wspoolcover/toldos/cortijo/muebles_disponibles.png

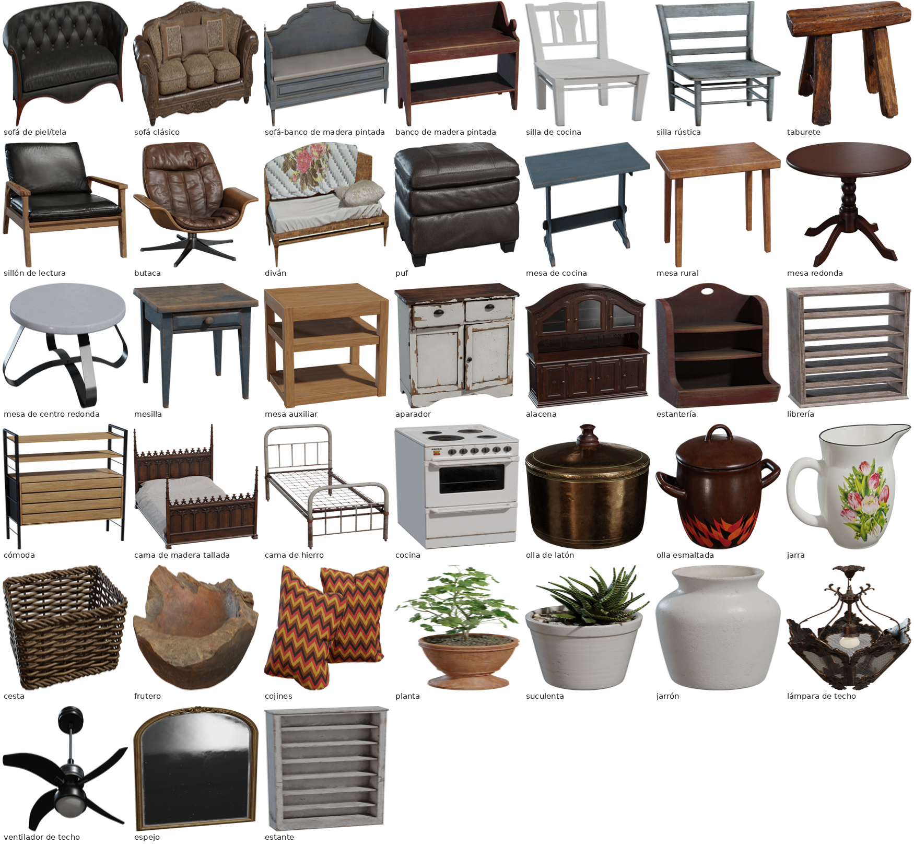
cortijo/muebles_disponibles.png
