wspoolcover/toldos/cortijo/render_entrada_escalera.png

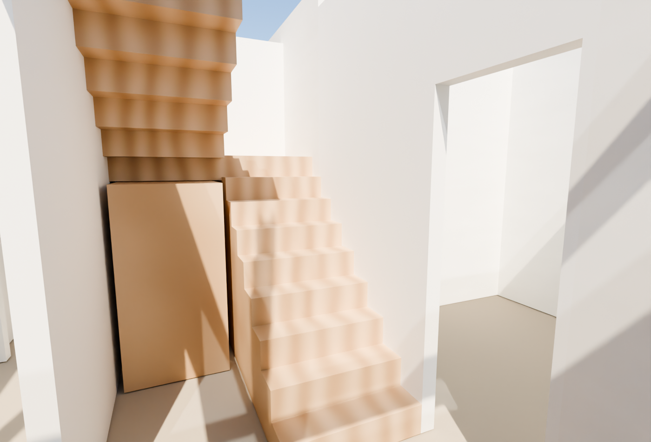
cortijo/render_entrada_escalera.png
