wspoolcover/toldos/cortijo/docs/08_presupuesto_y_ahorro.md

# Presupuesto orientativo y plan de ahorro (v7; la v8 mueve la escalera y la cocina pero no cambia las partidas, 13-10-2026)

Rangos de referencia en España 2026 para unos 172 m² construidos (109 m² útiles abajo + 63 arriba + terraza de 43 m²). **No es un presupuesto de contratista**: sirve para ordenar decisiones y pedir ofertas comparables. IVA no incluido (en rehabilitación de vivienda puede aplicarse el 10 %: consúltalo).

## 1. Partidas con la opción elegida (lo más barato que no baja la calidad)

| Partida | Opción elegida | Rango (€) | Alternativa cara descartada |
|---|---|---|---|
| Demolición cubierta, forjado y escalera (PL-05) | Elemento a elemento con apeos; acopio de vigas de madera para reutilizar | 6.000–10.000 | — |
| Cimentación: 6 zapatas 1,5 m, riostras, zuncho inferior, drenaje + geotextil | HA-25, B500S | 7.000–11.000 | — |
| Estructura metálica (3,7 t HEB/IPE + placas y anclajes) | Perfiles de serie, uniones atornilladas en obra | 11.000–20.000 | Primer diseño: 6,7 t |
| Forjados vigueta + bovedilla EPS (≈ 190 m²) y zunchos | (17+5) casa y cubierta, (25+5) salón | 11.000–17.000 | Chapa colaborante |
| Muros nuevos del salón (ladrillo 25 cm) + pilares de atado | Lo haces tú | 3.000–5.000 (material) | — |
| Cubierta plana: impermeabilización + XPS 10 cm + grava/sedum | Invertida, sedum solo en zonas libres | 9.000–14.000 | Césped natural (+5.000) |
| SATE transpirable 8 cm (lana mineral o corcho sobre mortero de cal), fachadas libres (≈ 220 m²) | Tapial: no usar EPS pegado | 11.000–17.000 | SATE en medianeras (+4.000) |
| Ventanas y cristalera (**PVC** con lámina de madera, bajo emisivo, control solar en sur, contraventanas) | **A precio de coste por WS Ventanas** | 6.000–10.000 | PVP: 12.000–18.000 |
| Tabiquería (ladrillo hueco doble o placa de yeso) | Placa de yeso con lana: más rápida y lleva las instalaciones | 5.000–8.000 | — |
| Solera + suelo radiante PB (109 m²) + mortero | Tubo PE-X paso 15 cm, 3 cm aislante | 6.000–9.000 | — |
| Aerotermia 8 kW + acumulador ACS 200 L + colector | Unidad exterior en la cubierta | 8.000–12.000 | Caldera de gasóleo + depósito |
| Multisplit planta alta (1 exterior + 4 interiores 2,5 kW) | Inverter A++ | 3.500–5.500 | Suelo radiante arriba (+6.000) |
| Fotovoltaica 7,2 kWp (16 paneles) + inversor 6 kW + batería opcional | Sin batería al principio | 7.000–10.000 (batería +4.000–6.000) | — |
| Electricidad completa (9,2 kW, 13 circuitos, red Cat 6, TV) | Mecanismos de gama media | 7.000–11.000 | Domótica (+3.000–8.000) |
| Fontanería y saneamiento (PPR, PVC, 3 húmedos, fosa) | Baño sobre baño: una columna | 5.000–8.000 | Fosa nueva si no vale (+3.000–5.000) |
| Chimenea insert 7 kW + humero doble pared | Leña | 3.000–5.000 | — |
| Cocina en U (muebles y encimera, sin electrodomésticos) | Módulos de serie | 3.500–6.000 | A medida: 9.000–15.000 |
| Baños (3) y vestidor: sanitarios, grifería, alicatado, armarios | Gama media; ducha de obra | 9.000–14.000 | — |
| Solados, alicatados, pintura, falsos techos, escalera de acero | Porcelánico gama media | 14.000–22.000 | — |
| Honorarios: arquitecto (modificación de proyecto), estructura, dirección, geotécnico, licencia | — | 9.000–15.000 | — |
| **Total orientativo** | | **≈ 140.000–225.000 €** | |

Con mano de obra propia en muros, pérgola, pintura y montaje de ventanas se puede bajar **15.000–30.000 €** más. El rango es amplio porque faltan geotécnico, catas y ofertas.

## 2. Ahorros aplicados ya en el diseño

1. Estructura: −3 t de acero respecto al primer diseño (≈ 6.000–16.000 €).
2. Ventanas a coste (≈ 6.000–8.000 €).
3. Cocina de serie en U, sin isla (≈ 5.000 €).
4. Baño sobre baño: una sola columna de bajantes y montantes cortos (≈ 1.000 €). Desde la v8 la cocina ya no está pegada al baño grande: su bajante va aparte al colector enterrado (unos 300 € más de tubería, estimación mía).
5. Splits arriba en vez de suelo radiante (≈ 6.000 €).
6. Sedum en vez de césped natural (≈ 5.000 € y sin riego).
7. SATE solo donde no hay vecino (≈ 4.000 €).
8. Armarios empotrados en tabiques de placa (≈ 2.000 € frente a armarios de mueble).
9. Sin batería al principio: la fotovoltaica cubre aerotermia y aire acondicionado de día; batería solo si la factura nocturna lo justifica.

## 3. Lo que no recomiendo recortar
Zunchos, riostras, zapatas, drenaje y geotextil, impermeabilización, aislamiento de cubierta, protección contra sobretensiones, toma de tierra en cimentación, toma de aire exterior de la chimenea, ventilación mecánica de los baños y la cocina.

## 4. Suelo radiante en los dormitorios: ¿sí o no?
- **Planta baja: SÍ**, en toda la planta (dormitorio principal, dormitorio 2, despacho y vestidor incluidos). La losa es la misma, el tubo cuesta ≈ 25–35 €/m² más y los dormitorios quedan a la misma temperatura que el resto sin radiadores. En verano el mismo circuito «refresca» (agua a 18-20 °C) de forma suave.
- **Planta alta: NO.** Motivos: (1) los dormitorios de arriba reciben el calor de la cubierta y necesitan **frío real** en verano, que el suelo radiante no da; (2) el forjado de vigueta está calculado con 1,2 kN/m² de pavimento: 6-7 cm de mortero + tubo suman ≈ 1,5 kN/m² más y habría que recalcular vigas y forjado; (3) un multisplit da frío y calor por 3.500–5.500 €. Si en el futuro se quiere más confort arriba, se añaden radiadores de baja temperatura a la aerotermia (ya se dejan los pasos de tubería previstos).
