wspoolcover/toldos/cortijo/pdf/Pedido_hierro_zunchos.pdf

# Pedido de hierro · zunchos, riostras y suelo

Acero corrugado B 500 S. Armados de la propuesta (docs/10); los confirma el técnico. Longitudes sacadas del modelo de la casa.

### Lo que hay que pedir

Qué | Se pide en | Cantidad | Metros | Kilos
Barra corrugada Ø16 (zunchos y riostras) | barras de 12 m | 111 | 1320 | 2083
Cercos Ø8 (cuadrados, cortados y doblados) | cercos | 1005 | 1419 | 560
Mallazo 15×15 Ø6 (suelo PB, 113,8 m² + 10 %) | paneles 2,20 × 6,00 | 10 | — | 391

### Por zuncho

Elemento | Largo | Sección | Ø16 a pedir | Cercos Ø8
RI-1 riostras (entre zapatas y muros) | 30.6 m | 40 × 50 cm | 269 m | 162 de 1.71 m
ZH-1 zuncho de los muros de 55 cm: forjado de planta alta | 34.3 m | 55 × 30 cm | 302 m | 242 de 1.61 m
ZH-2 zuncho de los muros del salón (terraza) | 20.8 m | 25 × 30 cm | 183 m | 147 de 1.01 m
ZH-1 zuncho de los muros de 55 cm: cubierta | 34.3 m | 55 × 30 cm | 302 m | 242 de 1.61 m
Muro exterior: 30 m más (25×30, como ZH-2) | 30.0 m | 25 × 30 cm | 264 m | 212 de 1.01 m
TOTAL | 150.0 m | | 1320 m | 1005

### Medida de los cercos

Zuncho | Medida interior (cm) | Largo de corte | Armado
RI-1 riostras (entre zapatas y muros) | 34 × 44 | 1.71 m | 4Ø16 + 4Ø16, cercos cada 20 cm
ZH-1 zuncho de los muros de 55 cm: forjado de planta alta | 49 × 24 | 1.61 m | 4Ø16 + 4Ø16, cercos cada 15 cm
ZH-2 zuncho de los muros del salón (terraza) | 19 × 24 | 1.01 m | 4Ø16 + 4Ø16, cercos cada 15 cm
ZH-1 zuncho de los muros de 55 cm: cubierta | 49 × 24 | 1.61 m | 4Ø16 + 4Ø16, cercos cada 15 cm
Muro exterior: 30 m más (25×30, como ZH-2) | 19 × 24 | 1.01 m | 4Ø16 + 4Ø16, cercos cada 15 cm

### Aparte, si se necesita en el mismo pedido

Qué | Metros | Barras de 12 m | Kilos
Parrilla de las 4 zapatas: Ø12 cada 15 cm en los dos sentidos | 258 | 22 | 229
Pilares de atado (≈ 22 uds): 4Ø14 de 3,9 m | 360 | 31 | 435
Cercos Ø6 de los pilares de atado (cada 15 cm) | 483 | — | 107

Cómo está calculado: barras con +10 % por solapes (unos 50 diámetros, 80 cm en Ø16), esquinas y mermas; cercos con +5 %; medida interior del cerco = ancho y canto menos 3 cm de recubrimiento por lado, y largo de corte = perímetro + 15 cm de ganchos. Los 30 m del muro exterior están calculados como zuncho de 25 × 30 con 4Ø16 + 4Ø16 (como el del salón). Si lleva otro armado, hay que recalcularlo.
El zuncho de los muros de 55 cm se hormigona en dos niveles (forjado de planta alta y cubierta). Si ahora haces solo el suelo, pide las filas de suelo y forjado.
Más ligero: con el armado del primer dossier (4Ø12 / 6Ø12) zunchos y riostras pesarían unos 825 kg, frente a 2143 kg de este armado.
