wspoolcover/toldos/cortijo/docs/21_adaptar_el_proyecto_a_la_realidad.md

# Adaptar el proyecto visado a la casa que se construye (04-11-2026)

El proyecto visado (PL-04 a PL-11, 22-09-2025) es el punto de partida. La casa que se construye es la del modelo v8, con las medidas del propietario y ampliada. Este documento lista **qué hay que cambiar en cada lámina** y **con qué datos**. No sustituye al arquitecto: es el material de trabajo para pasárselo.

## 1. Estado de obra: muros, forjado y tejado caídos (aviso del propietario, 04-11-2026)
Sobre la lámina PL-05 (fase 3) el propietario marca, y confirma por escrito:
- **Han caído**: el **muro norte de la casa** (el que separa el porche de la casa), el **muro central** («muro existente» de PL-11), el **forjado de la planta alta** (suelo de la planta 1, techo de la planta 0) y el **tejado**.
- **Según la marca del propietario, siguen en pie el muro este y el muro sur**, formando una L.
- **Foto interior (04-11-2026, mirando al sur desde dentro)**: se ve el suelo de tierra, sin solera; el **muro sur** al fondo, con dos ventanas y una puerta de doble hoja, en planta baja y con un tramo más alto en el centro; un **muro alto a la derecha**, con restos de tejas del vecino en lo alto; y un **muro alto a la izquierda**, con el conducto oscuro de una chimenea y el borde superior inclinado con restos de teja. En la base del muro de la izquierda hay huecos y falta revoco. Al pie del muro de la derecha hay una pequeña armadura en espera. **Pendiente**: confirmar cuál es cada muro (este, oeste, vecinos) y si el de la izquierda sigue en pie.
- **Pendiente de confirmar**: el **muro oeste** (no está marcado), la escalera y los muros nuevos del salón, si ya estaban levantados.

**Riesgo principal: los dos muros en pie están sueltos.** Con unos 6 m de altura (dos plantas) y 55 cm de espesor, la esbeltez es de 10–11, casi el doble del límite de 7 que fija el propio proyecto (PL-05, ADD-13: unos 3,85 m para muros de 55 cm sin arriostrar). Han perdido el forjado y los muros que los sujetaban. El muro este es medianera con la casa vecina.
1. **Zona de exclusión**: nadie a una distancia menor que la altura del muro (unos 6 m), por ninguno de los dos lados, hasta que lo revise un técnico. Con viento o lluvia, más.
2. **No tocar ni empujar** esos muros, ni trabajar en su base, ni sacar escombros pegados a ellos.
3. **Apeo provisional** (puntales inclinados con su anclaje) diseñado por el arquitecto o un ingeniero, o derribo controlado si lo decide. Lo hace una empresa con técnico.
4. **Avisar ya al arquitecto** (director de obra) y al seguro de obra, si lo hay. Si los muros se inclinan, se abren grietas o hay personas viviendo en las casas pegadas, avisar a la Policía Local o al 112. Esto último es una precaución; no sé valorar el riesgo real sin verlos.
5. **Documentar**: fotos de todos los lados y de las grietas, fecha y hora, qué pasaba (obra, lluvia, viento). No retirar escombros sin fotos.
6. **Cubierta**: si el tejado llevaba placas onduladas de fibrocemento, no se rompen ni se barren; las retira una empresa autorizada.

Lo que cambia en el proyecto:
- **PL-05**: las fases 1 y 2 (demolición de la cubierta y del forjado) ya han pasado, pero sin control. La fase 3 («consolidación y recrecido de muros») pasa a ser **reconstrucción de los muros caídos y consolidación de los dos que quedan**.
- **PL-11**: el proyecto visado se apoyaba en el muro central, que ya no existe. Nuestra estructura (pilares HEB 120, vigas y forjados nuevos) no depende de los dos muros caídos, pero sí del **muro este y el sur**, que hay que comprobar, y del **oeste**, que hay que ver.
- **Encaje urbanístico**: es una pregunta para el arquitecto: si haber perdido los muros, el forjado y la cubierta cambia la naturaleza de la obra (de rehabilitación a reconstrucción) y qué tramitación exige. No sé responderla.
- **Cimentación**: bajo los muros caídos puede seguir su zapata, y hay que ver también la de los dos muros en pie. Cata antes de hormigonar la línea y = 7,60 (ver `19_comprobacion_cimentacion.md`).
- **Pedido 1 de hierro**: las cantidades de zapatas, riostras y zanja perimetral siguen valiendo. La zanja perimetral supone muros exteriores en todo el perímetro; si hay que reconstruir los del norte y el oeste, hay que decidir antes con qué.

## 2. Superficies de la casa que se construye (modelo v8)
Superficies útiles por estancia. La planta baja cambia algo según la opción elegida (A, B, C, C2 o D; ver `15_propuestas_planta_baja.md`); aquí va la base v8.

| Planta baja | m² | Planta alta | m² |
|---|---|---|---|
| Salón con comedor | 33,91 | Sala familiar | 12,03 |
| Pasillo de entrada (junto al salón) | 11,05 | Entrada | 3,50 |
| Entrada | 3,12 | Baño | 3,48 |
| Escalera | 4,62 | Dormitorio 1 | 13,19 |
| Baño grande | 5,76 | Dormitorio 2 | 16,77 |
| Sala de estar y paso | 11,07 | Dormitorio 3 / despacho | 14,80 |
| Cocina | 9,36 | | |
| Dormitorio principal | 12,09 | | |
| Dormitorio 2 | 9,73 | | |
| Despacho | 3,79 | | |
| Vestidor | 5,75 | | |
| Baño principal | 3,70 | | |
| **Total útil planta baja** | **113,94** | **Total útil planta alta** | **63,77** |

**Total útil: 177,71 m²**, más la terraza sobre el salón (42,42 m²).

| | Proyecto visado | Casa que se construye |
|---|---|---|
| Útil planta baja | 91,45 m² (con el porche de 23,49) | 113,94 m² |
| Útil planta alta | 63,63 m² | 63,77 m² |
| **Útil total** | **155,08 m²** | **177,71 m²** |
| Terraza | 23,00 m² | 42,42 m² |
| Construida | 200,00 m² (PB 115,35 + PA 84,65) | **≈ 233 m²** por huellas: PB 142,4 (casa 94,5 + salón 47,9) y PA 90,3 |

La superficie construida es mía, por las huellas exteriores; el arquitecto la calcula con su criterio (terrazas, porches, muros).

## 3. Qué hay que cambiar en cada lámina
| Lámina | Qué hay que cambiar | Datos nuestros que sirven |
|---|---|---|
| **PL-04** estado actual | Lo que había antes de caer los muros. Añadir el estado actual de obra y los muros caídos | Fotos y medidas de obra (pendientes) |
| **PL-05** fases | Nueva secuencia: muros caídos, apeos, cimentación nueva (zanja perimetral, riostras, zapatas), estructura de acero, forjados, salón. La fase 3 («consolidación y recrecido») cambia | `docs/16_ideas_de_obra_referencia.md` y el orden de obra del primer borrador (`dossier_obra.pdf`, hoja 6) |
| **PL-06** distribución y superficies | Plantas, alzados y sección nuevos: salón cerrado, distribución de la v8 (o la opción elegida), cubierta plana con paneles | `lamina_A1_v8_distribucion.dxf`, `planta_baja_v8.dxf`, `planta_alta_v8.dxf`, `seccion_A_v8.dxf`, `seccion_B_v8.dxf`, cuadro del apartado 2 |
| **PL-07** cotas y carpintería | Cotas nuevas, memoria de carpintería (puertas de seguridad, cristalera de aluminio al patio, ventanas con asiento), detalle de fachada | `pedido_proveedores.xlsx` (huecos), planos `lamina_A1_v8_*`, `docs/03_envolvente.md` |
| **PL-08** fontanería y ventilación | Red nueva (baños agrupados, aerotermia, depósito, paneles solares) | `docs/02_instalaciones.md`, `instalaciones.png` |
| **PL-09** saneamiento | Colector Ø150, arquetas, fosa séptica y pozo filtrante con posición y capacidad | `docs/18_fosa_septica_y_pozo_filtrante.md`, `fosa_septica_esquema.png`, `pozo_filtrante_5m.png` |
| **PL-10** electricidad | Circuitos nuevos, aerotermia, paneles solares (7,2 kWp), electrificación elevada de 9,2 kW | `docs/02_instalaciones.md`, `cubierta_solar.png` |
| **PL-11** cimentación y estructura | Cimentación nueva (zapatas, riostras, zanja perimetral), pilares y vigas de acero en lugar del muro central, forjados, zunchos, escalera de hormigón y losa sobre el salón | `cimentacion_planos.png`, `cimentacion_anillos.png`, `lamina_A1_v8_estructura.dxf`, `estructura_planos.png`, `memoria_estructura.md`, `19_comprobacion_cimentacion.md` |

## 4. Lo que condiciona el proyecto adaptado
1. **Estado de los dos muros que quedan** (este y sur) y del oeste: inclinación, grietas, altura y qué los sujeta (fotos y medidas).
2. **Elección de la distribución de la planta baja** (A, B, C, C2, D o la económica).
3. **Estudio geotécnico**: el 130 kPa de PL-11 es supuesto. Recomiendo una calicata en una zapata y otra en el pozo filtrante, el mismo día.
4. **Cálculo de la estructura** de acero y de la losa sobre el salón (5,75 m), con ficha del fabricante, por un técnico competente.
5. **Fosa y pozo filtrante**: posición, capacidad y autorización de vertido.
6. **Comunicación con el arquitecto** sobre qué documentación necesita (modificado o proyecto nuevo).

## 5. Orden que propongo (el propietario quiere empezar ya con la cimentación y el hormigón)
Decisión del propietario (04-11-2026): empezar cuanto antes la cimentación y el hormigón, porque eso es lo que afianza los muros existentes. Es una secuencia razonable, con una precisión: **lo de abajo (zanja, zapatas) no sujeta la parte alta de los muros**; la sujetan los puntales ahora y el zuncho de arriba con los pilares y el forjado después. Además, abrir zanjas al pie de un muro suelto es el momento más peligroso. Por eso:
1. **Apeo mínimo de los muros altos antes de que entre nadie a trabajar** en la zona de peligro (en el plano cubre el 93 % del interior). Puntales inclinados; los define el arquitecto o un ingeniero.
2. **Cata puntual** para ver la zapata de cada muro antes de abrir la primera zanja junto a él: no se baja de la cota de su base.
3. **Zanja perimetral por bataches alternos** (`cimentacion_bataches.png`, 23 bataches de ≈ 1,5 m): uno sí y uno no, y cada uno se abre, se arma y se hormigona el mismo día. La segunda tanda, cuando la primera haya endurecido. HA-25/F/32/XC2 con limpieza de HM-20.
4. **Pedido 1 de hierro ya** (`pedido_1_hierro_cimentacion.xlsx`). Las barras de las zapatas y riostras de la línea y = 7,60, sin cortar hasta ver qué hay debajo.
5. **Riostras y zapatas** en el interior, donde ya no hay muros: es el tajo menos expuesto, pero sigue dentro de la zona de peligro hasta el apeo.
6. **Pilares de atado y zuncho de coronación** en los muros que queden, junto con los pilares HEB y las vigas: aquí es donde los muros quedan atados de verdad. El apeo se mantiene hasta entonces.
7. **Forjado y cubierta**. Los apeos se quitan solo cuando el técnico lo diga.
8. En paralelo: aviso al arquitecto, fotos y medidas de los muros, catas y estudio geotécnico.
