wspoolcover/toldos/cortijo/docs/01_documentos_disponibles.md

# Documentos del cortijo: qué hay y qué falta

Revisado en tu Drive el 12-10-2026. Carpeta **CORTIJO PISICA**: solo contiene los 10 planos del proyecto del arquitecto (Andrés Oller Rodríguez, expediente 25-029, julio 2025). No he abierto ni usado el contrato de arras ni ningún documento de la empresa.

> Las copias de la carpeta de Drive son una **versión anterior** al visado del 22-09-2025: en la versión visada la superficie construida total es de 200,00 m² (PL-06: PB 115,35 + PA 84,65). Las superficies de PL-04 y PL-06 son las del proyecto original. La casa **se ha agrandado**: las medidas válidas son las del croquis a mano del propietario, que son las que usa el modelo.

## Lo que hay (PL-01 a PL-10)
| Plano | Contenido | Para qué lo usamos |
|---|---|---|
| PL-01 | Situación PGOU, 1/15.000 | Ubicación: polígono 33, parcela 198, San Roque, Albox |
| PL-02 | Emplazamiento, ortofoto y catastro, 1/400 | Referencia catastral 04006A033001980001PG |
| PL-03 | Georreferenciación (14 puntos UTM) | Replanteo y orientación real del solar |
| PL-04 | Estado actual: 96,77 m² útiles PB + 68,06 PA = 164,83 m² útiles; construidos 200 m² | Superficies de partida |
| PL-05 | Fases: demolición de cubierta y forjado/escalera, consolidación y recrecido de muros, forjados nuevos | Orden de obra del arquitecto |
| PL-06 | Distribución reformada (PB 91,45 / PA 63,63 útiles; construidos 195,48 m²) | Es el plano que partimos |
| PL-07 | Carpintería: aluminio lacado blanco, vidrio 4/8/4 con persiana | Hay que mejorarla (ver envolvente) |
| PL-08 | Fontanería: PPR, termo de 100 L, intercambiador solar | Base de la red de agua |
| PL-09 | Saneamiento y pluviales: conexión a **fosa séptica** | Base de la red de desagües |
| PL-10 | Electricidad: esquema unifilar y circuitos | Base de la red eléctrica |
| PL-11 | **Cimentación y estructura** del arquitecto: forjados de vigueta T-20 con bovedilla de 20 cm (canto 25+5), vigas HEB-160 / HEB-220 / IPE-240, muro existente central, zunchos Z-1 de 40×30 con 4Ø12 arriba y 4Ø12 abajo y cercos Ø8/20, hormigón HA-25/F/32/XC2 en cimentación, acero B400S, recubrimiento de 80 mm contra el terreno, NCSE-02 ductilidad baja, **tensión admisible del terreno 0,13 MPa (130 kPa)** | Dato de terreno y secciones de referencia (está en el PDF visado `PLANOS_A1_R01_F_signed3.pdf`, no en la carpeta de Drive; ver `20_proyecto_original_y_diseno_actual.md`, donde se compara con la versión visada del 22-09-2025) |

## Lo que NO tenemos (hay que conseguirlo)
1. **Estudio geotécnico**: el único dato de terreno es el de PL-11 (130 kPa, «considerado», no medido). Hay que confirmarlo con un estudio.
2. **Cimentación existente**: ningún plano dice ancho, profundidad ni armado de la zapata de los muros de 0,55 m.
3. **Memoria de cálculo de la estructura** del arquitecto (solo tenemos el plano PL-11 con secciones y cargas, no el cálculo).
4. **Estado de los muros** (mampostería o ladrillo, humedades, grietas).
5. **Certificado/justificación energética** (DB-HE) y cálculo de la calefacción.
6. **Licencia, nota simple y mediciones o presupuesto de obra.**
7. **Zona sísmica del municipio** (NCSE-02): usamos 0,16 g como suposición.

Observaciones sobre los planos que conviene aclarar con el arquitecto:
- PL-10 titula los circuitos «electrificación elevada», pero la potencia que figura (5.375 W) corresponde a una electrificación básica. Con cocina de inducción, calefacción y aire acondicionado hay que contratar elevada (9,2 kW).
- PL-07 deja ventanas con vidrio 4/8/4 y aluminio sin rotura de puente térmico (no lo indica): no cumple lo que hoy se pone en obra nueva en la zona.

## Vecinos y linderos (dato del propietario, 12-10-2026)
- **Norte** (la parte estrecha del salón): el **acceso por el camino**, con entrada de unos 7 m con puerta corredera (hay un raíl de hormigón) y la acometida de agua. **Sur** (fachada ancha con la CGP): terreno propio hacia la **rambla de Albox**.
- **Este y oeste**: casas vecinas **pegadas** (medianeras), incluidos los muros laterales del salón. En PL-04 y PL-06 figuran como «VIVIENDA» y el saliente oeste como «encabalgamiento otra propiedad».
- Consecuencias aplicadas: **sin ventanas en los muros este y oeste** (se quitó la ventana este de la cocina, la del baño grande, la del baño de la suite y la este del dormitorio 3); los baños se ventilan con extractor; la unidad exterior de la aerotermia va al patio sur; la acometida de agua y la eléctrica entran por el sur y la fosa séptica está al norte, como en PL-08, PL-09 y PL-10.
- A comprobar: vistas sobre fincas vecinas a menos de 2 m (art. 582 del Código Civil), la altura de los parapetos de la terraza junto a las medianeras y quién construye cada medianera.
