wspoolcover/toldos/cortijo/docs/15_propuestas_planta_baja.md

# Propuestas para la planta baja (14-10-2026)

Cambios pedidos: cocina en medio más grande y amplia, con salida de aluminio al exterior; puerta del vestidor pegada al dormitorio, que abra hacia la derecha y sea una puerta buena; paredes y accesos de los dormitorios fuertes, de seguridad; dormitorio 2 más pequeño; ventanas pegadas al exterior del muro para hacer un asiento de lectura en el hueco. Planos: `modelos_planta_baja.png` (comparación) y `modelo_A_planta_baja.png`, `modelo_B_...`, `modelo_C_...`.

## 1. Lo que he buscado y lo que he encontrado
Las búsquedas dieron poco sobre casos concretos; lo que sigue es lo aprovechable y lo que sale de mi criterio. Lo que no he podido confirmar lo digo.

- **Cortijo y patio.** El cortijo tradicional se organiza alrededor de un patio, con las habitaciones a su alrededor y muros encalados ([Junta de Andalucía, inventario de cortijos](https://www.juntadeandalucia.es/sites/default/files/2021-09/cortijos_andalucia_2019.pdf); [Escapada Rural](https://www.escapadarural.com/blog/casas-rurales-tipicas-espanolas/)). De ahí la idea de abrir la cocina al patio sur con una salida grande. No he encontrado fuentes sobre el derrame de las ventanas en muros de tapial: eso lo decide quien haga la obra.
- **Asiento en la ventana.** Medidas habituales: banco de unos 38 cm más cojín de 8 cm (≈ 46 cm de asiento), profundidad mínima de 56 cm para una persona y 76–91 cm para estar cómodo, largo mínimo de 91 cm; cajones debajo para guardar ([This Old House](https://www.thisoldhouse.com/furniture/sitting-pretty-with-window-seats); [Living Etc](https://www.livingetc.com/ideas/window-seat-ideas)). Un muro de 55 cm con la ventana a 10 cm del exterior deja unos 40 cm de hueco: sirve para sentarse. Para leer con las piernas subidas, el banco puede salir 15–20 cm hacia la habitación (60 cm en total).
- **Salida de aluminio.** Las correderas de aluminio con rotura de puente térmico son lo habitual para grandes acristalamientos hacia un patio, con perfiles finos (≈ 21 mm de marco visto) y de dos a cuatro hojas ([IQ Glass](https://www.iqglassuk.com/projects/illidge-green-farm/s154192/); [NBS, Slide 2000](https://source.thenbs.com/product/slide-2000-patio-doors/traS3xBcJBHgR5pFBttXdm?lb=open)). Un fabricante cita U ≈ 1,6 W/m²K para el conjunto con el vidrio de su ejemplo; hay que pedir la ficha del producto concreto.
- **Puertas de seguridad.** La norma UNE-EN 1627 clasifica de RC1 a RC6 la resistencia al robo; RC2 resiste unos 3 min a un ladrón oportunista, RC3 unos 5 min (con palanca de 70 cm), RC4 unos 10 min. Una «blindada» suele ser RC2 o sin certificar; una «acorazada» (hoja y marco de acero como un conjunto) parte de RC3. El ensayo no garantiza el anclaje: una puerta RC4 mal anclada rinde como RC2, así que el marco debe ir anclado al muro ([Selectra](https://selectra.es/alarmas/medidas-seguridad/puerta-blindada-o-acorazada)). Datos de fuente comercial: contrastar con el fabricante.
- **Muros de seguridad.** No he encontrado fuente fiable con espesores. Lo que propongo abajo es criterio mío y lo debe validar el técnico.

## 2. Lo común a los tres modelos
- **Muros de seguridad de 15 cm** (hormigón armado HA-25 con doble malla Ø8/15, o bloque de hormigón de 20 cm relleno y armado, como el bloque gris de las fotos de referencia de `16_ideas_de_obra_referencia.md`; a decidir con el técnico) en: la pared del vestidor hacia la sala, la pared norte de la suite, la pared entre la suite y la cocina o el dormitorio 2, y, en el modelo A, las del dormitorio 2. En total unos 49 m² de muro en el modelo A y unos 32 m² en B y C. Orden de magnitud del sobrecoste frente a tabique: 4.000–7.000 € en A y 2.500–4.500 € en B y C (estimación mía; pedir presupuesto).
- **Puertas de seguridad (RC3, de acero, marco anclado al muro, bisagras antipalanca, cilindro con protección antitaladro)** en el vestidor (sala → vestidor), en la puerta de la suite al vestidor y en el dormitorio 2 si existe. Ancho 0,90 m.
- **Puerta del vestidor** (la que da a la sala): sube al extremo sur de la pared, pegada a la pared del dormitorio; bisagra en el lado derecho al entrar (el sur); abre hacia el vestidor y queda doblada contra la pared de la suite sin estorbar. La puerta de la suite al vestidor queda a un metro. *Si te referías a la puerta entre el vestidor y el dormitorio, dímelo y la muevo.*
- **Ventanas con asiento** en el muro sur (55 cm): ventana a ras del exterior (a 10 cm de la cara de fuera, con contraventanas de madera por fuera), banco de obra de 45 cm de alto con cajón, cojín y enchufe/luz de lectura. Suite: ventana de 1,30 m con asiento (rincón de lectura de Cristina) y otra de 0,90 m. Dormitorio 2 o comedor: otro asiento de 1,00 o 0,90 m. Las separaciones entre ventanas son de 55 cm como mínimo (en un muro de tapial no conviene menos).
- **Salida de aluminio al patio** desde la cocina (suelo a techo, vidrio laminado de seguridad, rotura de puente térmico, cierre multipunto) y el patio sur cubierto con una pérgola, con el mismo solado de barro cocido.
- **Cocina abierta a la sala de estar**, con paso libre (sin puerta) y despensa baja bajo la escalera, con puerta desde la cocina.
- Todo lo demás es la v8: escalera con el pie junto a la entrada, baño grande desde la entrada, armario técnico bajo la escalera.

## 3. Los tres modelos
| | **A · Dormitorio 2 pequeño y cocina al este** | **B · Cocina-comedor grande** | **C · Cocina central con despensa y lavadero** |
|---|---|---|---|
| Dormitorio 2 | **7,5 m²** (1,95 × 3,85 m, cama individual, armario de 45 cm, asiento en la ventana) | No hay abajo | No hay abajo |
| Cocina | 11,2 m² con mesa de comedor junto a la salida acristalada de 1,60 m | **19,6 m²**: cocina con isla y comedor, salida de 2,40 m y banco-asiento en la ventana | 13,4 m² con mesa; salida de 1,60 m y banco-asiento |
| Anexos | Despensa baja bajo la escalera | Despensa baja bajo la escalera | Despensa 2,0 m² y lavadero 3,7 m² con ventana |
| Paso sala ↔ cocina | 1,25 m | 3,05 m (dos huecos de 1,60 y 1,45 m) | 3,05 m (dos huecos de 1,60 y 1,45 m) |
| Dormitorios en la casa | 5 (suite + dormitorio 2 + 3 arriba) | 4 (suite + 3 arriba) | 4 |
| Ventaja | Cumple tu petición al pie de la letra | La cocina que pides: amplia y abierta | Cocina de cortijo con despensa y lavadero; el lavadero puede ser un cuarto de plancha o, más adelante, una habitación pequeña |
| Inconveniente | La cocina crece solo un 20 % (la escalera y el dormitorio 2 limitan) | Pierdes el dormitorio 2 de abajo | Pierdes el dormitorio 2 de abajo; menos «comedor» |

### Opción C2: el modelo C con el despacho girado (14-10-2026)
Pedido: cocina central y despacho girado, de la puerta del vestidor hasta la chimenea. Plano: `modelo_C2_planta_baja.png`; PDF de la opción: `pdf/Opcion_C_cocina_central.pdf`. Versión económica: `17_version_economica.md`.
- **Cocina central** de 13,4 m² abierta a la sala por dos pasos libres (1,60 y 1,45 m), con mesa, salida de aluminio de 1,60 m al patio sur y asiento de lectura en la ventana; despensa de 2,0 m² y lavadero de 3,7 m² al este.
- **Despacho girado**: pasa de 2,40 × 1,58 m (3,8 m²) a **1,80 × 2,65 m (4,8 m²)**, a lo largo de la pared del vestidor, desde la puerta del vestidor hasta la chimenea. Mesa larga contra la pared del vestidor, estantería y sillón de lectura junto a la puerta, y cristal fijo en el extremo norte hacia el salón y la chimenea. La puerta es desde la sala de estar, que baja de 11,1 a 10,1 m².
- Si quieres ver el fuego desde el despacho, la chimenea se gira o se hace de dos caras con cristal; lo dejo como opción.

### Opción D: suite a la izquierda, cocina en medio y dormitorio pequeño con armario bajo la escalera (15-10-2026)
Plano: `modelo_D_planta_baja.png`; PDF: `pdf/Opcion_D_suite_cocina_dormitorio.pdf`. Mantiene el despacho girado del C2.
- **Suite grande** (11,9 m²) a la izquierda, con el vestidor y su puerta de seguridad pegada al dormitorio y el asiento de lectura en la ventana.
- **Cocina en medio** de 9,4 m², abierta a la sala por un paso libre de 1,60 m, con salida de aluminio de 1,40 m al patio sur.
- **Dormitorio 2 pequeño** (9,5 m²) a la derecha, con puerta de seguridad desde la sala, cama de 1,50 m y asiento en la ventana.
- **Armario incorporado bajo la escalera** de unos 2,0 m², que se abre desde el dormitorio 2 con puertas correderas. Altura libre de 1,5 m bajo la meseta y de 1,5 a 2,1 m bajo el tramo de vuelta (prendas largas en la parte norte). Para ello la meseta pasa a ser losa y el armario técnico se traslada al rincón bajo el tramo de vuelta, junto a la entrada.

**Por qué no hay un modelo con la cocina en medio mucho más grande y el dormitorio 2 en el este:** el único acceso a esa zona desde la sala es un paso de 0,9 m (entre el pilar de x = 7,20 y el final del hueco de la escalera). Si la cocina avanza hacia el este, el dormitorio 2 se queda sin puerta. Por eso en el modelo A el dormitorio 2 pasa al centro y la cocina al este.

**Mi recomendación**: **B** si prefieres una cocina de verdad grande y puedes renunciar al dormitorio 2 de abajo (arriba ya hay tres dormitorios); **A** si quieres conservar cinco dormitorios. Cualquiera de los dos mantiene el paso libre de la sala a la cocina.

## 4. Muebles y estética (para los renders)
He bajado 38 piezas libres (licencia CC0, [Poly Haven](https://polyhaven.com), sin atribución obligatoria) en texturas de 1k: sofás, butacas, mesas y sillas de madera pintada, aparador, alacena, estanterías, cama de madera tallada y de hierro, cocina, ollas de latón, jarras, cestas, cojines, plantas, lámparas y espejo. Están en `muebles_disponibles.png` y se vuelven a bajar con `python descargar_muebles.py`. No hay armarios de cocina ni camas modernas libres de calidad: los hago yo en el modelo (frentes de madera, encimera de piedra, colchón con almohadas).

Paleta del render: cal blanca, piedra marés, madera oscura, barro cocido en suelos y exterior, hierro negro en rejas y barandillas. Estilo de cortijo andaluz con toques mallorquines (arcos rebajados en los pasos entre sala y cocina, vigas vistas en el salón).

## 5. Qué necesito de ti
1. **Modelo** A, B o C (o una mezcla, por ejemplo B con el lavadero de C).
2. Confirmar la **puerta del vestidor** (sala → vestidor) y su apertura.
3. Si «luminio» era **aluminio** (lo he entendido así: salida de aluminio) o **luminoso** (la salida grande y con mucha luz; el diseño sirve para las dos cosas).
4. Si en la planta alta quieres también **asientos en las ventanas** del sur y **paredes de seguridad** (ahora solo lo he aplicado abajo, como dijiste).

Con tu OK: modelo 3D v9 con el modelo elegido y los muebles reales, 6–8 renders (cocina, suite con el asiento, vestidor, salón, patio sur, exterior), planos DXF y el PDF actualizados.
