wspoolcover/toldos/cortijo/docs/17_version_economica.md

# Versión económica y rápida (14-10-2026)

Es la misma casa de la opción C2 (cocina central y despacho girado), con las decisiones que bajan el coste y el plazo **sin tocar la cimentación, la estructura, el aislamiento, la impermeabilización ni la seguridad de la suite**. Todas las cifras son estimaciones mías en miles de euros, sin IVA, y salen de `08_presupuesto_y_ahorro.md` y de los precios citados en `02_instalaciones.md` y `15_propuestas_planta_baja.md`. **No es un presupuesto**: sirve para ordenar decisiones y pedir ofertas comparables.

## 1. Reglas
- **No se recorta**: cimentación y drenaje, estructura y apeos, impermeabilización de la cubierta, aislamiento transpirable de las fachadas, instalación eléctrica y de agua, ventilación de baños y cocina, y la seguridad de la suite.
- **Se simplifica**: acabados, climatización, tamaño y número de elementos especiales, y se hace por fases.
- **Se usan sistemas rápidos**: bloque de hormigón en U para zunchos y dinteles (sin madera de encofrado), tabique de placa de yeso donde no hace falta seguridad, ventanas y puertas de medidas estándar pedidas al principio, multisplit en lugar de suelo radiante (no hay que esperar al curado del mortero).

## 2. Qué cambia y cuánto cuesta
| Partida | Qué cambia en la económica | Completa (mil €) | Económica (mil €) |
|---|---|---|---|
| Demolición y apeos | Igual: elemento a elemento, con apeos. | 6–10 | 6–10 |
| Cimentación y drenaje | Igual. No se recorta: zapatas, riostras, zunchos, drenaje y geotextil. | 7–11 | 7–11 |
| Estructura de acero | Perfiles en bruto de tu proveedor, cortados a la lista del Excel, y atornillados en obra. Dinteles de los muros nuevos con bloque en U en lugar de perfil. | 11–20 | 9–15 |
| Forjados y zunchos | Vigueta y bovedilla en todo (sin placas alveolares ni grúa). Zunchos con bloque en U, sin madera de encofrado. | 11–17 | 10–15 |
| Muros nuevos del salón y pilares de atado | Igual (material; mano de obra tuya). | 3–5 | 3–5 |
| Cubierta plana | Impermeabilización y aislamiento iguales; grava de lastre en vez de sedum. | 9–14 | 7–11 |
| Aislamiento transpirable de fachadas | Lana mineral de 6 cm en vez de 8 sobre mortero de cal, solo en fachadas libres. Nunca poliestireno pegado sobre el tapial. | 11–17 | 9–14 |
| Carpintería: ventanas y salida de la cocina | PVC de medidas estándar a precio de coste; salida de la cocina en PVC de 2 hojas de 1,40 m en vez de corredera de aluminio de 1,60 m. | 8–14 | 5,9–9,8 |
| Seguridad: muros, puertas, rejas y asientos | Misma seguridad en la suite: bloque relleno de 20 cm, 2 puertas RC3 de serie y rejas de hierro sencillas de tu proveedor; vidrio laminado solo en la suite; asientos de obra sin cajones. | 8,2–16,1 | 5,6–10,8 |
| Tabiquería e interiores | Placa de yeso con lana en los tabiques que no son de seguridad; puertas lisas de serie. | 5–8 | 4,5–7 |
| Climatización, agua caliente y solera | Multisplit en las dos plantas, chimenea y aerotermia solo para el agua caliente, en vez de aerotermia con suelo radiante. Solera sin tubo. | 20,5–31,5 | 14,8–21,8 |
| Fotovoltaica | 8 a 10 paneles ahora, con la canalización dejada para ampliar. | 7–10 | 4–6 |
| Electricidad y red | Mecanismos de gama media-baja y precableado de alarma. | 7–11 | 6–9 |
| Fontanería y saneamiento | Igual en lo esencial (la cocina central lleva su bajante). | 5–8 | 5–7,5 |
| Cocina | Mueble básico y encimera laminada o de compacto. | 3,5–6 | 2,5–4,5 |
| Baños, vestidor y armarios | Gama básica, ducha de obra, armarios empotrados en placa. | 9–14 | 6,5–10 |
| Solados, pintura, falsos techos y escalera | Porcelánico efecto barro estándar; pintura y encalado tuyos; escalera de acero con peldaños de madera. | 14–22 | 10–16 |
| Honorarios | Reutilizando el proyecto de legalización; el geotécnico y el ingeniero no se recortan. | 9–15 | 8–13 |
| **Total** | | **154–250** | **124–196** |

**Ahorro estimado: 30–53 mil € (≈ 21 %)**. La versión completa ya incluye lo que has pedido hoy (muros y puertas de seguridad, salida de aluminio y asientos en las ventanas), por eso supera el rango de `08_presupuesto_y_ahorro.md` (140–225 mil €). Con mano de obra propia en muros, pintura y montaje de ventanas se puede bajar entre 15 y 30 mil € más en cualquiera de las dos. El rango es amplio porque faltan el geotécnico, las catas del tapial y las ofertas. Gráfico: `version_economica_costes.png`.

## 3. Paquete de seguridad económico
Se mantiene lo que más protege y se evita lo que solo cambia el acabado.
1. **Paredes de la suite**: bloque de hormigón de 20 cm relleno de hormigón y armado, en el vestidor (hacia la sala), en el lado norte y en el lado este del dormitorio. Unos 32 m² de muro. El ladrillo hueco no vale: se taladra.
2. **Dos puertas de seguridad RC3** (vestidor y dormitorio), de acero y de serie, con el marco anclado al muro y cilindro con protección antitaladro. Lo que importa es el anclaje: una puerta bien certificada y mal anclada rinde mucho menos ([Selectra](https://selectra.es/alarmas/medidas-seguridad/puerta-blindada-o-acorazada)).
3. **Rejas de hierro sencillas** en las ventanas de la planta baja, de tu proveedor de hierro: son típicas del cortijo, baratas y seguras. Contraventanas de madera o PVC por fuera.
4. **Vidrio laminado** (33.1) en las ventanas de la suite y 44.2 en la cristalera del salón, con cierre multipunto.
5. **Acceso**: puerta corredera de 7 m motorizada con cancela peatonal, luz exterior y videoportero.
6. **Precableado de alarma y cámaras** (tubos vacíos), por poco dinero ahora y mucho más caro después.
7. **Planta alta**: puertas macizas con cerradura de seguridad y paredes normales (no RC3). Si quieres más, se amplía después.

## 4. El plano
`modelo_C2E_planta_baja.png`: igual que el C2 con una sola despensa-lavadero de 5,9 m² y una puerta, salida de la cocina en PVC de 1,40 m y rejas en las ventanas de la planta baja. La planta alta es la de la v8 sin cambios.

## 5. Plazos y fases
Las duraciones son orientativas y las tiene que confirmar el constructor.
- **Fase 1, casa habitable (planta baja y estructura completa)**: demolición y apeos, cimentación, estructura de acero, forjados y cubierta, cerramientos y muros de seguridad, carpintería, instalaciones y acabados de la planta baja. Unos 6 a 8 meses.
- **Fase 2, planta alta**: tabiques, instalaciones, acabados y splits. Unos 2 a 3 meses, con la casa ya habitada abajo.
- **Fase 3, extras**: pérgola del patio sur, ampliar los paneles solares, aerotermia y suelo radiante si se quiere, y batería. Cuando convenga.
- **Lo que acorta el plazo**: pedir al principio ventanas y puertas de medidas estándar (tardan semanas), usar bloque en U sin encofrado, tabique seco y splits, que se montan al final sin esperar al mortero.

## 6. Lo que queda preparado para ampliar
- **Suelo radiante**: dejar 7 cm de altura libre en la planta baja para poder añadirlo más adelante (con los niveles de puertas y escalera ya resueltos).
- **Fotovoltaica**: canalización y espacio en la cubierta para los 16 paneles del diseño completo.
- **Pérgola y patio sur**: preparar el solado y la toma eléctrica.
- **Batería**: espacio y protecciones en el cuadro.

## 7. Compra por tu canal
Ventanas y puertas de PVC (≈ 37 m² y 13 puertas), el hierro en bruto (≈ 4,5 t) y las rejas, a precio de coste. El Excel `pedido_proveedores.xlsx` tiene las mediciones listas y la columna amarilla para tus precios. Pide al taller la lista de corte y el galvanizado de la escalera y las barandillas.

## 8. Qué podría subir el coste
Geotécnico y cimentación existente (el terreno parece arcilla agrietada), el estado de los muros de tapial al abrir huecos, los apeos, los vecinos pegados a ambos lados y la grúa si se acabara usando placa alveolar. Por eso no se recorta nada de lo estructural.
