wspoolcover/toldos/cortijo/docs/99_pendientes.md

# Pendientes y decisiones

## Para decidir (tú)
1. **Modelo de planta baja**: has pedido la opción C (cocina central) con el despacho girado, que es el modelo C2 de `15_propuestas_planta_baja.md`. Falta tu OK para pasarlo al modelo 3D.
2. **Puerta del vestidor**: queda la que da a la sala (pegada al dormitorio, bisagra a la derecha al entrar, puerta de seguridad), que es la que citas para el despacho.
3. **Salida de la cocina**: aluminio (así lo he entendido) o simplemente una salida grande y luminosa.
4. **Planta alta**: si también quieres asientos en las ventanas del sur y paredes de seguridad.
5. Piedra marés en el salón o todo encalado; color de la carpintería (madera oscura, media o blanco); pérgola de aluminio sobre parte de la terraza; patio sur cubierto.

6. **Versión completa o económica** (`17_version_economica.md`): qué partidas de la económica aceptas (climatización con splits, 8 a 10 paneles, puerta de PVC en la cocina, grava en la cubierta) y cuáles prefieres subir.

## Para completar (datos)
1. **Croquis de la finca** (aunque sea a mano): contorno, camino y acequia, puerta de 7 m, contador de agua, poste, fosa, caja general, vecinos y rambla; y el rumbo de la fachada ancha con la brújula del móvil. Así se calcula el sol real de los paneles y la terraza.
2. Si los muros de hormigón y la losa que se ven en las fotos son la cimentación del salón, y a qué altura sobre el terreno queda su suelo.
3. Posición real de la fosa séptica y de la caja general de protección.
4. Si se conserva la puerta doble vieja de la fachada sur.
5. Distancia a la rambla de Albox y si hay zona inundable.

## Para consultar con tu proveedor o constructor
1. Precio y plazo de **placas alveolares** (terraza del salón y cubierta) frente a vigueta y bovedilla; ver `16_ideas_de_obra_referencia.md`.
2. Bloque de hormigón relleno y armado para los muros de seguridad.

## Para encargar (técnicos)
1. **Estudio geotécnico**: el terreno parece arcilla agrietada; catas de la cimentación existente de la casa.
2. **Ingeniero de estructuras**: perfiles, brochales del hueco de la escalera (en L), uniones, sismo NCSE-02, resistencia al fuego, refuerzo de los muros de tapial por tramos.
3. **Muros y puertas de seguridad**: espesor y armado definitivos y la clase de las puertas.
4. **Medidas reales en obra** con tu proveedor antes de fabricar carpintería y hierro.
5. Revisar con el técnico las vistas a menos de 2 m de los vecinos (art. 582 del Código Civil) y las medianeras.

## Lo que haré cuando elijas modelo
Modelo 3D v9 con el modelo elegido y los muebles reales, 6–8 renders (cocina, suite con asiento de lectura, vestidor, salón, patio sur, exterior), planos DXF, tablas de proveedores y este PDF actualizados.
