wspoolcover/toldos/cortijo/docs/00_resumen.md

# Resumen del proyecto

## Qué es
Vivienda unifamiliar de dos plantas en San Roque (Albox, Almería), polígono 33, parcela 198. La casa existente tiene muros de 55 cm (tapial con base de piedra); se amplía con un salón nuevo de piedra marés al norte, con una terraza encima. Todo es **preliminar**: necesita un técnico para sismo, geotecnia, estado de los muros, armado, uniones y resistencia al fuego. Las medidas son las del croquis a mano del propietario (la casa se ha agrandado), no las del proyecto original.

## Orientación
- **Norte** (abajo en los planos): acceso por el camino con la acequia, con una entrada de unos 7 m y puerta corredera, y la acometida de agua. Aquí están el salón y la entrada.
- **Sur** (arriba en los planos): fachada ancha de 9,55 m con la caja general de protección (acometida trifásica), hacia la rambla de Albox. Tiene terreno propio.
- **Este y oeste**: casas vecinas pegadas a la nuestra, sin ventanas en esas paredes.

## Datos del diseño actual (v8)
- Fachada ancha 9,55 m, fondo 16,30 m. Planta baja 109 m² útiles, planta alta 63 m², terraza sobre el salón 43 m².
- **Planta baja**: salón con comedor y chimenea (34,2 m²), pasillo de entrada con murete, entrada, escalera, sala de estar, despacho íntimo (3,8 m²) junto al vestidor, suite (dormitorio, vestidor y baño), baño grande, cocina y dormitorio 2 (en revisión: ver las propuestas A, B y C).
- **Planta alta**: tres dormitorios con armarios empotrados, sala familiar con salida a la terraza (corredera de 1,42 m) y un baño.
- **Escalera** en U de 17 peldaños (19,2 × 22 cm) con el pie junto a la entrada. Deja libres la cocina y el baño grande.
- **Estructura** (predimensionado): acero S275JR de unos 3,6 t (seis pilares HEB 120, vigas HEB 120/140/160), forjados de vigueta y bovedilla, zunchos y riostras; zapatas de 1,6 m (terreno de 130 kPa del proyecto original).
- **Instalaciones**: aerotermia de 8 kW con suelo radiante en la planta baja y splits en la alta; 16 paneles solares (7,2 kWp); acometida eléctrica trifásica; saneamiento a la fosa séptica del norte.
- **Envolvente**: carpintería de PVC acabado madera con contraventanas; paredes de tapial con cal transpirable y aislamiento mineral (sin poliestireno).

## Decisiones ya tomadas
Carpintería de PVC (no aluminio, salvo la salida de la cocina, por estudiar); aerotermia más suelo radiante solo abajo; tres dormitorios arriba; piedra marés en el salón; terraza sobre el salón con acceso desde la sala familiar; el propietario trabaja con Saxun (puertas, ventanas y hierro) y se encarga de la estructura y los precios.

## Dónde está cada cosa
Modelo 3D (`casa_v8.step` y `.glb`), planos DXF (`*_v8.dxf`), planos y renders (PNG), tablas para proveedores (`pedido_proveedores.xlsx`), visor web (artefacto «Cortijo Albox») y los documentos de `docs/`. Este PDF reúne todo; los planos DXF están también en PDF vectorial en `pdf/planos/`.
