wspoolcover/toldos/cortijo/docs/13_finca_y_ubicacion.md

# La finca: ubicación y datos (de tus documentos de Drive y del arquitecto)

Solo uso los datos de la propiedad. No copio nombres, DNI ni teléfonos de los documentos.

## Datos de registro (del contrato de compraventa de abril de 2025)
- **Dónde está**: Pago de San Roque, Diputación de Locaiba, término de **Albox (Almería)**. Casa cortijo número 89 del Diseminado de Locaiba.
- **Superficie de la finca**: **13 áreas 17 centiáreas ≈ 1.317 m²**. Es «trozo de tierra de riego y un ensanche plantado de palas chumbas», con la casa dentro.
- **La casa**: dos plantas, 113 m² construidos abajo y 82 m² arriba.
- **Referencia catastral**: 000508900WG74A0001DG (forma parte también de la 04006A033001170000OU y de la parcela 90010). El arquitecto usa la 04006A033001980001PG para la vivienda (polígono 33, parcela 198).
- **Finca registral** 17520.
- **Riego**: la finca tiene derecho a **nueve horas de agua de la fuente del Pleito** en sus tandas de costumbre. Es el agua de la acequia que va por el norte; sirve para el huerto y los árboles.
- Los linderos del registro dan los nombres de los colindantes por los cuatro lados y un camino; la descripción es antigua y no me sirve para orientar los planos.

## Coordenadas (de los 14 puntos UTM del plano PL-03 del arquitecto)
- Centro de la vivienda: UTM 30 ETRS89 X = 574.709, Y = 4.139.801 → **latitud 37,4020 N, longitud 2,1559 O**. Está a poco más de 1 km al noroeste del casco de Albox.
- El contorno de la casa existente mide **118 m²** (frente a los 115 m² construidos que da el arquitecto).
- **El eje largo de la casa va de NNO a SSE**, con un azimut de **339° / 159°**. Los lados largos de 9,5 m van a 69° (ENE) y a 249° (OSO).

## Lo que no puedo saber sin un croquis
- **Qué extremo del eje largo es el del salón (tu «norte»)**: si es el que mira a 339° (NNO) o a 159° (SSE). De eso depende hacia dónde miran de verdad los paneles solares, el sol que recibe la terraza y la cristalera del salón.
- **La forma y las dimensiones de la finca** (1.317 m²), y dónde se sitúa la casa dentro.
- **Dónde están la fosa séptica y el poste de luz**, y por qué lado entra el camino.

## Qué necesito de ti (con una foto de un croquis a mano basta)
1. El contorno aproximado de la finca, con la casa dentro.
2. El camino con la acequia, la entrada de 7 m con la puerta corredera, el contador de agua, el poste de luz, la fosa y la CGP.
3. Los vecinos de este y oeste, y la rambla de Albox.
4. **Una flecha de norte real**: con la brújula del móvil, de pie delante de la fachada ancha, dime hacia dónde mira (por ejemplo, «sur-sureste»).
