wspoolcover/toldos/cortijo/docs/09_aprovechar_proveedores.md

# Aprovechar tus proveedores (Saxun, hierro, PVC)

Tienes acceso a precio de coste en puertas, ventanas y hierro. No he abierto las carpetas de clientes ni los presupuestos de tu Drive; por eso **no sé tus precios**. Lo que he hecho es sacar del modelo v7 las **mediciones exactas** para que pidas oferta, y dejar el Excel `pedido_proveedores.xlsx` con una columna amarilla para tus precios y una hoja de ahorro frente al mercado.

## Qué conviene comprar por tu canal (de mayor a menor ahorro posible)
1. **Hierro (≈ 4,5 t con escalera, barandillas y soportes solares):** es la partida más pesada. Pide a tu proveedor los perfiles en bruto, ya cortados a la lista de la hoja «Hierro». Referencia de mercado: perfil en bruto ≈ 1,0–1,6 €/kg frente a 2,4–5,5 €/kg ya montado.
2. **Ventanas y cristaleras de PVC (≈ 37 m²):** 8 ventanas, la cristalera del salón de 4,00 × 2,55 m, el cierre fijo de la planta alta y el fijo del despacho. Con contraventanas y mosquiteras.
3. **Puertas (13):** entrada de 1,40 m, puerta de la cocina al patio, corredera a la terraza y 10 interiores. Si tu canal tiene puerta de hierro con vidrio para la entrada, encaja con el estilo cortijo.
4. **Escalera de acero, barandillas y soportes de los paneles solares:** el taller puede fabricarlas y galvanizarlas junto con la estructura.
5. **Opcionales de hierro:** pérgola de la terraza, rejas de las ventanas bajas del sur, cancela del patio sur y raíl y hoja de la puerta corredera de 7 m del acceso.

## Cómo usar el Excel
- **Ventanas / Puertas / Hierro:** rellena la columna amarilla con tu precio de coste (unidad o €/kg); los totales salen solos.
- **Resumen y ahorro:** rellena la columna «Referencia mercado» con lo que cobraría un tercero (o el PVP de tu tarifa) y verás el ahorro en € y en %.
- Las medidas son huecos de obra del modelo; el taller debe tomar medidas reales en obra antes de fabricar.

## Cosas que no debes olvidar
- Las secciones de acero son una propuesta mía y las debe calcular un ingeniero antes de pedir material.
- Piezas estimadas (escalera, barandillas, soportes solares, placas base, tornillería): confirmar con el taller.
- Si compras a coste a tu empresa para tu propia casa, mantén la factura y la contabilidad en regla (consúltalo con tu asesoría).
