wspoolcover/toldos/cortijo/docs/11_estado_real_fotos.md

# Estado real de la casa (fotos del 12-10-2026)

Resumen de lo que enseñan las 11 fotos y qué cambia en el diseño. Lo marcado «a confirmar» lo debes verificar tú.

## Qué se ve
1. **Fachada con puerta de doble hoja de madera, dos ventanas con rejas de hierro y un balcón enrejado.** Es la fachada ancha de 9,55 m; se ve el pavimento de la acera delante.
2. **CGP ya colocada en esa fachada**, con tubo rojo corrugado subiendo al tendido aéreo. Es **trifásica** (tres fases y neutro), etiqueta de 63 A.
3. **Cubierta y forjado superior demolidos en parte**; muros de **tapial** (tierra y cal con cantos) con restos de armadura vertical en espera en la coronación.
4. **Apeos metálicos** (puntales verdes) bajo el forjado de viguetas de madera y en el hueco del muro central.
5. **Zanjas abiertas por dentro junto a los muros** y humedad y sales en la base.
6. **Planchas de EPS** de una tienda de Alcaudete (Jaén) apiladas en una esquina.
7. **Arco y escalera antigua de piedra** junto a la entrada.

## Qué cambia en el diseño
- **Muros de tapial**: no se aíslan con EPS pegado; revoco de cal y aislante transpirable (`docs/03_envolvente.md`).
- **Electricidad trifásica**: la acometida trifásica ya existe; se ajusta el esquema (`docs/02_instalaciones.md`).
- **Recalce por bataches** y zunchos arriba (`docs/04_cimentacion_inicio.md`, plano de cimentación).
- **Rejas de hierro** en las ventanas del sur: encajan con tu canal de hierro y con el estilo cortijo.

## Orientación (confirmada por el propietario el 13-10-2026)
- **Norte (extremo del salón)**: el **acceso por el camino**. Hay una entrada de unos **7 m** con raíl de hormigón para una **puerta corredera**, y ahí está la **acometida de agua**. La entrada de la casa y el aparcamiento son por este lado.
- **Sur (fachada ancha de 9,55 m)**: tiene la **CGP trifásica**, la puerta antigua y las rejas. Es terreno propio y da hacia la **rambla de Albox**, no a una calle.
- **Este y oeste**: casas vecinas pegadas.
- **Corrección mía**: una versión anterior de los planos ponía «calle» en el sur por una foto de la fachada con acera. Ya está revertido: el sur es el patio propio hacia la rambla.
- La unidad de aerotermia queda **en la cubierta**: más segura y fuera de la zona de la rambla, que puede llevar agua en las avenidas. La puerta de la cocina al sur es una salida al patio.
- Comprobar con el arquitecto la **distancia a la rambla** (dominio público hidráulico) y si la zona es inundable; el proyecto legalizado ya debería contemplarlo.

## A confirmar
- **Posición exacta de la CGP** en la fachada (en mi esquema está entre dos ventanas del dormitorio 2 y la cocina).
- **Estado de la cimentación de piedra** en las zanjas abiertas (profundidad y ancho).
