wspoolcover/toldos/cortijo/docs/12_terreno_fotos.md

# El terreno según las fotos (13-10-2026) y el catastro

## Qué se ve en las 7 fotos del terreno
- **Entrada desde el camino**: un camino asfaltado con **acequia de hormigón** al lado, una **losa de hormigón grande** (casi una rampa) y **muros de hormigón con armaduras en espera** a ambos lados. Detrás, un **patio de grava** donde aparcan los coches.
- **Entorno**: olivos y campos abiertos, un **poste de luz con línea aérea** cruzando la finca, el pueblo y las sierras al fondo. No hay edificios cerca por el lado del camino.
- **La casa vista desde el terreno**: muros de **tapial** con la cubierta ya demolida, **casas vecinas encaladas pegadas a los lados**, una de ellas con tejado de teja y **placas solares**, y a la derecha una nave con **tejado de chapa**. Hay escombros y cañizo apilados delante.
- **Tubo rojo corrugado** tendido por el suelo: es la canalización que viene de la CGP.

## Qué dice el catastro (PL-02)
- La parcela de la vivienda (04006A033001980001PG) es **pequeña y alargada**, dentro de una **fila de parcelas estrechas** (las casas vecinas) y rodeada por la **finca grande de olivos** en el lado del camino.
- Es decir: las casas vecinas están **a los lados de la hilera**, y el terreno propio se abre por el extremo del salón hacia la finca. Coincide con lo que me dijiste.

## Qué cambia en el diseño
- **El salón y la entrada** están en la parte que da a la finca y al camino: tiene sentido que el acceso de coche sea por ahí (la losa y el patio de grava).
- **Placas solares del vecino**: su tejado puede dar sombra o recibirla. Antes de fijar la posición de nuestros paneles conviene comprobar el sol con una simulación de sombras.
- **Altura**: nuestras fachadas laterales de planta alta quedan más altas que las casas vecinas. El arquitecto ya legalizó dos plantas; confirmar que la altura de la cubierta plana con parapeto (≈ 6,5 m) respeta el planeamiento.
- **Poste y línea aérea**: queda cerca de la zona del salón. Respetar la distancia de seguridad a los cables al construir y al montar andamios.

## Pendiente de confirmar contigo
1. ¿La **losa y los muros de hormigón** de las fotos son la cimentación del salón que ya hiciste (60 cm)? Se ven muros de unos 1,0–1,2 m con armadura en espera, más altos que una zapata.
2. ¿**Por qué lado discurre el camino** (este u oeste del salón)? Dibujo la entrada y la acometida según eso.
3. ¿Dónde está la **fosa séptica**? No se ve en las fotos.
4. Una **medida con cinta** de lo ancho que es el terreno propio en la zona del salón, para dibujarlo a escala.

## Segunda tanda de fotos (13-10-2026)
- **El suelo tiene aspecto de arcilla o limo**: se ve **agrietado por la sequía** (costra con grietas poligonales) en todo el terreno junto a los muros de hormigón. Esto pesa mucho en la cimentación: las arcillas se hinchan con la lluvia y se contraen con la sequía y mueven las zapatas poco profundas.
- **Muros de hormigón en L** junto a la losa, con un pasamuros circular (tubo) en uno de ellos, un pequeño pilar de hormigón al fondo y **dos rollos de tubo rojo corrugado** en el suelo. Hay montones de tierra excavada.
- **Montón de tocones de olivo** y el **poste de luz con la línea aérea** que cruza la finca, a unos pasos de los muros nuevos.
- **Vistas al valle**: el terreno parece estar en un escalón alto, con el pueblo más abajo. Puede haber desnivel hacia el borde.
- **Patio de grava** delante de la casa, con las casas vecinas encaladas pegadas a ella, y una **tapia ondulada** (de chapa o de fibrocemento) en el lindero de un lado. Si es fibrocemento, no se rompe ni se corta sin las precauciones propias del amianto.
- **Muro de hormigón bajo** pegado a la fachada norte de la casa vieja (junto a la pila de cañizo): parece el arranque de uno de los muros del salón.

## Qué cambia en la cimentación
- **Estudio geotécnico: prioritario.** Con arcilla agrietada, los 130 kPa del proyecto son un dato que hay que comprobar sí o sí.
- **Cota de apoyo más profunda** (la capa que se mueve con el clima suele llegar a 1,0–1,5 m): no apoyar zapatas en la capa superficial.
- **Evitar que el agua llegue al pie de los muros**: drenaje perimetral, acera de hormigón alrededor de la casa y no plantar árboles grandes a menos de 4–5 m.
- **Las zapatas y riostras propuestas** (1,60 m, riostras de 40×50) siguen siendo razonables, pero la profundidad y el tipo (zapatas o losa) los decide el estudio.

## Aclaraciones del propietario (13-10-2026)
- **Acometida de agua**: en el norte, justo en el camino, junto a la entrada de **7 m con puerta corredera** (hay raíl de hormigón en el suelo).
- **Acometida de luz**: en la fachada sur de la vivienda (la ancha), hacia la **rambla de Albox**.
- Por tanto el agua llega por el norte y la luz por el sur. Esquema de instalaciones corregido en consecuencia.
