wspoolcover/toldos/cortijo/docs/05_ahorro.md

# Dónde ahorrar (primera lista, para empezar a decidir)

Del orden de mayor a menor ahorro posible. Todo con rangos orientativos que hay que contrastar con presupuestos.

| Idea | Ahorro estimado | Riesgo / nota |
|---|---|---|
| Ventanas de tu empresa a precio de coste | Varios miles de € (≥ 50 % de la carpintería) | Ninguno; mejora el aislamiento |
| Estructura de vigueta y bovedilla con HEB (ya hecho) | 6.000–16.000 € respecto al primer diseño | Confirmar luz del salón con el fabricante |
| Cocina de módulos estándar | 3.000–8.000 € | Elegir buen herraje |
| SATE solo en fachadas sin vecino | 2.000–5.000 € | Los puentes térmicos de la medianera quedan |
| Splits en planta alta en vez de suelo radiante en toda la casa | 4.000–6.000 € | Menos confort arriba |
| Sedum en vez de césped natural | 3.000–8.000 € | Menos «césped» |
| Mantener el recrecido de muros de PL-05 sin demoler lo que esté bien | Variable | Depende de las catas |
| Mano de obra: tú ejecutas el salón y albañiles el resto | Variable | Necesitas dirección técnica y seguro |

**Lo que no se toca**: zunchos, riostras, refuerzos sísmicos, pilares, zapatas, dinteles, impermeabilización e instalación eléctrica y de agua.

Los números de partida del modelo (estructura, sismo) están en `../abaratar.md`.
