wspoolcover/toldos/cortijo/pdf/Opcion_C_cocina_central.pdf

# Opción C · cocina central

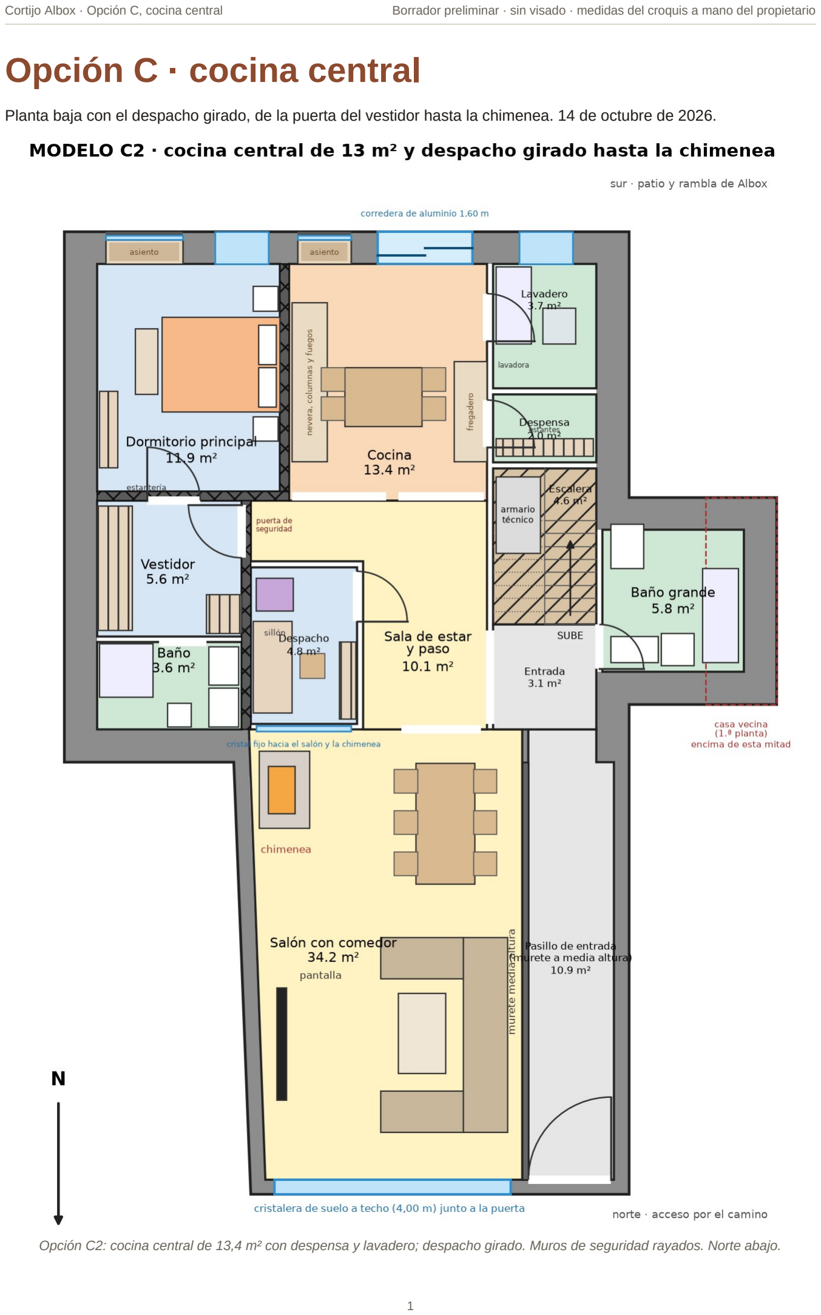
[picture p39: page 1]

Cortijo Albox · Opción C, cocina central | Borrador preliminar · sin visado · medidas del croquis a mano del propietario

1

Planta baja con el despacho girado, de la puerta del vestidor hasta la chimenea. 14 de octubre de 2026.

Opción C2: cocina central de 13,4 m² con despensa y lavadero; despacho girado. Muros de seguridad rayados. Norte abajo.

Cortijo Albox · Opción C, cocina central | Borrador preliminar · sin visado · medidas del croquis a mano del propietario

2

## Qué incluye

- Cocina central de 13,4 m², abierta a la sala de estar por dos pasos libres (1,60 y 1,45 m), con mesa de comedor, salida acristalada de aluminio de 1,60 m al patio sur y asiento de lectura en la ventana (banco de obra de 45 cm de altura).
- Despensa de 2,0 m² y lavadero de 3,7 m² al este, con puerta desde la cocina. El lavadero puede ser más adelante una habitación pequeña.
- Despacho girado, a lo largo de la pared del vestidor: mesa larga contra la pared, estantería y sillón de lectura junto a la puerta, y cristal fijo en el extremo norte hacia el salón y la chimenea.
- Suite: puerta de seguridad del vestidor pegada al dormitorio (bisagra a la derecha al entrar, abre hacia el vestidor), puerta de seguridad al dormitorio, muros de seguridad de 15 cm (hormigón armado o bloque de hormigón relleno y armado) y asiento de lectura en la ventana de 1,30 m.
- No hay dormitorio 2 abajo: la casa queda con cuatro dormitorios (suite y tres arriba). Escalera, entrada, baño grande y armario técnico como en la v8.

## Superficies

Estancia | m² | Estancia | m²
Salón con comedor | 34,2 | Despensa | 2,0
Pasillo de entrada | 10,9 | Lavadero | 3,7
Entrada | 3,1 | Dormitorio principal | 11,9
Escalera | 4,6 | Vestidor | 5,6
Sala de estar | 10,1 | Baño | 3,6
Despacho | 4,8 | Baño grande | 5,8
Cocina | 13,4

## El despacho, antes y ahora

| v8 | Opción C2
Forma | 2,40 × 1,58 m, horizontal, junto al salón | 1,80 × 2,65 m, vertical, a lo largo de la pared del vestidor
Superficie | 3,8 m² | 4,8 m²
Recorrido | Al norte de la sala de estar | De la puerta del vestidor a la chimenea
Puerta | Por el lado sur, desde la sala | Por el lado este, desde la sala, junto al extremo sur
Cristal fijo | 2,0 m hacia el salón | 1,60 m en el extremo norte, hacia el salón y la chimenea
Sala de estar | 11,1 m² | 10,1 m²

## A confirmar

- ¿He entendido bien el despacho? Girado 90°, pegado a la pared del vestidor, desde su puerta hasta la chimenea del salón.
- Si quieres ver el fuego desde el despacho, la chimenea se gira o se hace de dos caras con cristal. Ahora el cristal da al salón y a un lado de la chimenea.
- Si «luminio» era aluminio (así lo he puesto en la salida de la cocina) o una salida grande y luminosa; el diseño sirve para las dos.
- Si en la planta alta quieres también asientos en las ventanas y paredes de seguridad.

## Siguiente paso

Con tu OK hago el modelo 3D v9 con esta distribución y los muebles reales, 6 a 8 renders (cocina, suite con el asiento, vestidor, despacho con vista a la chimenea, salón, patio sur y exterior), los planos DXF y el dossier actualizados.

Borrador preliminar · sin visado · medidas del croquis a mano del propietario.
