wspoolcover/toldos/casa3d/distribucion.png

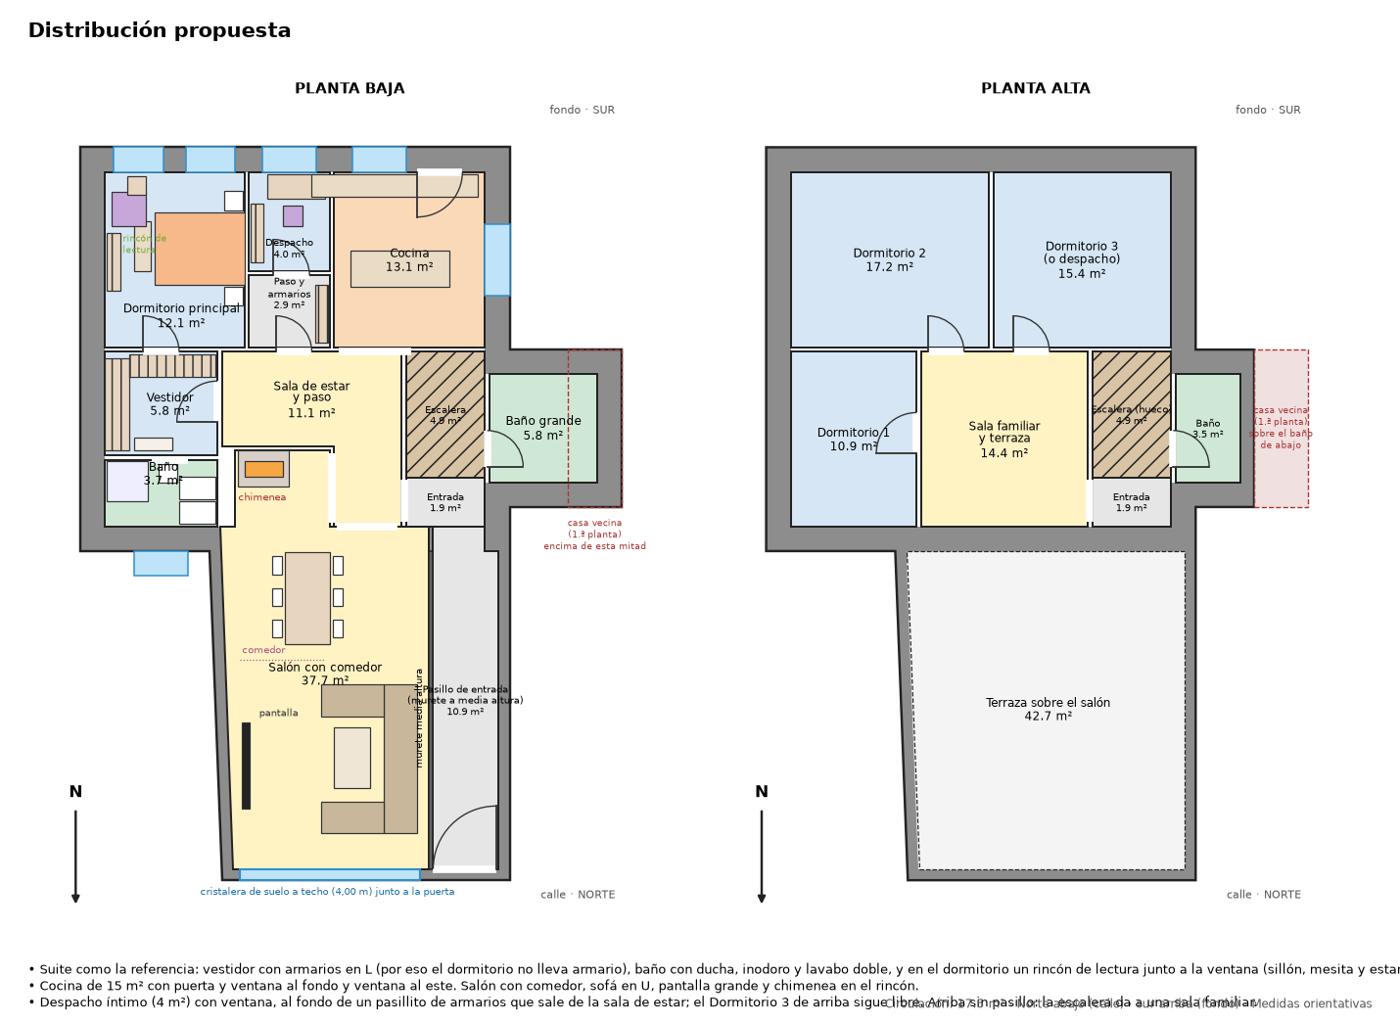
casa3d/distribucion.png
