wspoolcover/toldos/casa3d/suite.png

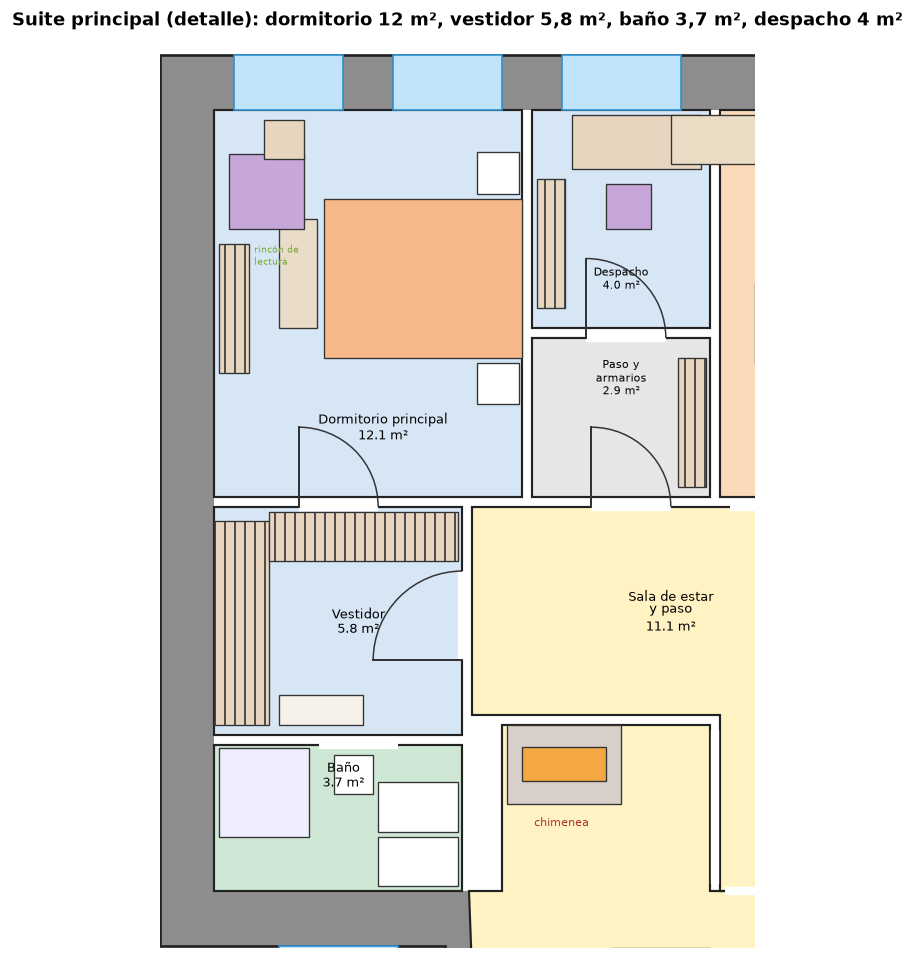
casa3d/suite.png
