wspoolcover/toldos/cortijo/cimentacion_bataches.png

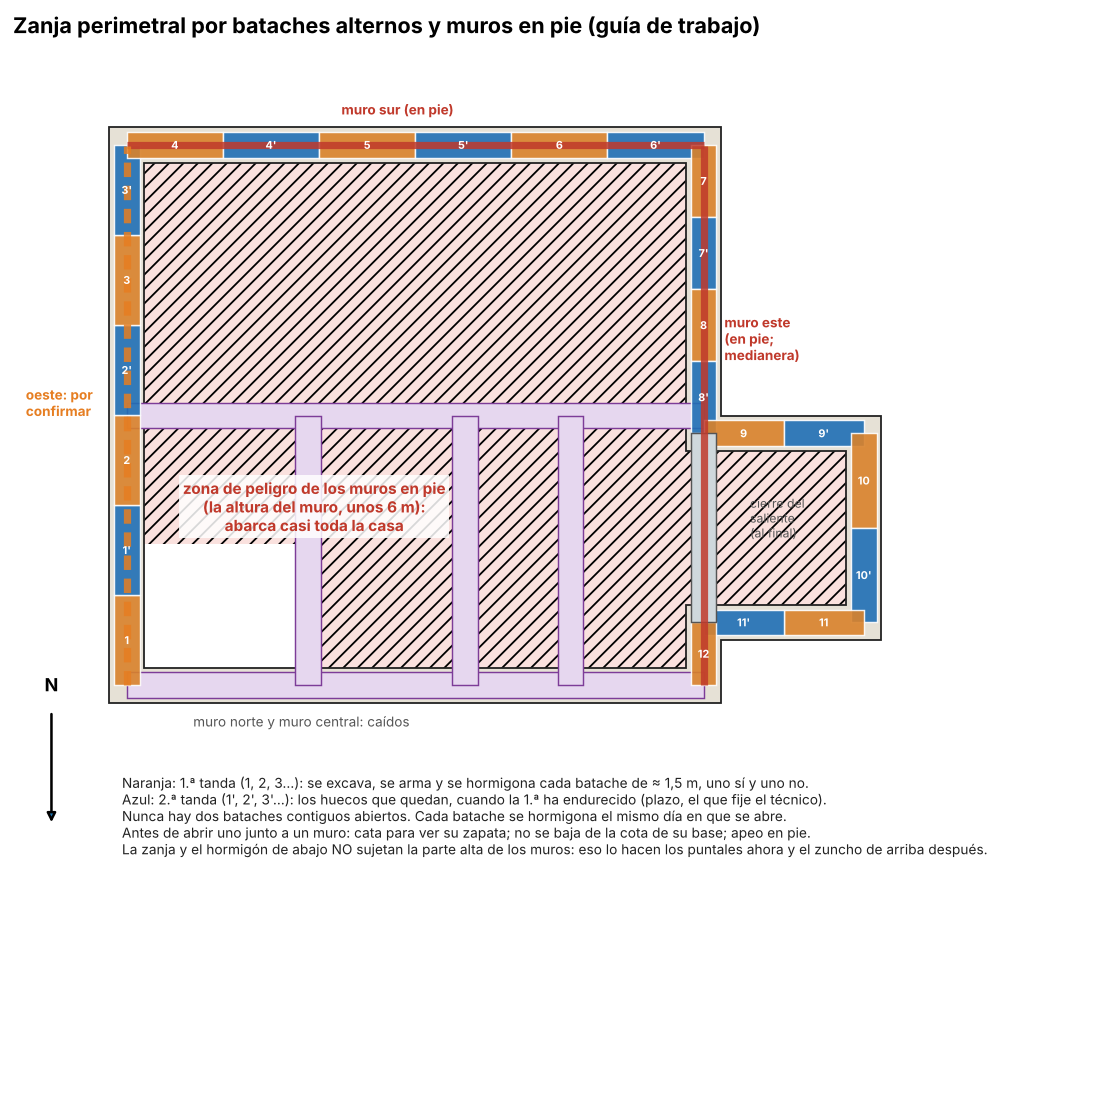
cortijo/cimentacion_bataches.png
