wspoolcover/toldos/cortijo/cimentacion_planos.png

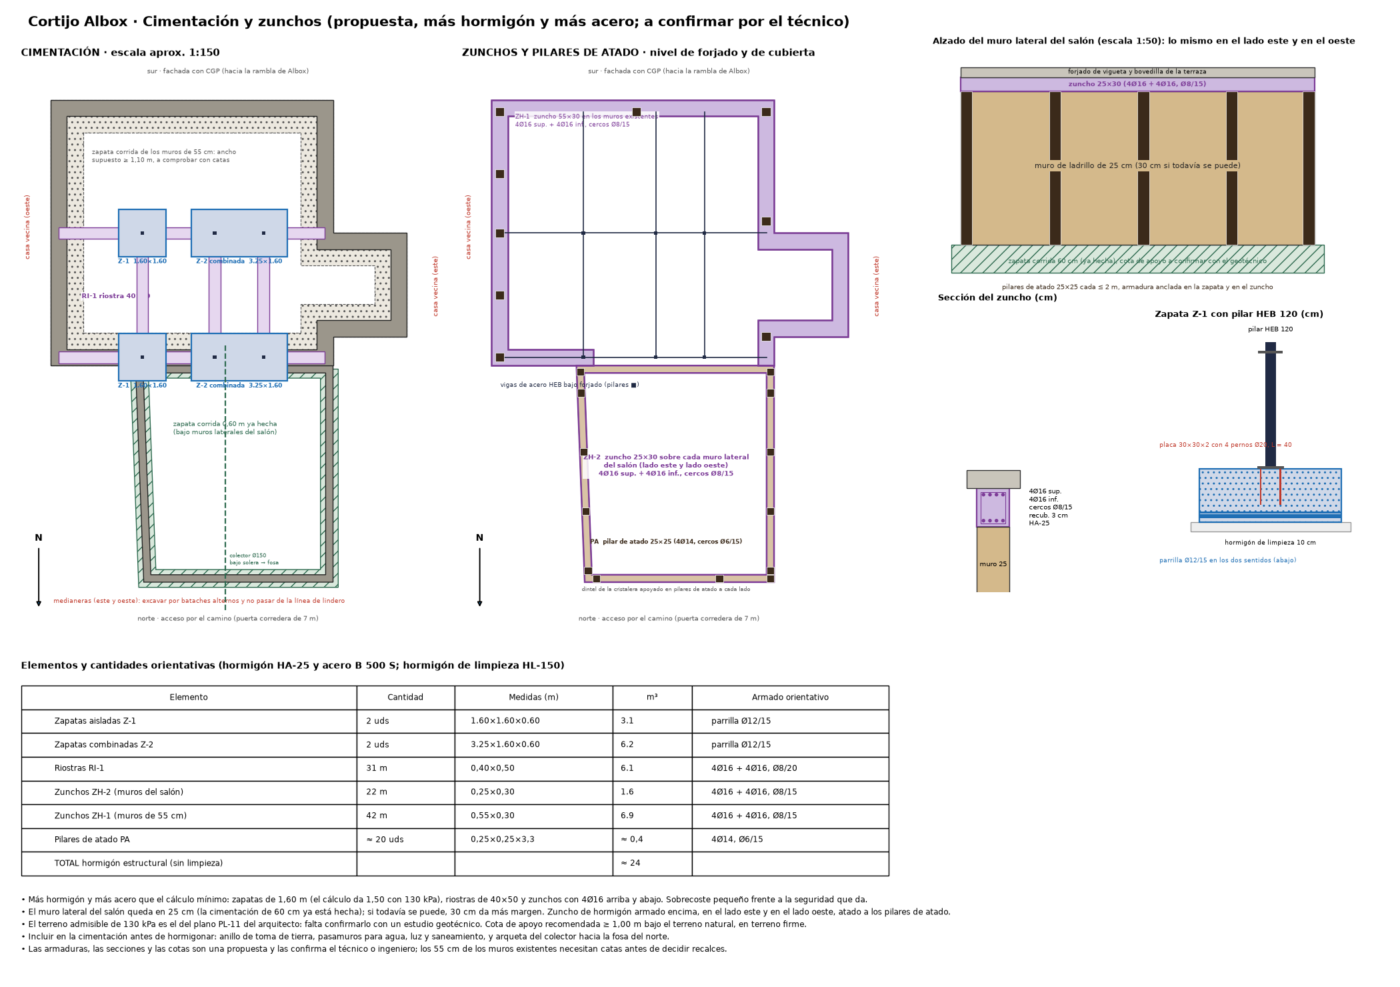
cortijo/cimentacion_planos.png
