wspoolcover/toldos/cortijo/cortijo_3d.png

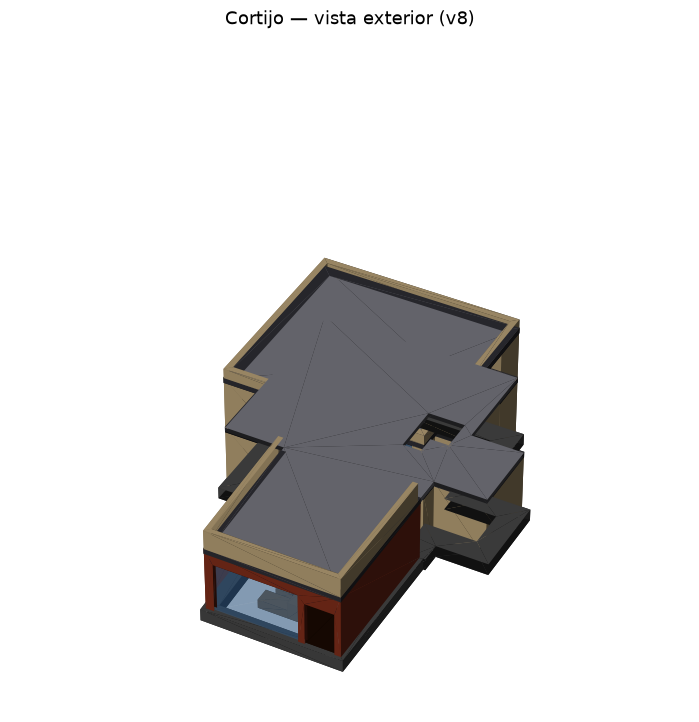
cortijo/cortijo_3d.png
