wspoolcover/toldos/cortijo/cortijo_3d_PB.png

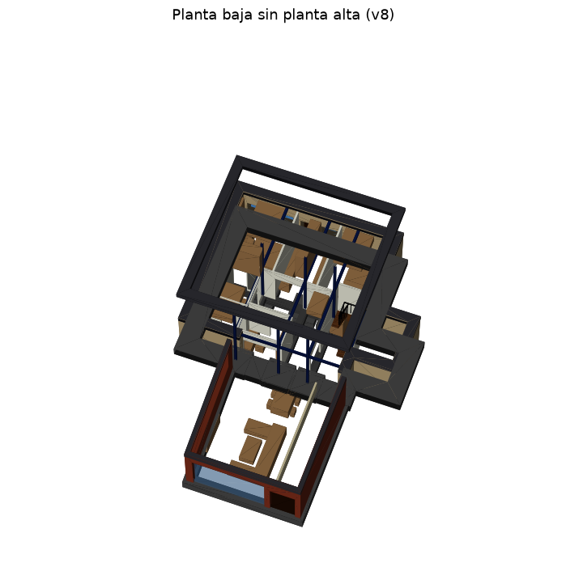
cortijo/cortijo_3d_PB.png
