wspoolcover/toldos/cortijo/cubierta_solar.png

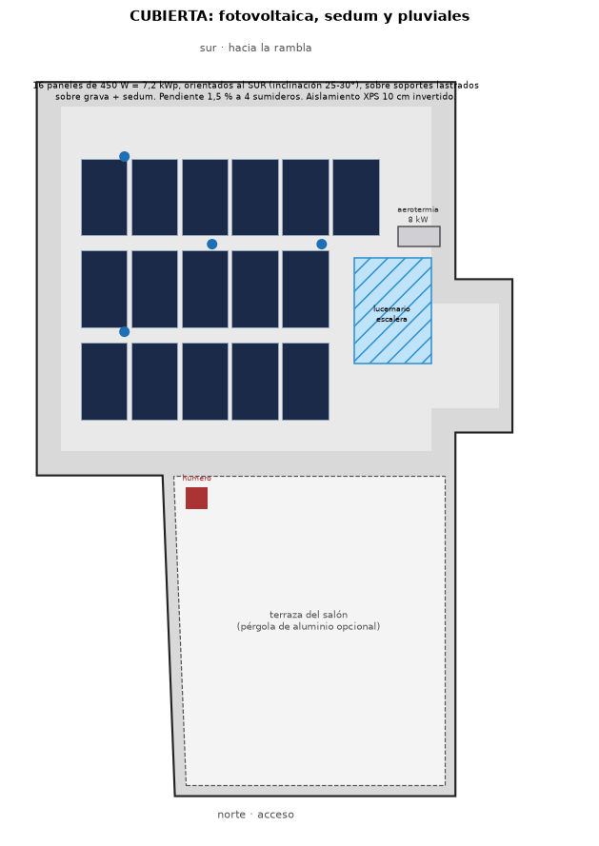
cortijo/cubierta_solar.png
