wspoolcover/toldos/cortijo/detalles_apoyo_placa.png

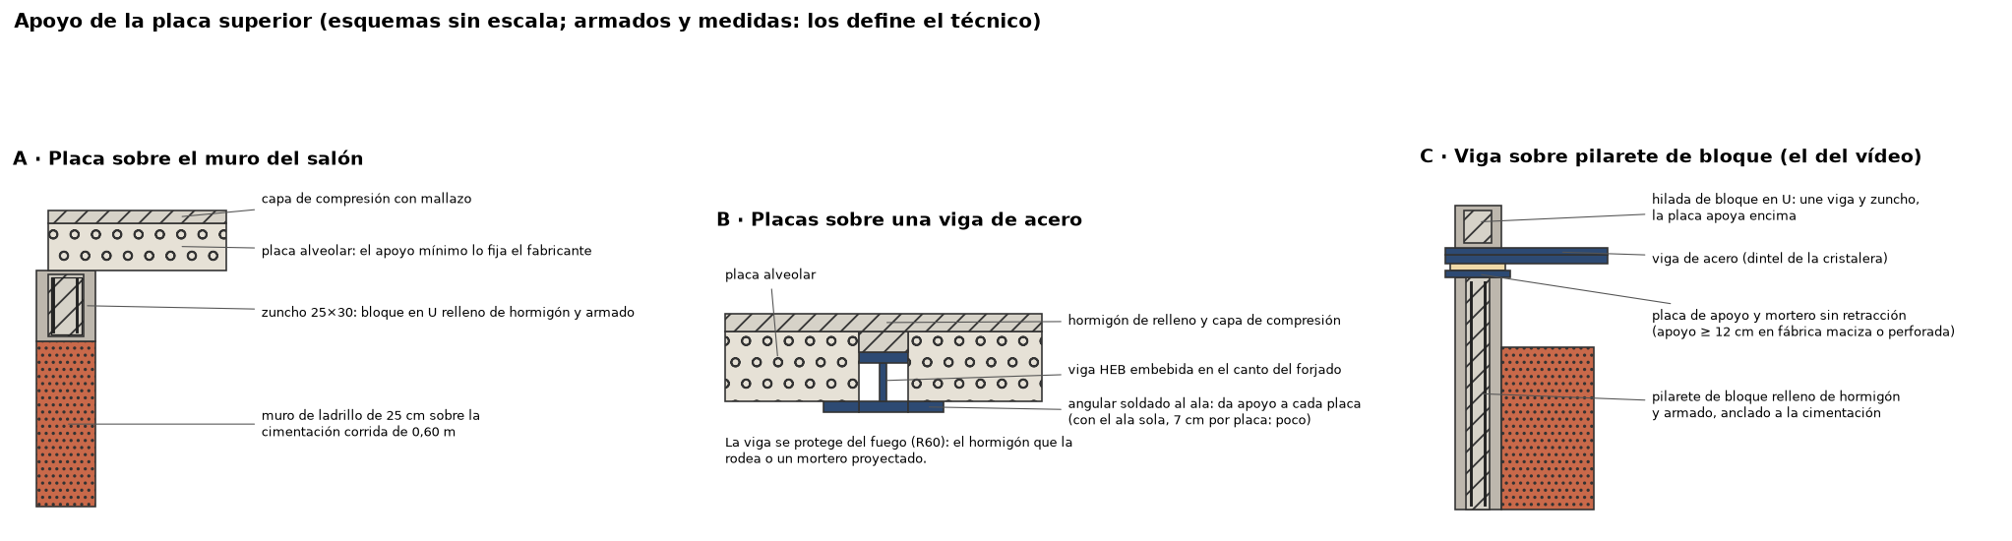
cortijo/detalles_apoyo_placa.png
