wspoolcover/toldos/cortijo/estructura_3d.png

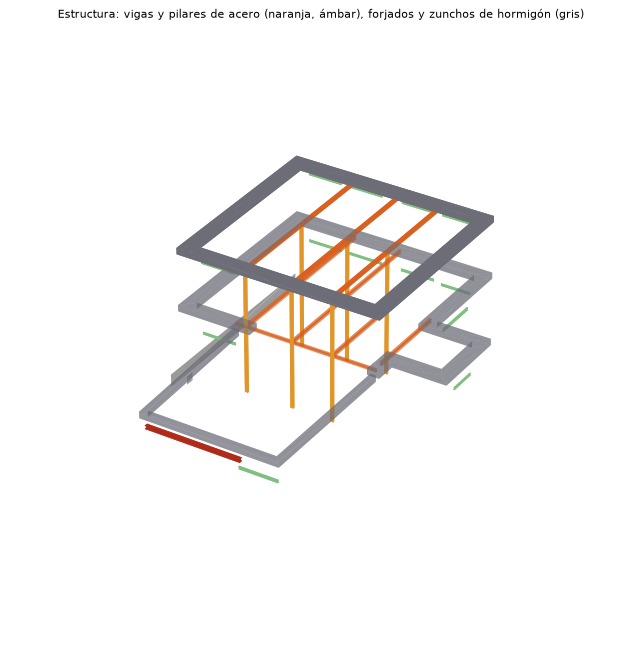
cortijo/estructura_3d.png
