wspoolcover/toldos/cortijo/fosa_septica_esquema.png

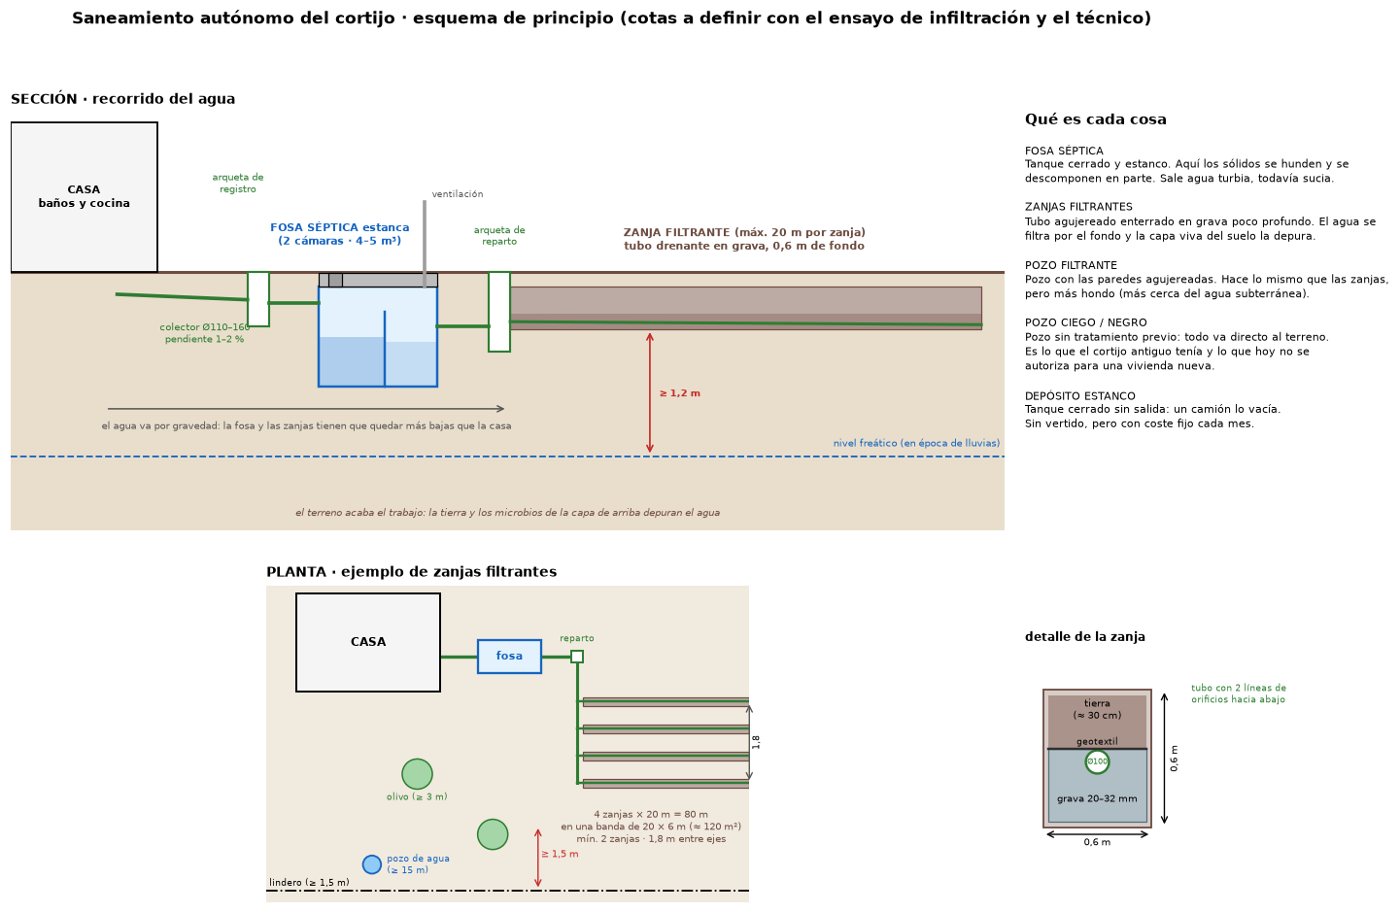
cortijo/fosa_septica_esquema.png
