wspoolcover/toldos/cortijo/instalaciones.png

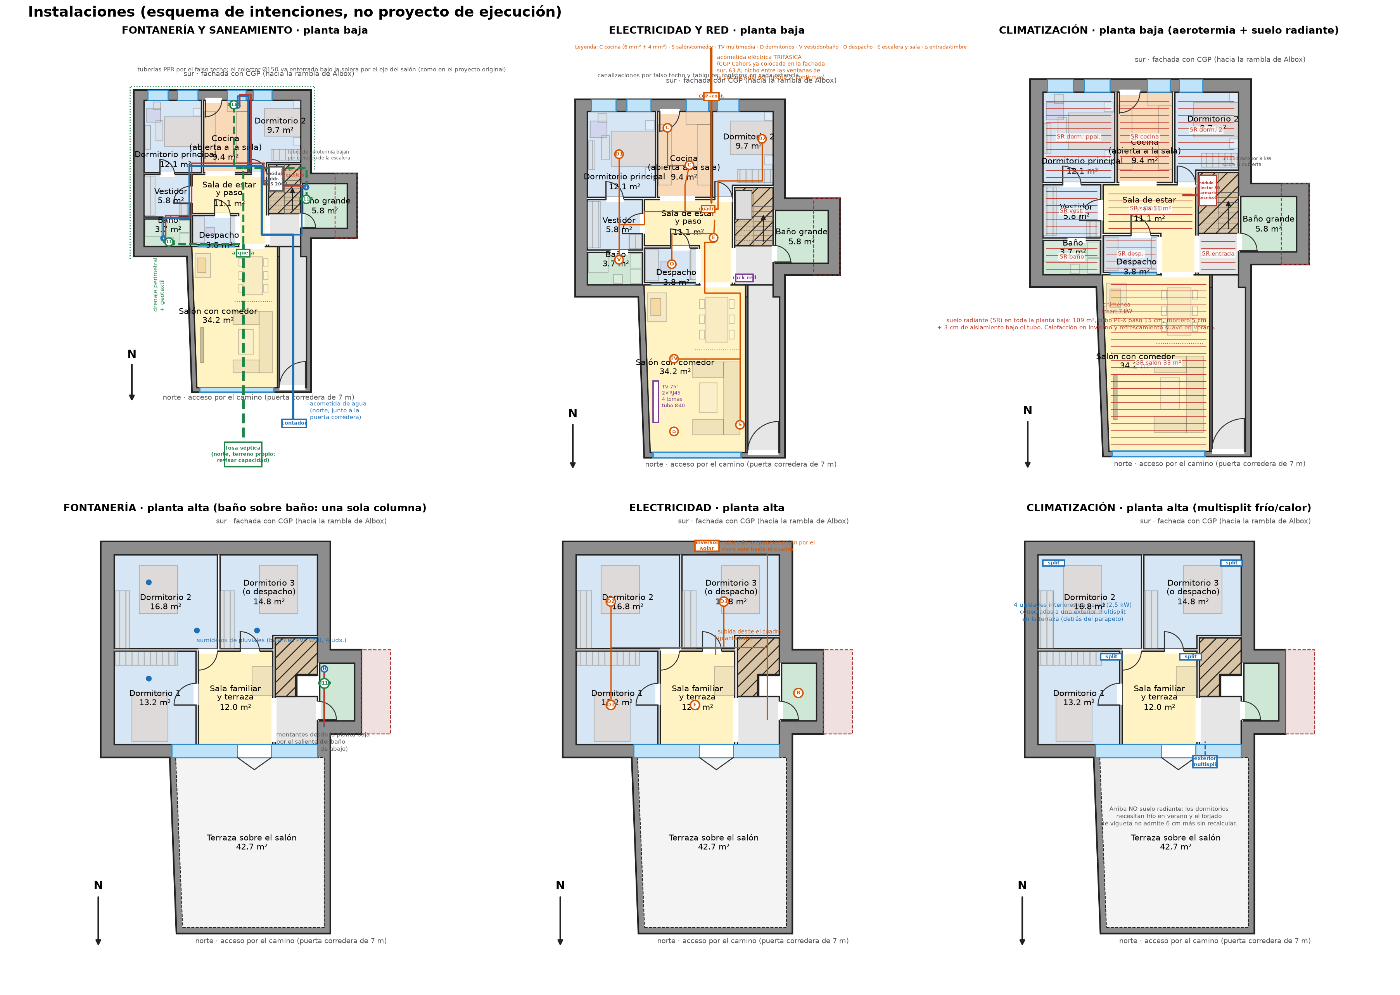
cortijo/instalaciones.png
