wspoolcover/toldos/cortijo/modelo_A_planta_baja.png

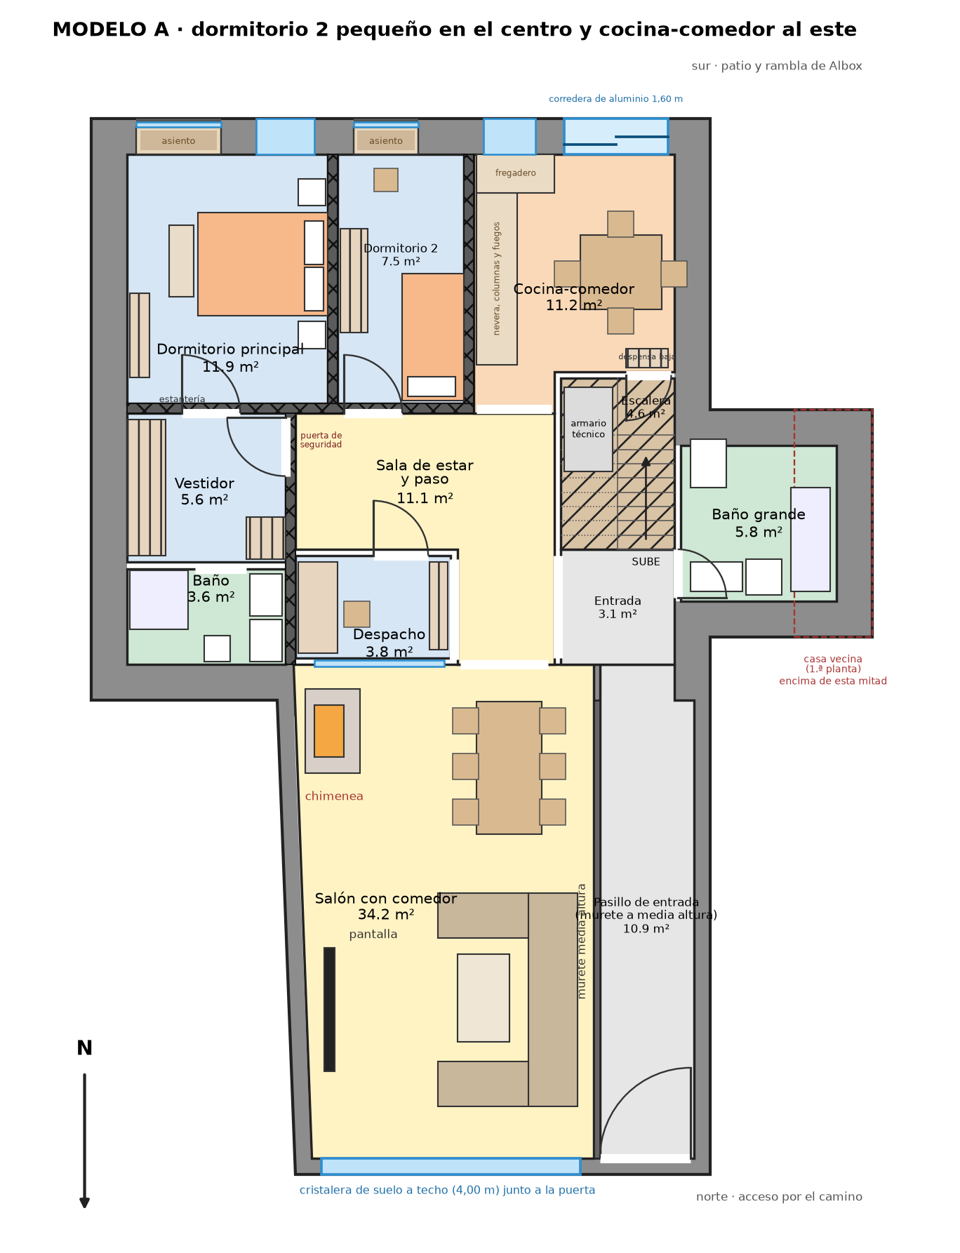
cortijo/modelo_A_planta_baja.png
