wspoolcover/toldos/cortijo/modelo_C2_planta_baja.png

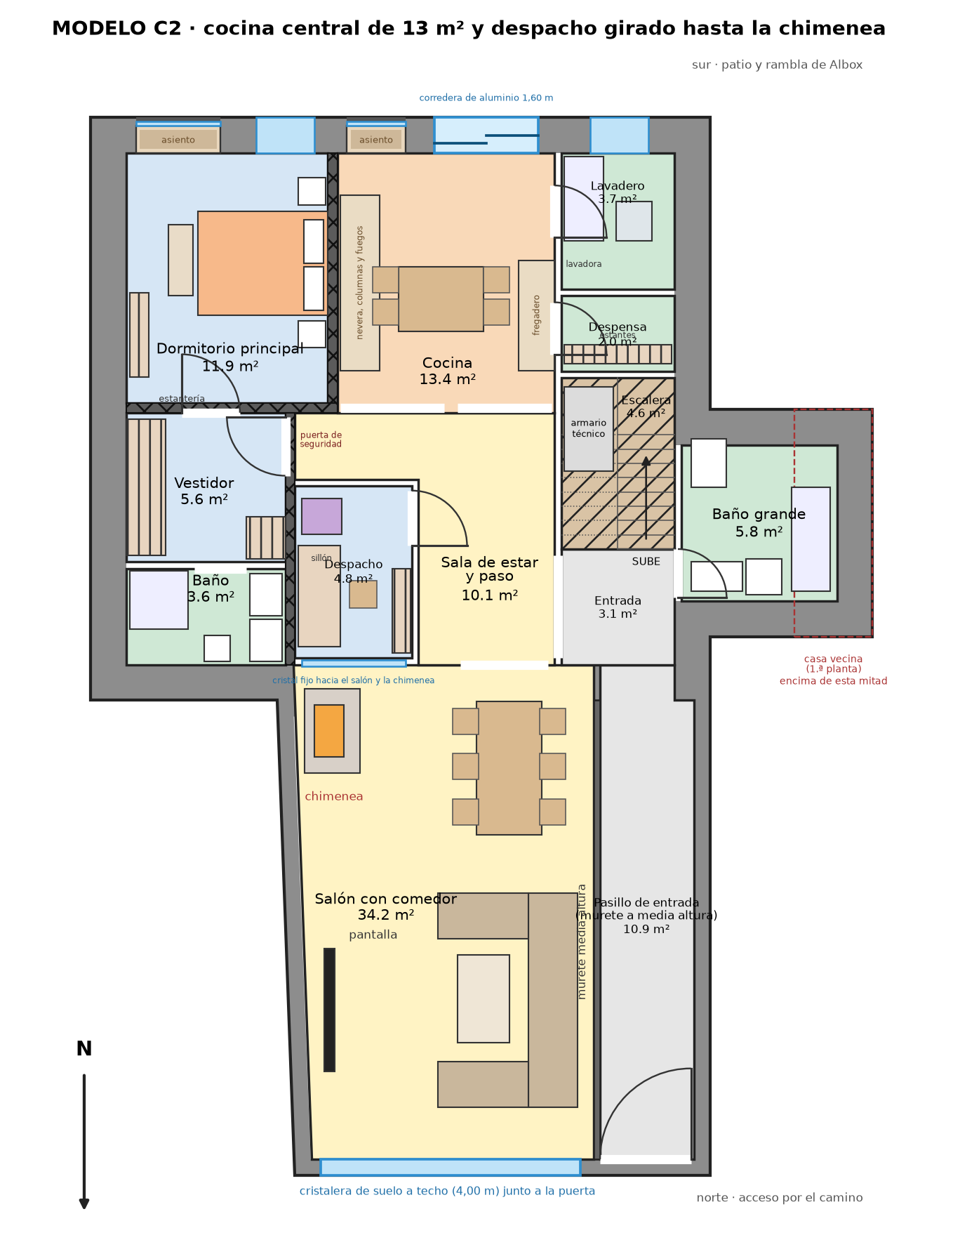
cortijo/modelo_C2_planta_baja.png
