wspoolcover/toldos/cortijo/modelo_D_planta_baja.png

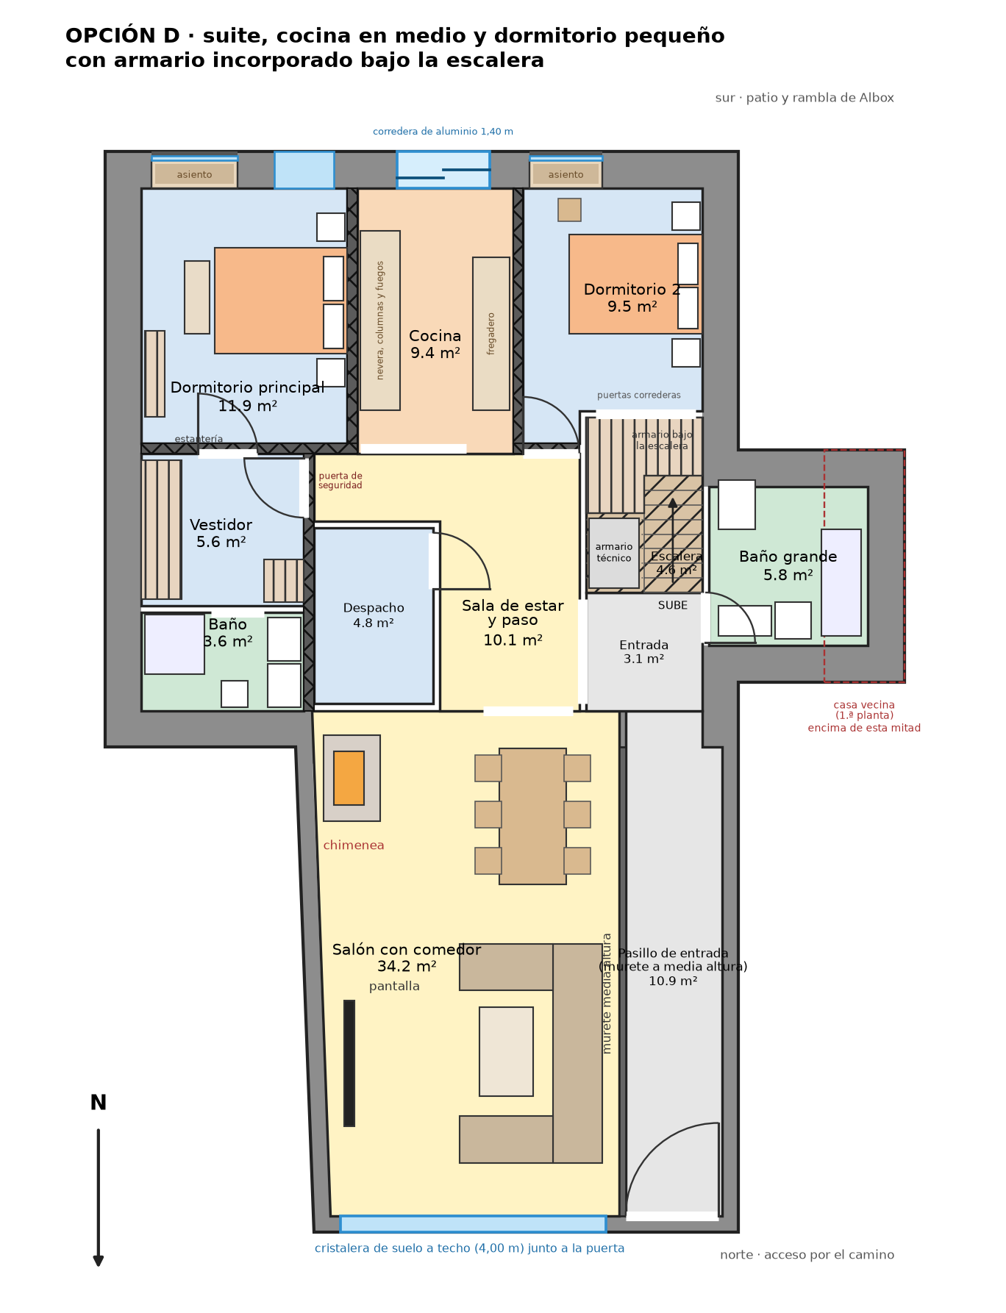
cortijo/modelo_D_planta_baja.png
