wspoolcover/toldos/cortijo/modelos_planta_baja.png

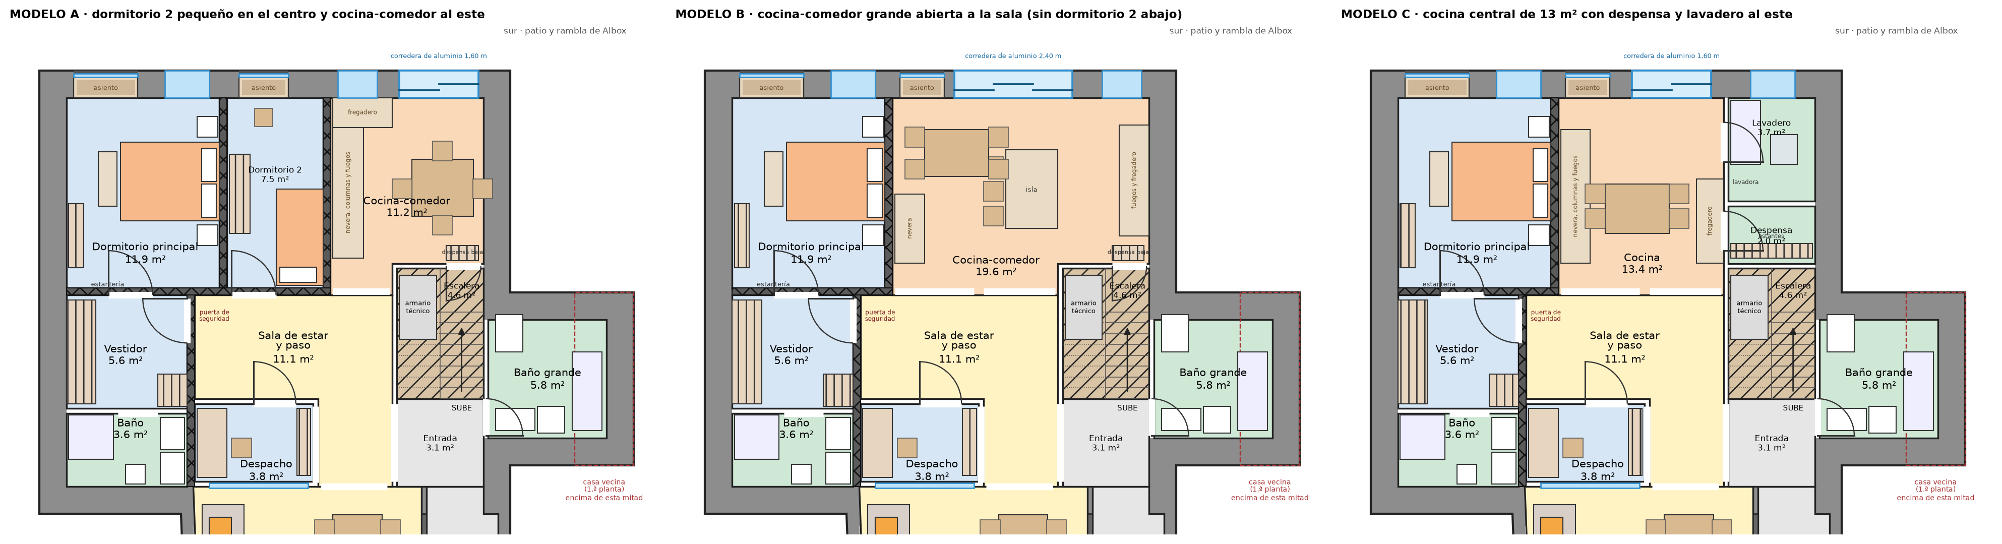
cortijo/modelos_planta_baja.png
