wspoolcover/toldos/cortijo/pozo_filtrante_5m.png

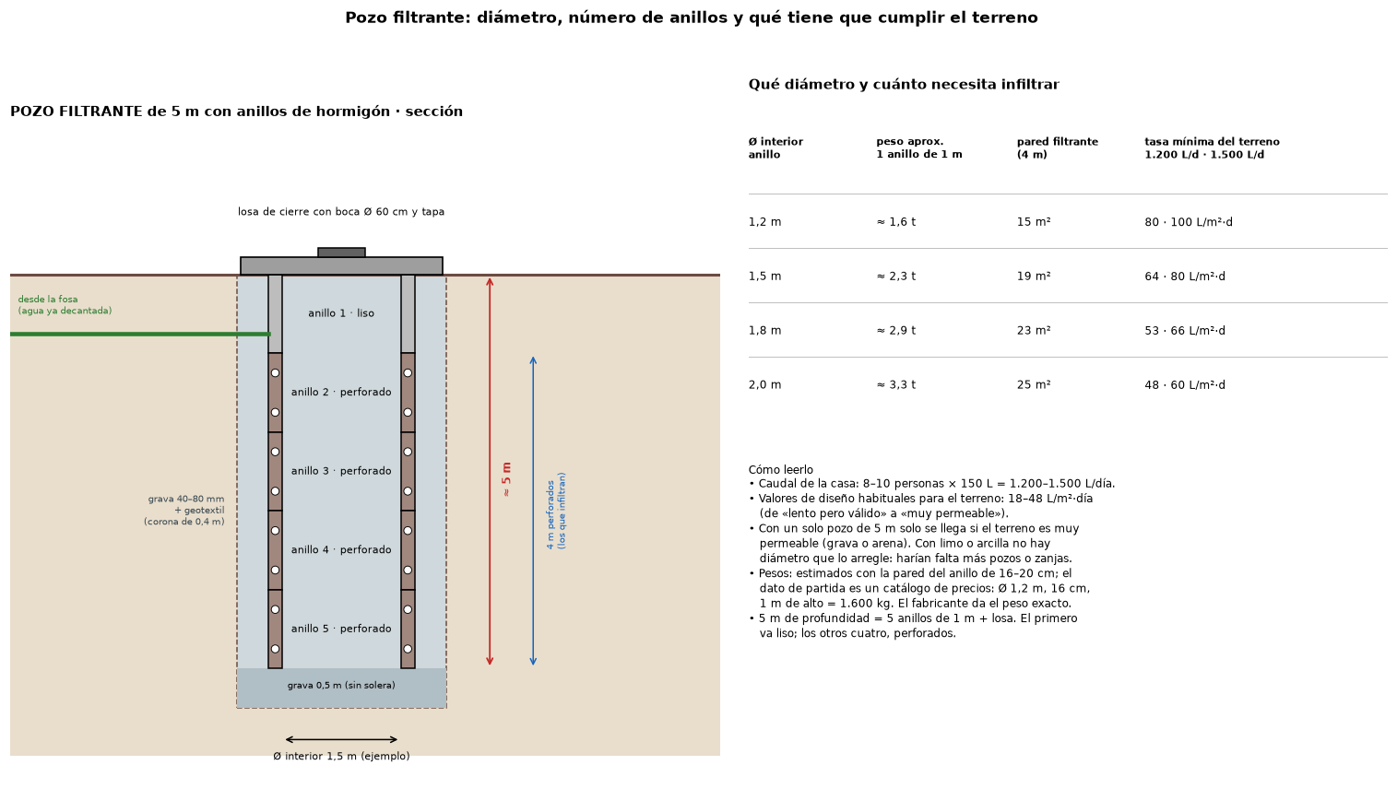
cortijo/pozo_filtrante_5m.png
