wspoolcover/toldos/cortijo/render_exterior_sur.png

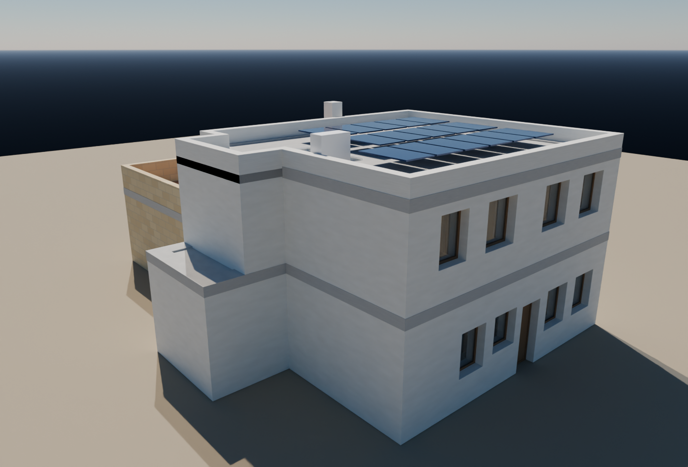
cortijo/render_exterior_sur.png
