wspoolcover/toldos/cortijo/render_planta_baja_abierta.png

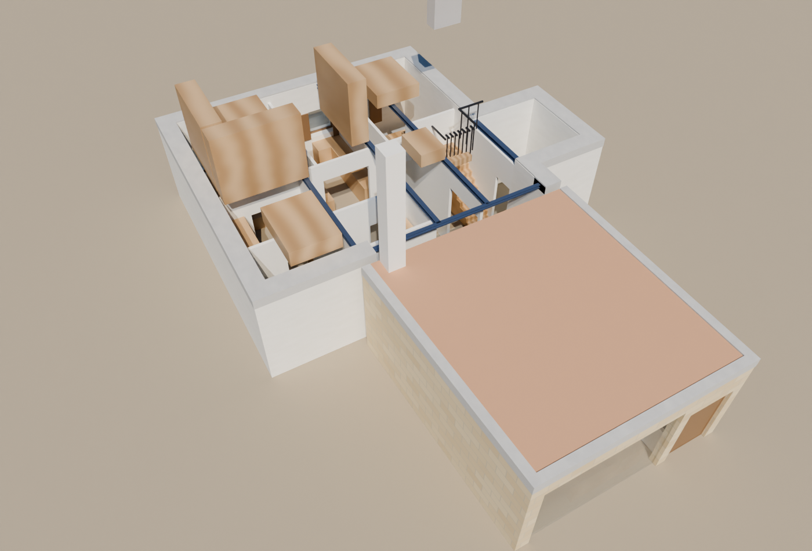
cortijo/render_planta_baja_abierta.png
