wspoolcover/toldos/cortijo/render_sala_a_cocina.png

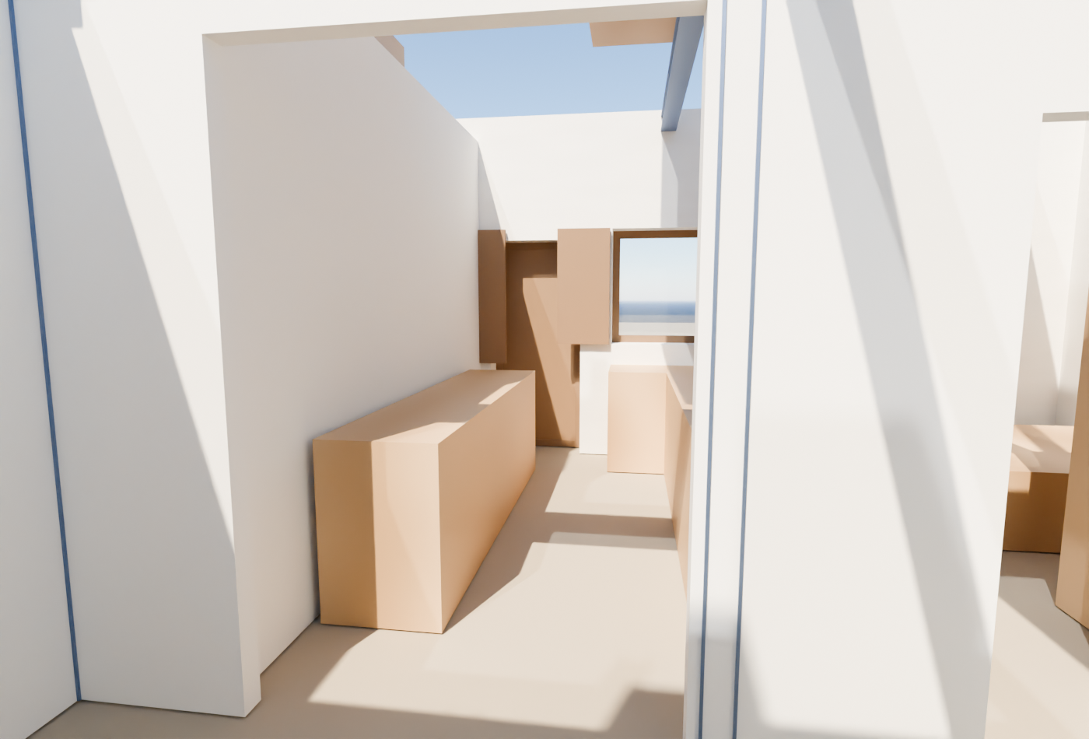
cortijo/render_sala_a_cocina.png
