wspoolcover/toldos/cortijo/render_salon_interior.png

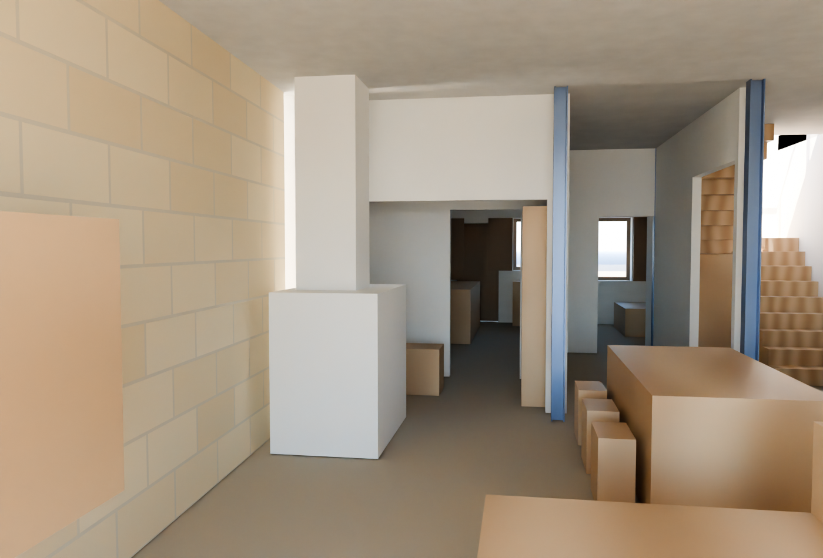
cortijo/render_salon_interior.png
