wspoolcover/toldos/cortijo/suite.png

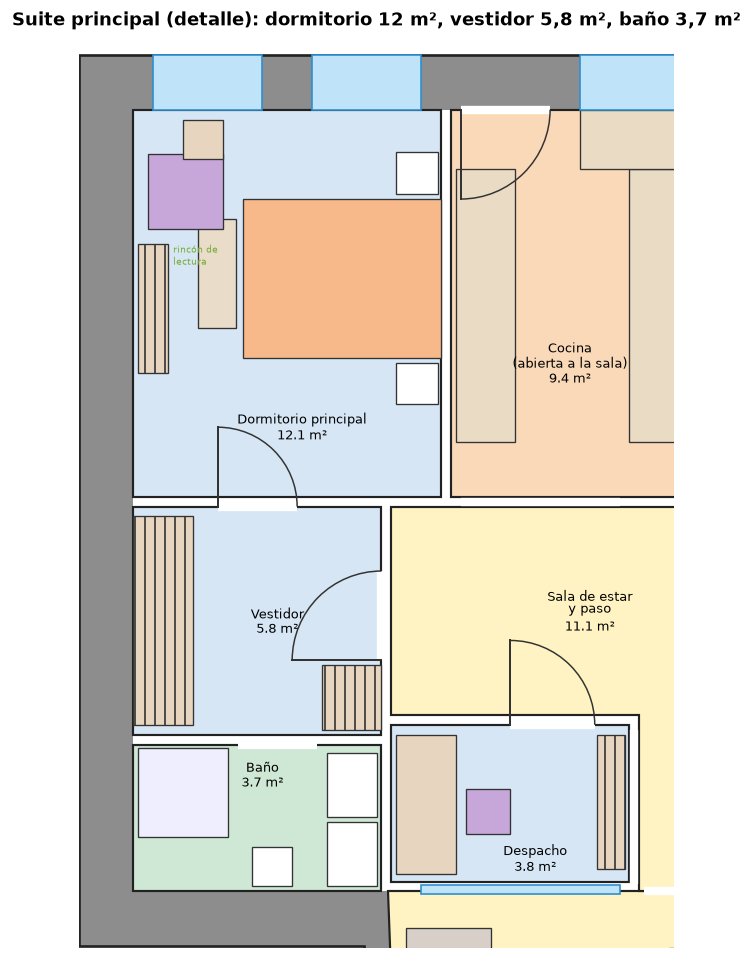
cortijo/suite.png
