wspoolcover/toldos/cortijo/pedido_proveedores.xlsx

Sheet: Ventanas
Ventanas, cristaleras y fijos (medidas del modelo v8, huecos de obra: ancho × alto en m)
Elemento | Planta | Ancho (m) | Alto (m) | Antepecho (m) | Uds | Superficie total (m²) | Descripción | Precio unidad (€) – RELLENAR | Total (€)
Cristalera del salón (norte) | Planta baja | 4 | 2.55 | 0 | 1 |  | Corredera elevable PVC + fijo, vidrio 6/16/44.2 bajo emisivo
Ventana exterior | Planta baja | 1.1 | 1.3 | 0.9 | 1 |  | PVC oscilobatiente 2 hojas, 4/16/4 bajo emisivo, persiana + contraventana
Ventana exterior | Planta baja | 1.1 | 1.3 | 0.9 | 1 |  | PVC oscilobatiente 2 hojas, 4/16/4 bajo emisivo, persiana + contraventana
Ventana exterior | Planta baja | 1 | 1.1 | 1.1 | 1 |  | PVC oscilobatiente 2 hojas, 4/16/4 bajo emisivo, persiana + contraventana
Ventana exterior | Planta alta | 1.2 | 1.3 | 0.9 | 1 |  | PVC oscilobatiente 2 hojas, 4/16/4 bajo emisivo, persiana + contraventana
Ventana exterior | Planta alta | 1.2 | 1.3 | 0.9 | 1 |  | PVC oscilobatiente 2 hojas, 4/16/4 bajo emisivo, persiana + contraventana
Ventana exterior | Planta alta | 1.2 | 1.3 | 0.9 | 1 |  | PVC oscilobatiente 2 hojas, 4/16/4 bajo emisivo, persiana + contraventana
Ventana exterior | Planta alta | 1 | 1.3 | 0.9 | 1 |  | PVC oscilobatiente 2 hojas, 4/16/4 bajo emisivo, persiana + contraventana
Ventana exterior | Planta baja | 1 | 1.3 | 0.9 | 1 |  | PVC oscilobatiente 2 hojas, 4/16/4 bajo emisivo, persiana + contraventana
Cristal fijo interior (despacho-salón) | Planta baja | 2 | 2.05 | 0 | 1 |  | Fijo con perfil PVC, vidrio laminado 33.1
Cierre acristalado de la sala familiar hacia la terraza | Planta alta | 4.63 | 2.48 | 0 | 1 |  | Fijo de suelo a techo en PVC, vidrio 4/16/4 bajo emisivo
TOTAL ventanas
Contraventanas de lamas: 2 hojas por cada ventana exterior (fachada sur y norte). Mosquiteras y persianas: según tarifa.

Sheet: Puertas
Puertas (huecos de obra)
Elemento | Planta | Ancho (m) | Alto (m) | Uds | Descripción | Precio unidad (€) – RELLENAR | Total (€)
Puerta exterior de entrada (2 hojas) | Planta baja | 1.4 | 2.2 | 1 | PVC o hierro con vidrio, cerradura 3 puntos
Puerta exterior de la cocina al patio | Planta baja | 0.9 | 2.1 | 1 | PVC o hierro con vidrio, cerradura 3 puntos
Puerta interior | Planta baja | 0.9 | 2.05 | 1 | Hoja lisa lacada, marco de madera
Puerta interior corredera empotrada | Planta baja | 0.8 | 2.05 | 1 | Hoja lisa lacada, marco de madera
Puerta interior | Planta baja | 0.8 | 2.05 | 1 | Hoja lisa lacada, marco de madera
Puerta interior | Planta baja | 0.8 | 2.05 | 1 | Hoja lisa lacada, marco de madera
Puerta interior | Planta baja | 0.85 | 2.05 | 1 | Hoja lisa lacada, marco de madera
Puerta interior | Planta baja | 0.75 | 2.05 | 1 | Hoja lisa lacada, marco de madera
Corredera a la terraza | Planta alta | 1.42 | 2.2 | 1 | PVC corredera 2 hojas, vidrio 4/16/4 bajo emisivo
Puerta interior | Planta alta | 0.9 | 2.05 | 1 | Hoja lisa lacada, marco de madera
Puerta interior | Planta alta | 0.8 | 2.05 | 1 | Hoja lisa lacada, marco de madera
Puerta interior | Planta alta | 0.8 | 2.05 | 1 | Hoja lisa lacada, marco de madera
Puerta interior | Planta alta | 0.75 | 2.05 | 1 | Hoja lisa lacada, marco de madera
TOTAL puertas

Sheet: Hierro
Lista de corte y pedido de hierro (S275JR). Longitudes entre ejes de apoyo; añadir 1–2 % de merma de corte
Pieza | Perfil | Longitud (m) | Uds | kg/m | Peso (kg) | Precio €/kg – RELLENAR | Total (€)
Vigas de forjado PB/PA | HEB 140 | 8.43 | 3 | 33.7 | 852.3
Vigas de forjado PB/PA | HEB 120 | 0.5 | 1 | 26.7 | 13.3
Vigas de forjado PB/PA | HEB 120 | 2.45 | 1 | 26.7 | 65.4
Vigas de forjado PB/PA | HEB 120 | 1.65 | 1 | 26.7 | 44.1
Vigas de forjado PB/PA | HEB 120 | 2.08 | 1 | 26.7 | 55.5
Vigas de forjado PB/PA | HEB 160 | 3.9 | 1 | 42.6 | 166.1
Vigas de cubierta | HEB 140 | 8.43 | 3 | 33.7 | 852.3
Vigas de cubierta | HEB 120 | 0.5 | 1 | 26.7 | 13.3
Vigas de cubierta | HEB 120 | 2.45 | 1 | 26.7 | 65.4
Vigas de cubierta | HEB 120 | 1.65 | 1 | 26.7 | 44.1
Vigas de cubierta | HEB 120 | 2.08 | 1 | 26.7 | 55.5
Vigas de cubierta | HEB 160 | 3.9 | 1 | 42.6 | 166.1
Pilares | HEB 120 | 5.77 | 6 | 26.7 | 924.4
Dintel de la cristalera del salón | HEB 160 | 4.4 | 1 | 42.6 | 187.4
Dinteles de huecos | IPE 120 | 1.8 | 1 | 10.4 | 18.7
Dinteles de huecos | IPE 100 | 1.5 | 2 | 8.1 | 24.3
Dinteles de huecos | IPE 100 | 1.4 | 3 | 8.1 | 34
Dinteles de huecos | IPE 100 | 1.3 | 1 | 8.1 | 10.5
Dinteles de huecos | IPE 100 | 1.6 | 3 | 8.1 | 38.9
Placas base y cabeza de pilares + anclajes (12 uds, estimado) |  |  | 12 |  | 168
Escalera de acero: 2 zancas UPN + 17 peldaños + descansillo (estimado) |  |  | 1 |  | 380
Barandillas: lado abierto de la escalera, suelo junto al hueco y pasamanos (≈ 10 m, estimado) |  |  | 10 |  | 140
Soportes de 16 paneles solares, acero galvanizado (≈ 5 kg/panel, estimado) |  |  | 16 |  | 80
Tornillería, cartelas y piezas de unión (≈ 3 %) |  |  | 1 |  | 108.9
TOTAL hierro
Las filas sin perfil son estimaciones mías (escalera, barandillas, soportes solares, placas): confirmar con el taller. Las secciones de las vigas son una propuesta que debe calcular un ingeniero.

Sheet: Resumen y ahorro
Resumen y ahorro frente a precio de mercado
Concepto | Tu coste (€) | Referencia mercado (€) – RELLENAR | Ahorro (€) | Ahorro (%)
Ventanas y cristaleras
Puertas
Hierro (estructura, escalera, barandillas)
TOTAL
