wspoolcover/toldos/casa3d/planta_alta_v3.dxf

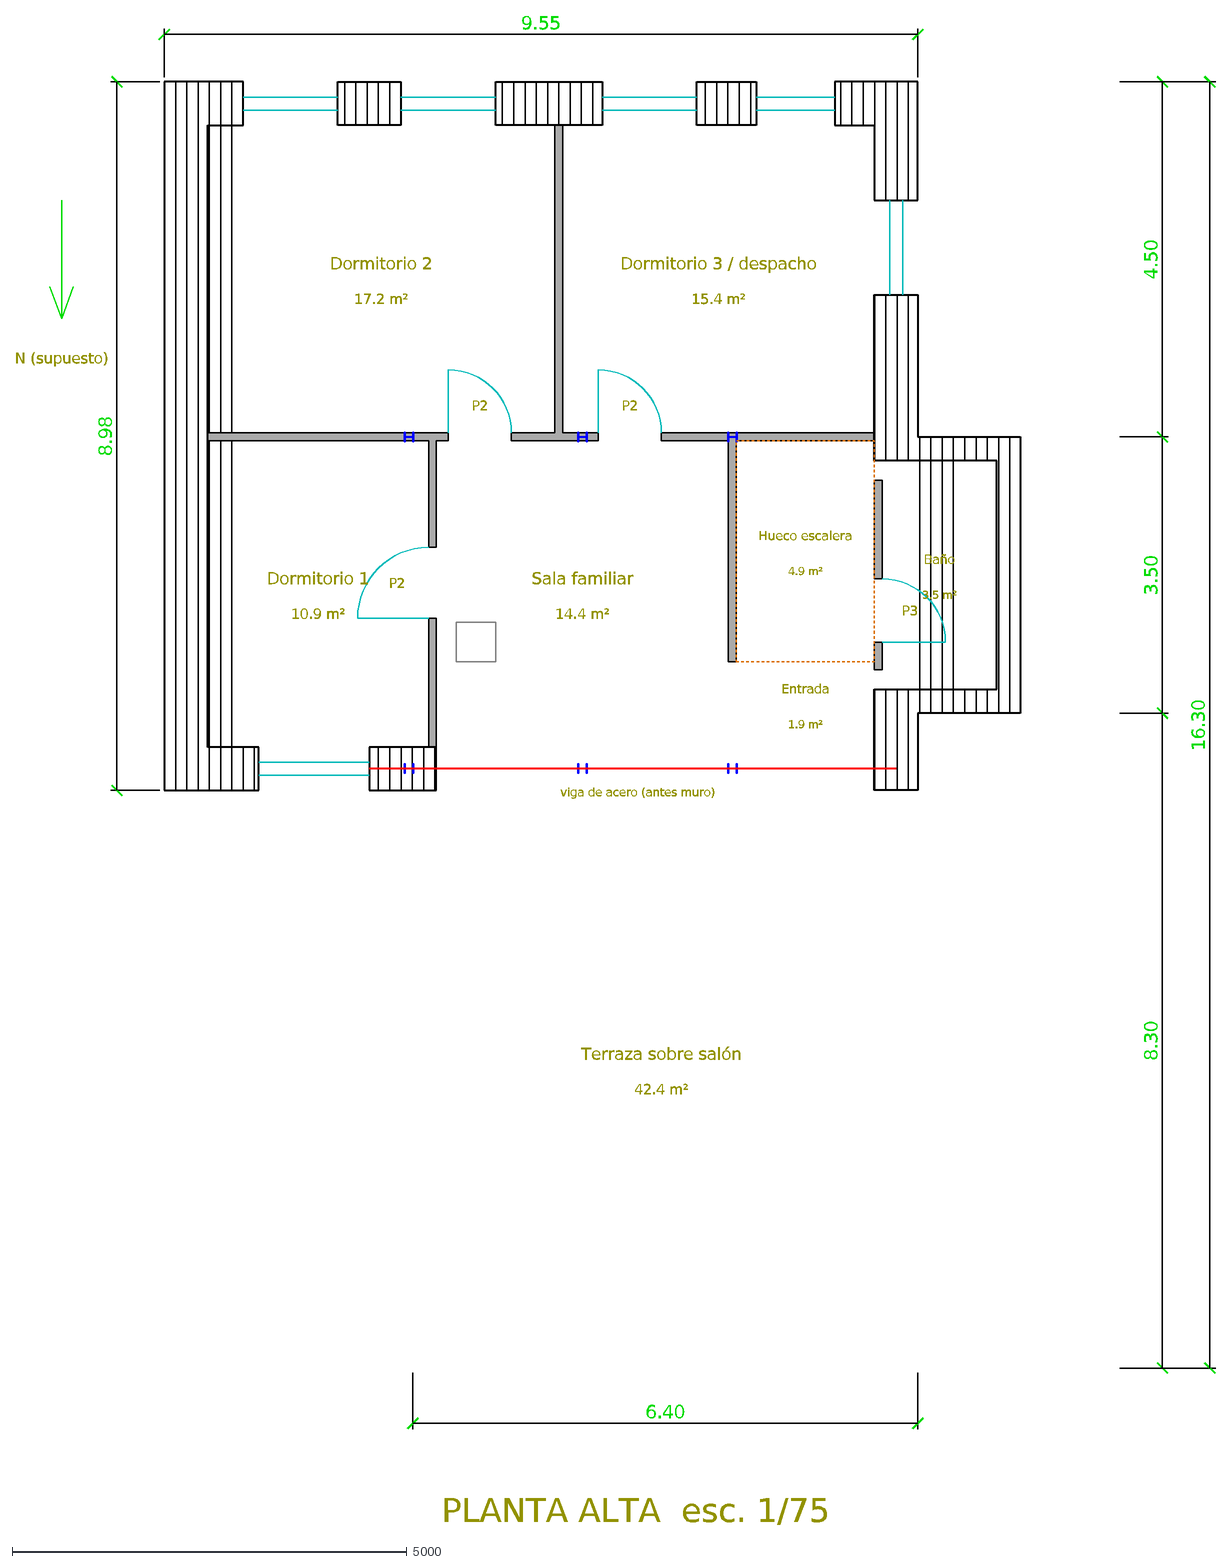
[picture p61: CAD file, 2026-09-29]
casa3d/planta_alta_v3.dxf
P2
P3
viga de acero (antes muro)
Terraza sobre salón
42.4 m²
Sala familiar
14.4 m²
Entrada
1.9 m²
Baño
3.5 m²
Dormitorio 1
10.9 m²
Dormitorio 2
17.2 m²
Dormitorio 3 / despacho
15.4 m²
Hueco escalera
4.9 m²
6.40
8.30
3.50
4.50
16.30
9.55
8.98
N (supuesto)
PLANTA ALTA esc. 1/75
