wspoolcover/toldos/casa3d/casa.step

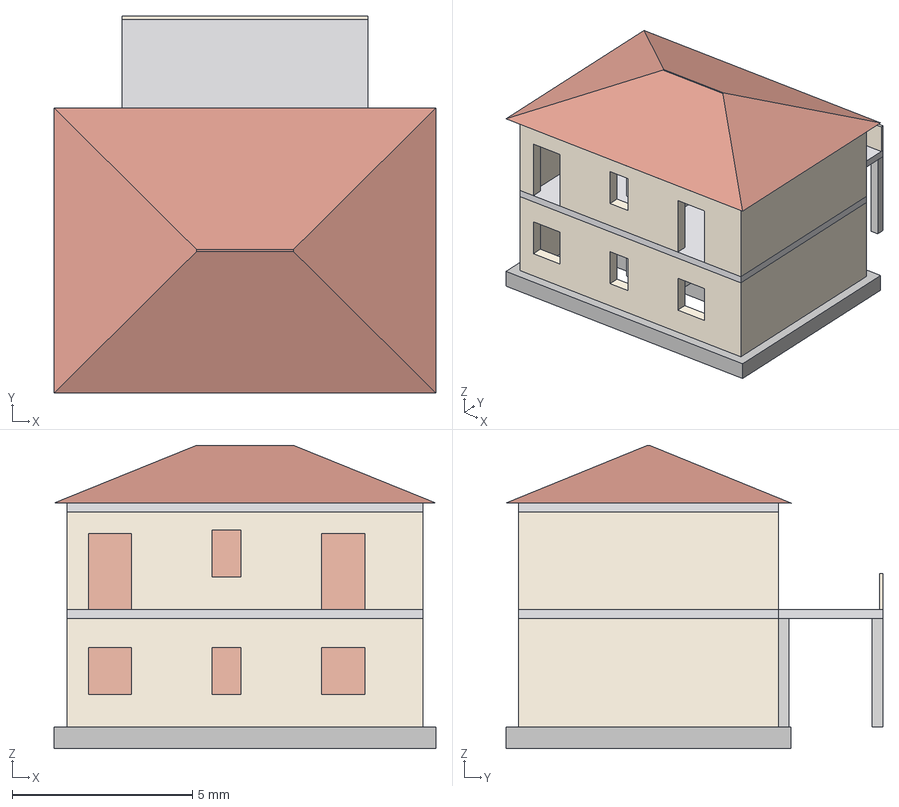
[picture p62: CAD file, 2026-09-29]
casa3d/casa.step
10.6 x 10.4 x 8.41 mm
cimentacion
muros_PB
muros_PA
MURO_CENTRAL
tabiques
forjado_PB_PA
escalera
losa_terraza
pilares
antepecho
forjado_cubierta
cubierta
