wspoolcover/toldos/cortijo/planta_baja_v8.dxf

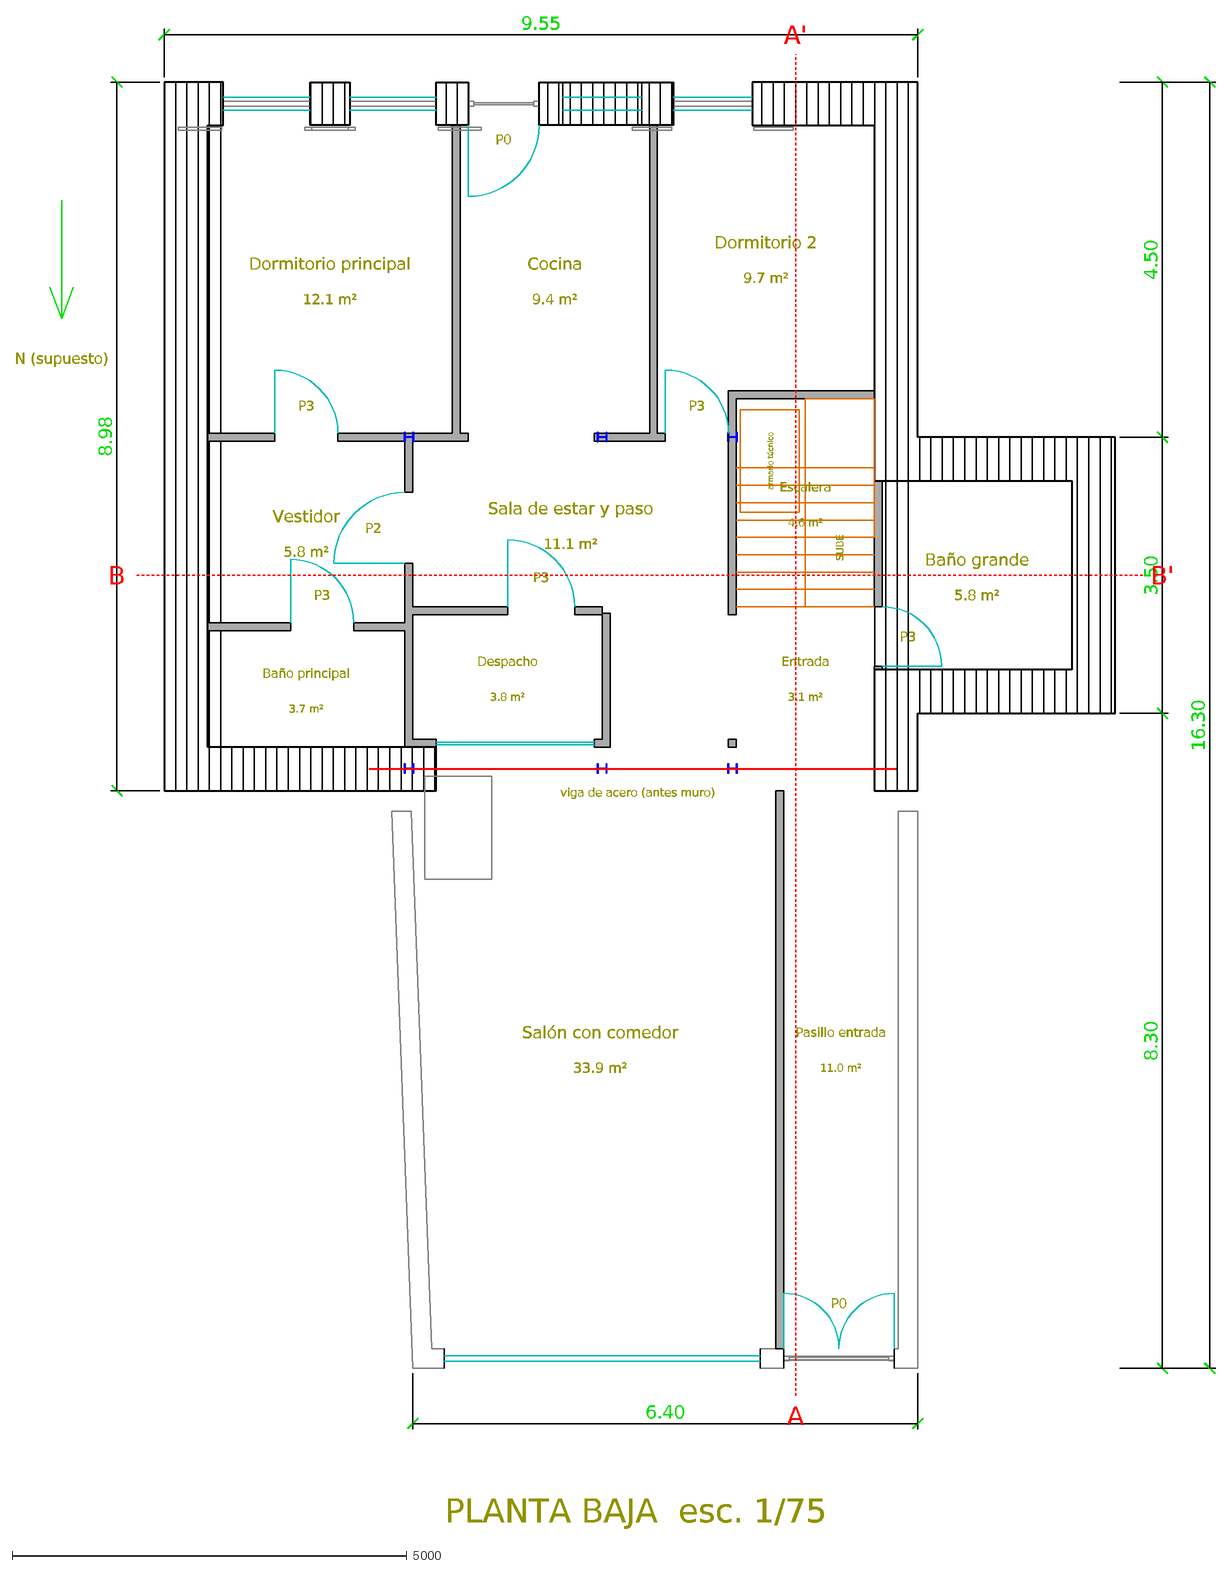
[picture p63: CAD file, 2026-10-13]
cortijo/planta_baja_v8.dxf
P0
P2
P3
SUBE
armario técnico
viga de acero (antes muro)
Salón con comedor
33.9 m²
Pasillo entrada
11.0 m²
Entrada
3.1 m²
Escalera
4.6 m²
Baño grande
5.8 m²
Sala de estar y paso
11.1 m²
Cocina
9.4 m²
Dormitorio principal
12.1 m²
Dormitorio 2
9.7 m²
Despacho
3.8 m²
Vestidor
Baño principal
3.7 m²
6.40
8.30
3.50
4.50
16.30
9.55
8.98
N (supuesto)
A
A'
B
B'
PLANTA BAJA esc. 1/75
