wspoolcover/toldos/cortijo/planta_alta_v8.dxf

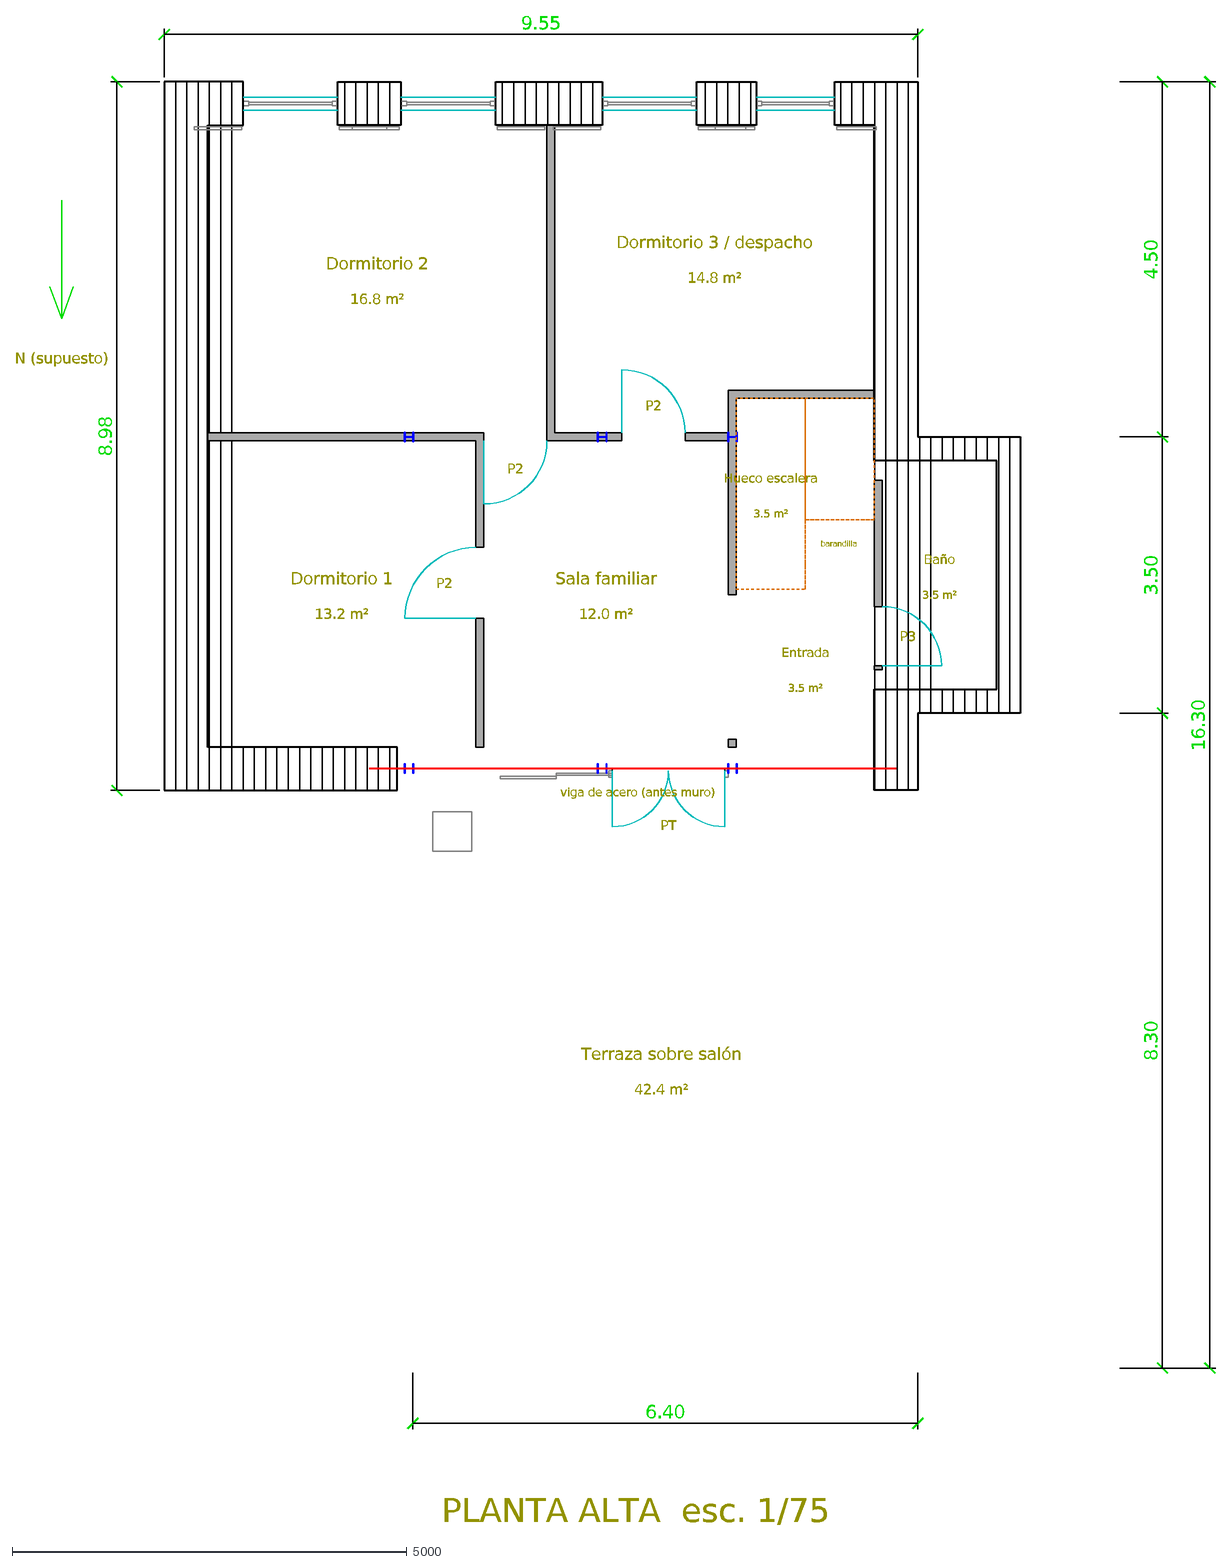
[picture p64: CAD file, 2026-10-13]
cortijo/planta_alta_v8.dxf
PT
P2
P3
barandilla
viga de acero (antes muro)
Terraza sobre salón
42.4 m²
Sala familiar
12.0 m²
Entrada
3.5 m²
Baño
Dormitorio 1
13.2 m²
Dormitorio 2
16.8 m²
Dormitorio 3 / despacho
14.8 m²
Hueco escalera
6.40
8.30
3.50
4.50
16.30
9.55
8.98
N (supuesto)
PLANTA ALTA esc. 1/75
