wspoolcover/toldos/casa3d/seccion_longitudinal_v2.dxf

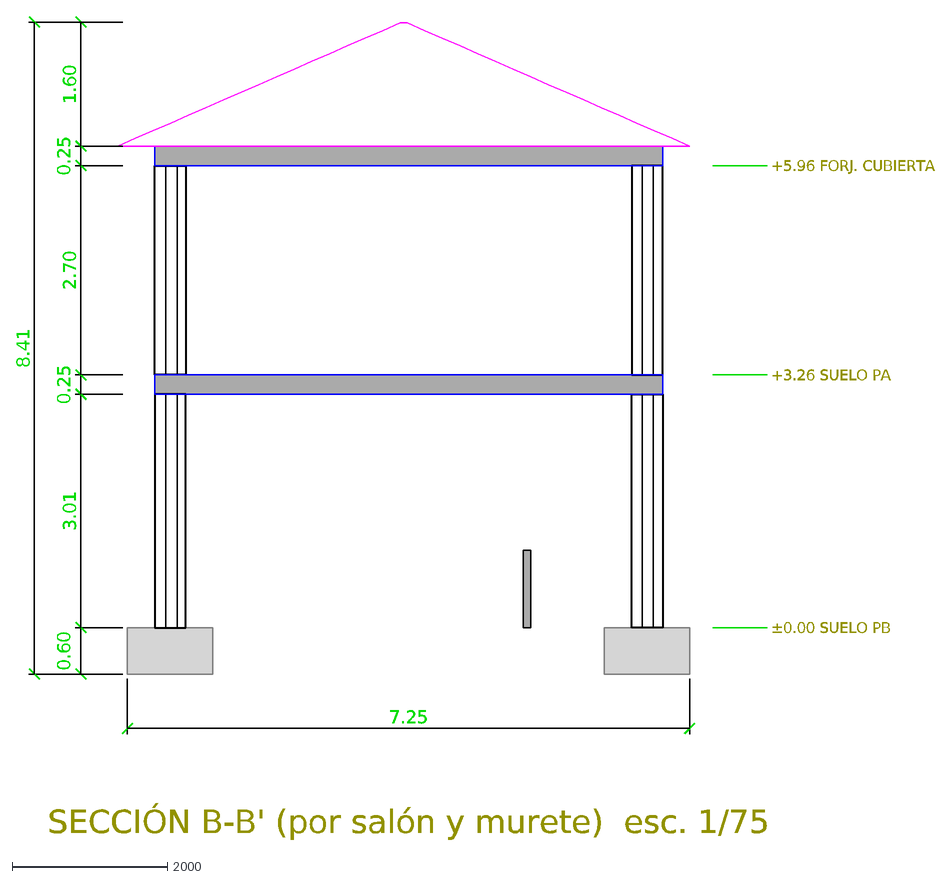
[picture p65: CAD file, 2026-09-29]
casa3d/seccion_longitudinal_v2.dxf
0.60
3.01
0.25
2.70
1.60
8.41
7.25
±0.00 SUELO PB
+3.26 SUELO PA
+5.96 FORJ. CUBIERTA
SECCIÓN B-B' (por salón y murete) esc. 1/75
