wspoolcover/toldos/cortijo/estructura_cubierta_v8.dxf

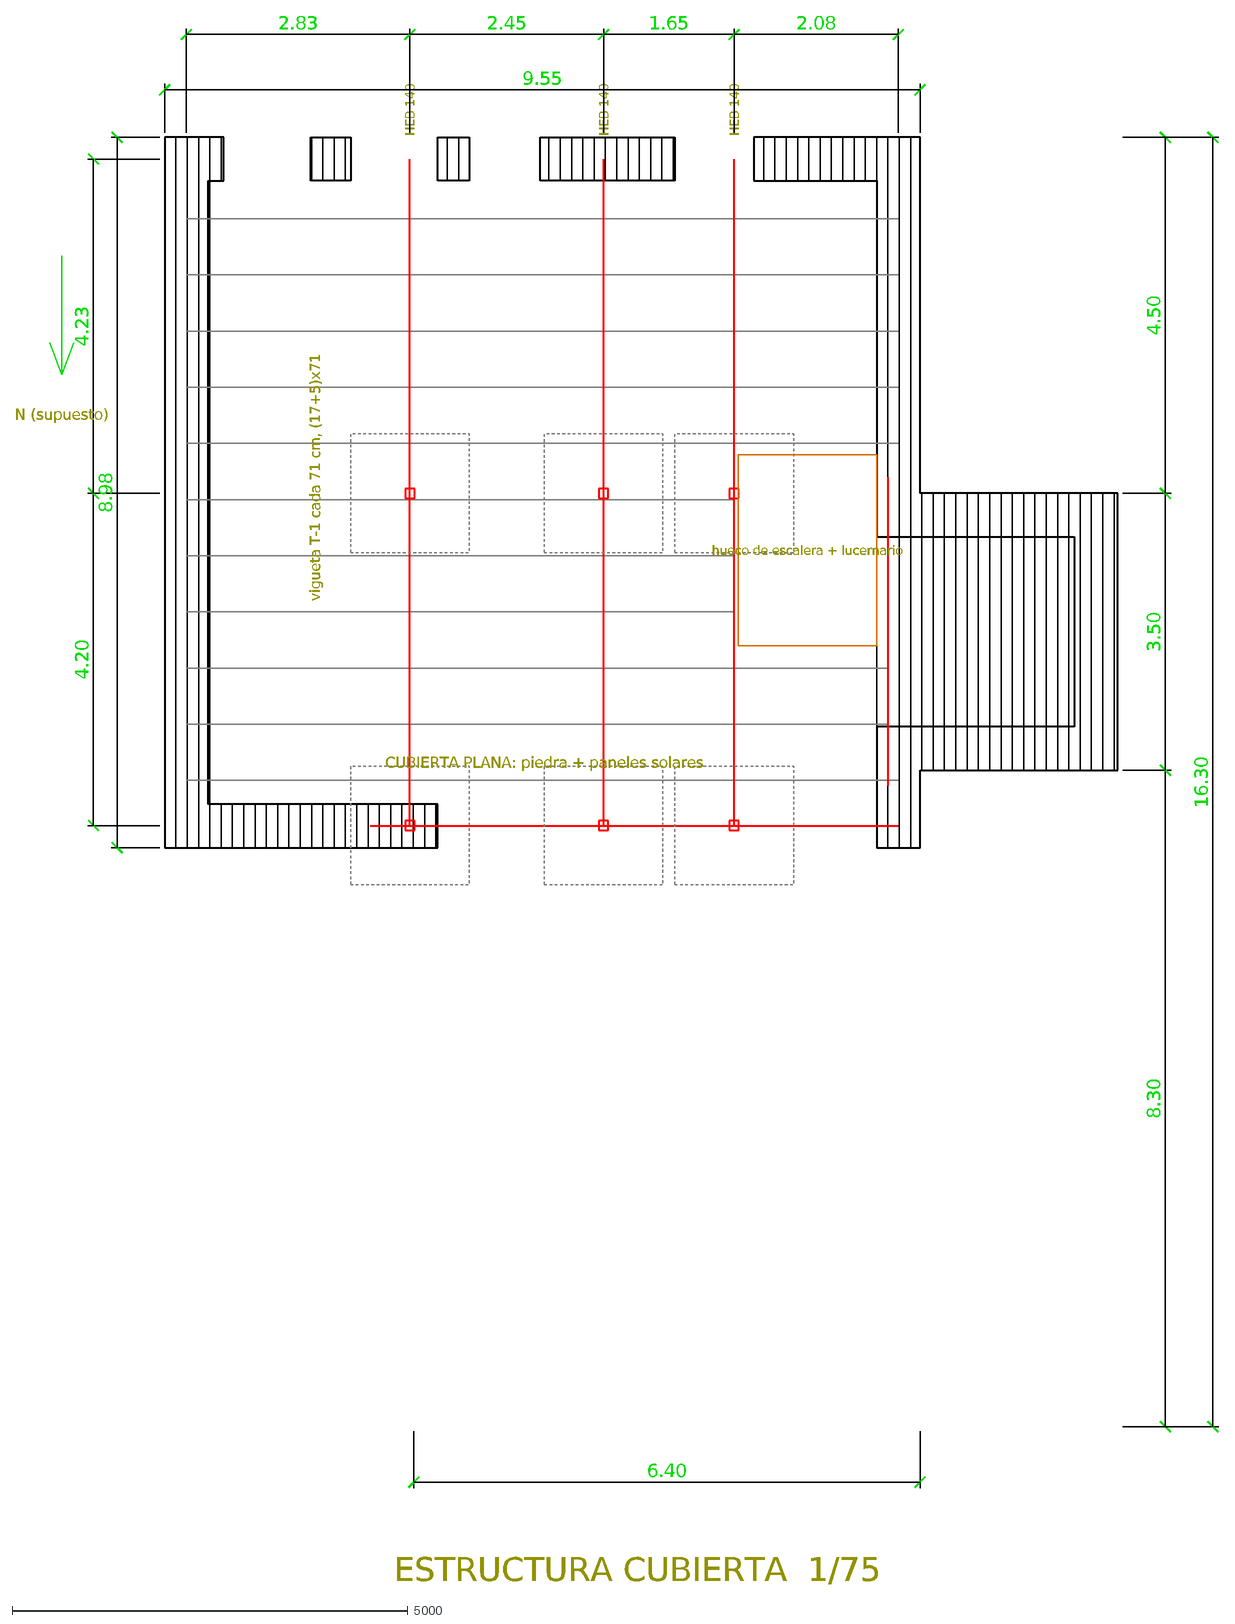
[picture p66: CAD file, 2026-10-13]
cortijo/estructura_cubierta_v8.dxf
hueco de escalera + lucernario
vigueta T-1 cada 71 cm, (17+5)x71
CUBIERTA PLANA: piedra + paneles solares
HEB 140
2.83
2.45
1.65
2.08
4.20
4.23
6.40
8.30
3.50
4.50
16.30
9.55
8.98
N (supuesto)
ESTRUCTURA CUBIERTA 1/75
