wspoolcover/toldos/casa3d/planta_baja_v2.dxf

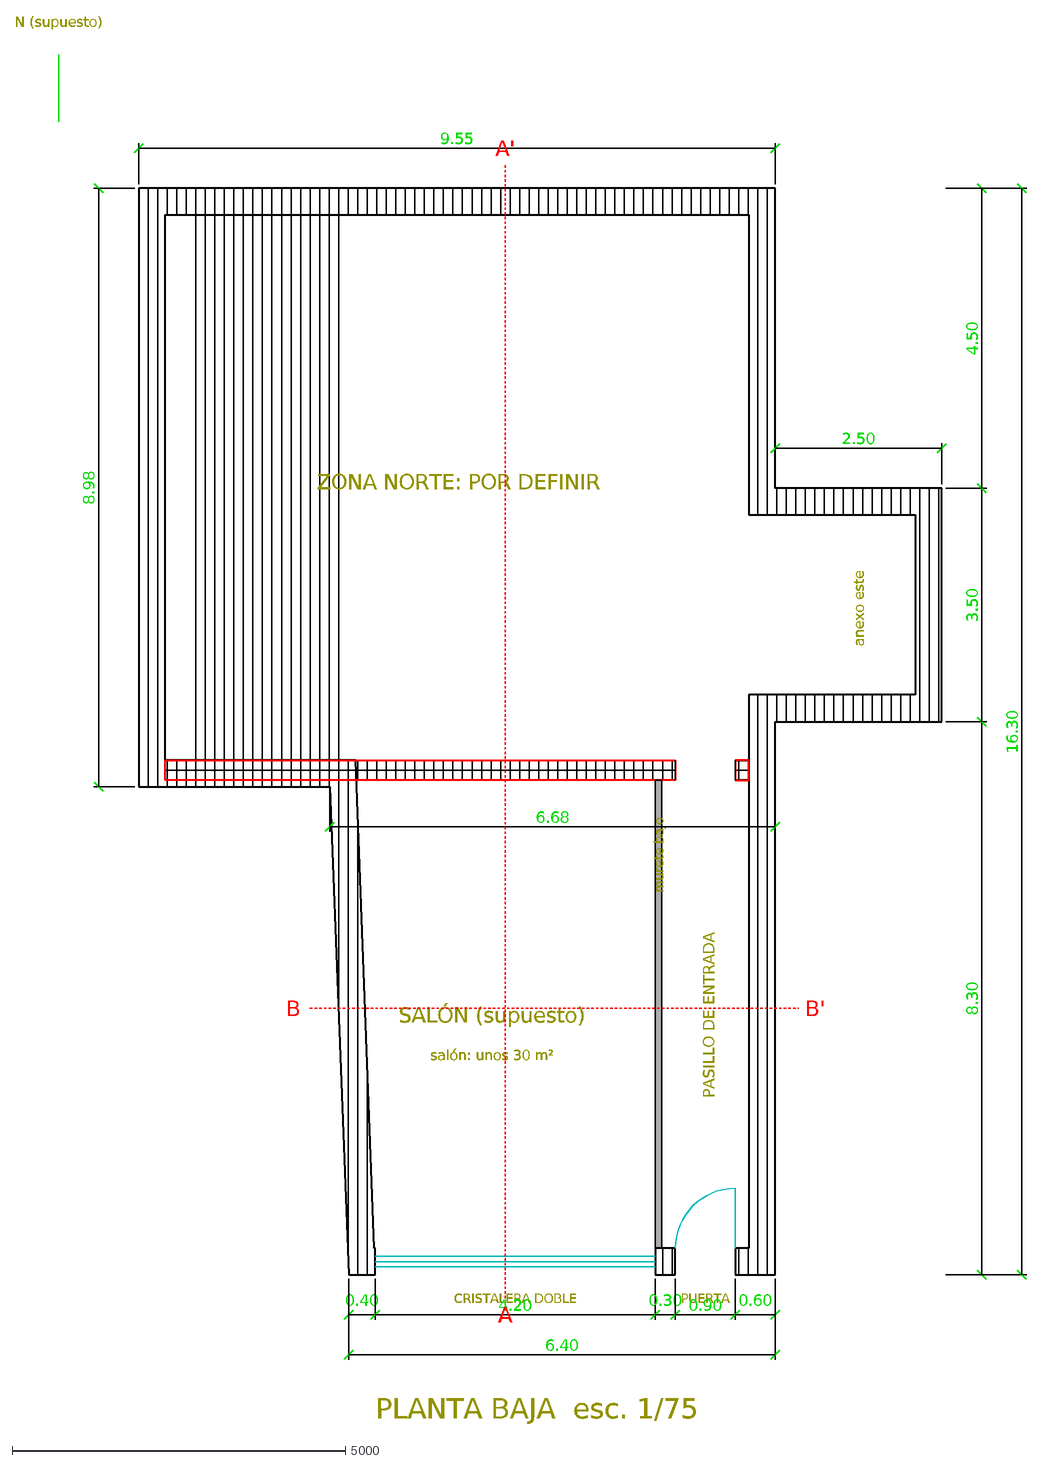
[picture p67: CAD file, 2026-09-29]
casa3d/planta_baja_v2.dxf
CRISTALERA DOBLE
PUERTA
SALÓN (supuesto)
salón: unos 30 m²
PASILLO DE ENTRADA
murete bajo
ZONA NORTE: POR DEFINIR
anexo este
0.40
4.20
0.30
0.90
0.60
6.40
8.30
3.50
4.50
16.30
2.50
9.55
8.98
6.68
A
A'
B
B'
N (supuesto)
PLANTA BAJA esc. 1/75
