wspoolcover/toldos/cortijo/casa_v8.step

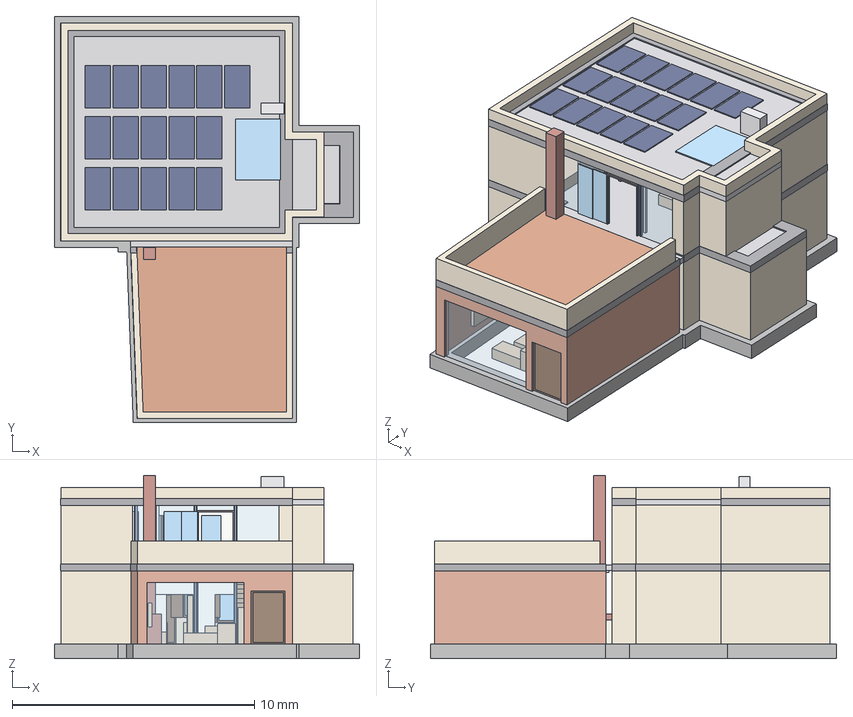
[picture p69: CAD file, 2026-10-13]
cortijo/casa_v8.step
12.6 x 16.8 x 7.56 mm
cimentacion
muros_PB
muros_salon
muros_PA
parapeto_terraza
parapeto_cubierta
forjado_PB_PA
forjado_salon
zuncho_forjado
zuncho_cubierta
riostras
forjado_cubierta
tabiques_PB
tabiques_PA
murete_pasillo
escalera
barandillas
lucernario
cristal_PB
cristal_PA
vidrios_terraza
carpinteria_terraza
carpinteria_PB
carpinteria_PA
vidrios_PB
vidrios_PA
puertas_PB
puertas_PA
puerta_entrada
solado_terraza
mobiliario
chimenea
paneles_solares
aerotermia
acero_vigas_forjado
acero_vigas_cubierta
acero_pilares
acero_dintel
acero_dinteles
