wspoolcover/toldos/casa3d/seccion_transversal.dxf

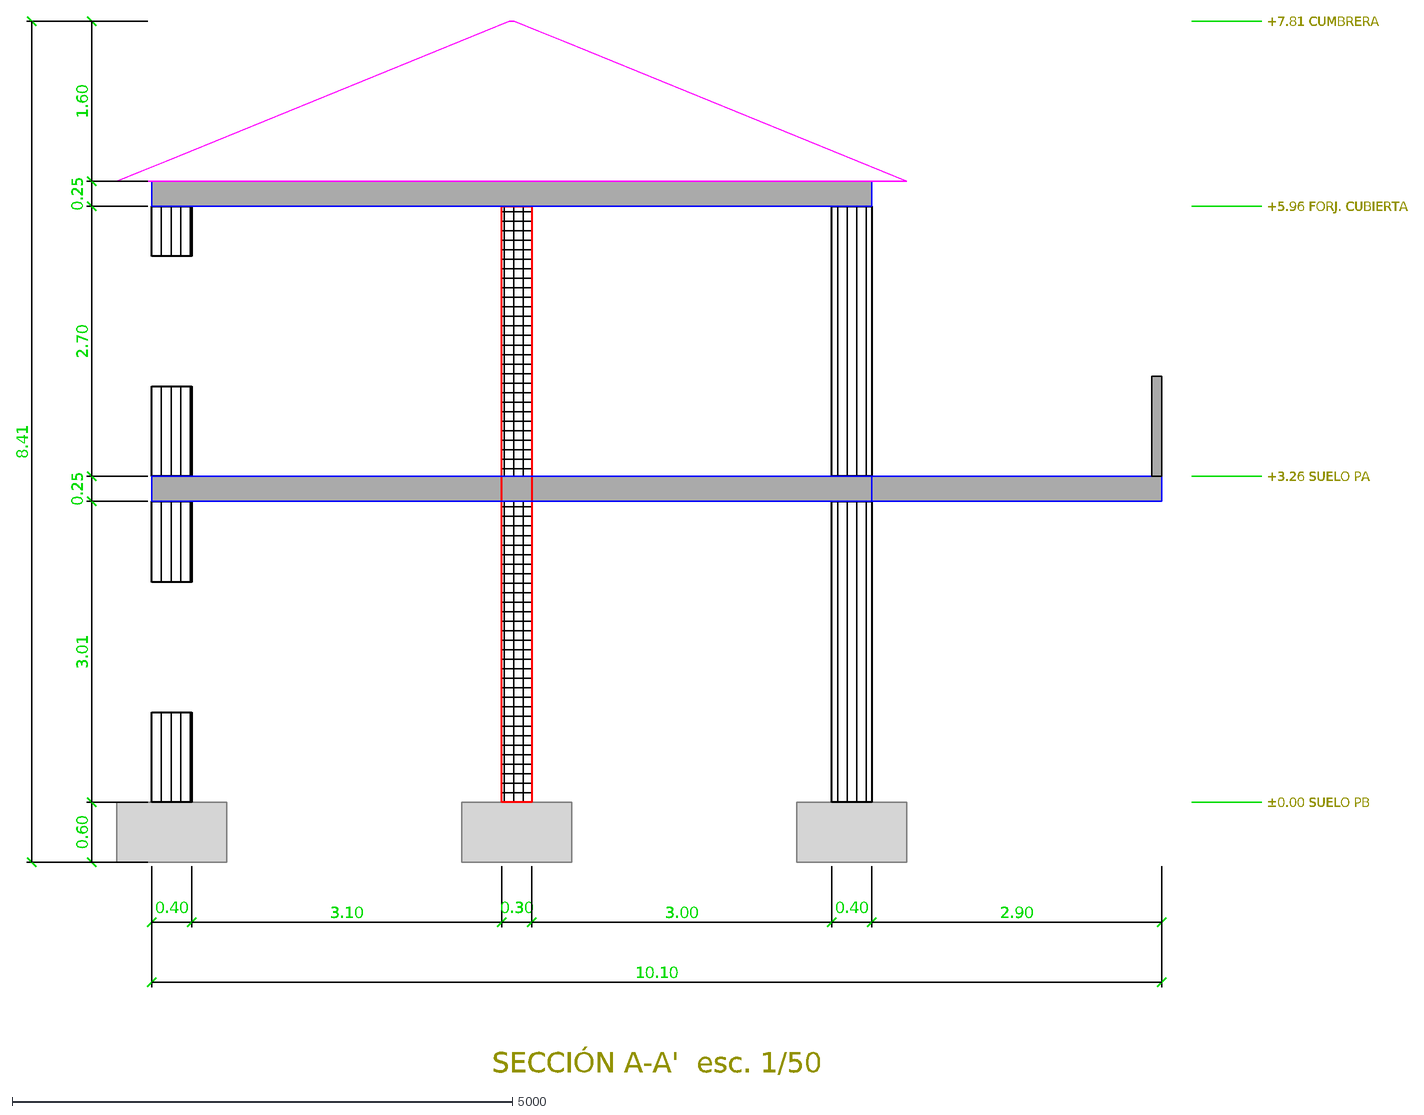
[picture p70: CAD file, 2026-09-28]
casa3d/seccion_transversal.dxf
0.60
3.01
0.25
2.70
1.60
8.41
0.40
3.10
0.30
3.00
2.90
10.10
±0.00 SUELO PB
+3.26 SUELO PA
+5.96 FORJ. CUBIERTA
+7.81 CUMBRERA
SECCIÓN A-A' esc. 1/50
