wspoolcover/toldos/cortijo/estructura_forjado_v8.dxf

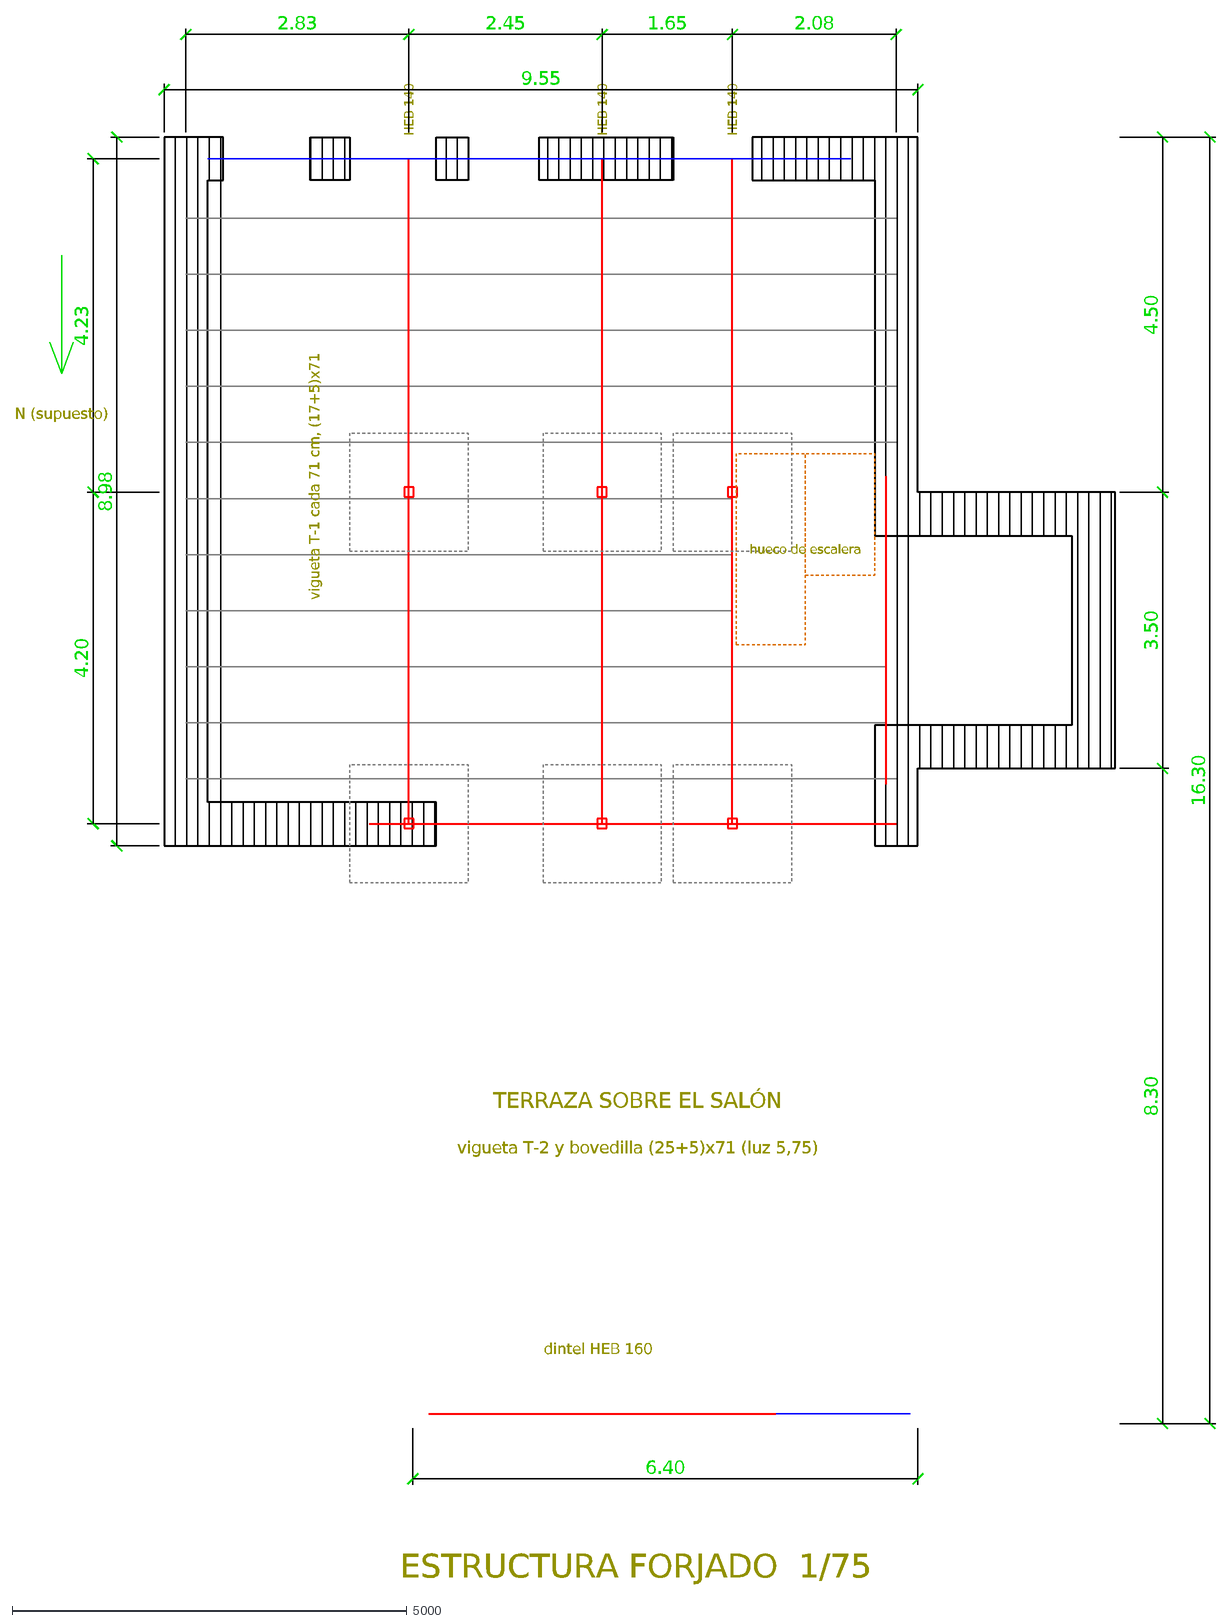
[picture p71: CAD file, 2026-10-13]
cortijo/estructura_forjado_v8.dxf
hueco de escalera
vigueta T-2 y bovedilla (25+5)x71 (luz 5,75)
TERRAZA SOBRE EL SALÓN
vigueta T-1 cada 71 cm, (17+5)x71
dintel HEB 160
HEB 140
2.83
2.45
1.65
2.08
4.20
4.23
6.40
8.30
3.50
4.50
16.30
9.55
8.98
N (supuesto)
ESTRUCTURA FORJADO 1/75
