wspoolcover/toldos/casa3d/seccion_longitudinal_muro_central.dxf

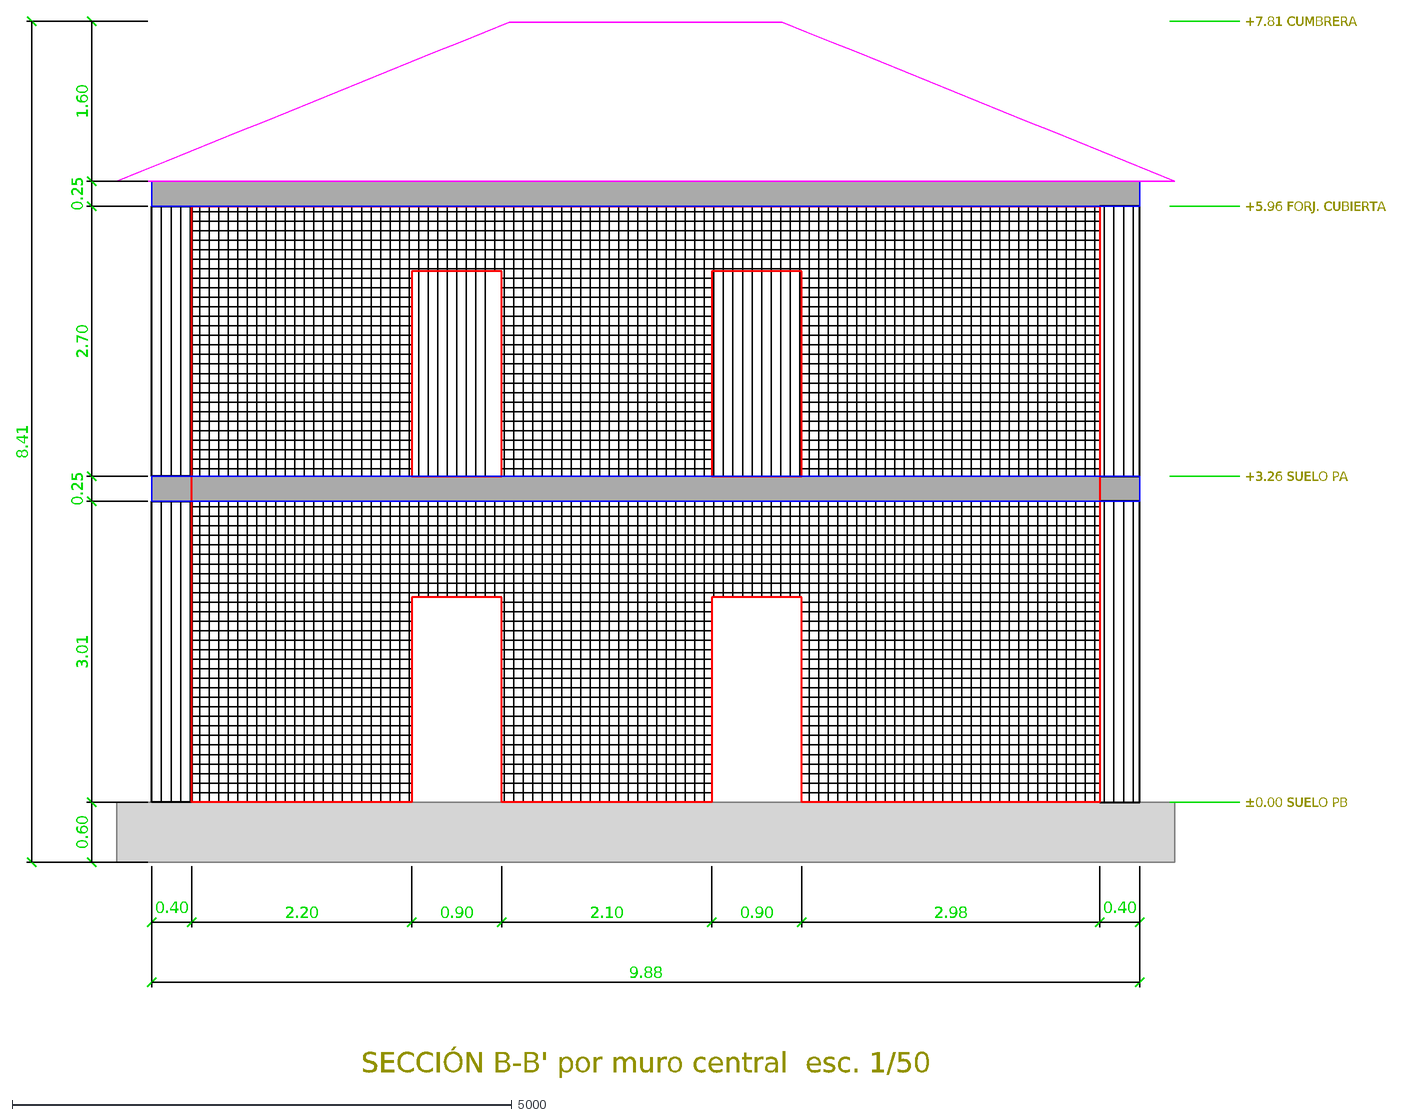
[picture p72: CAD file, 2026-09-28]
casa3d/seccion_longitudinal_muro_central.dxf
0.60
3.01
0.25
2.70
1.60
8.41
0.40
2.20
0.90
2.10
2.98
9.88
±0.00 SUELO PB
+3.26 SUELO PA
+5.96 FORJ. CUBIERTA
+7.81 CUMBRERA
SECCIÓN B-B' por muro central esc. 1/50
