wspoolcover/toldos/cortijo/seccion_B_v8.dxf

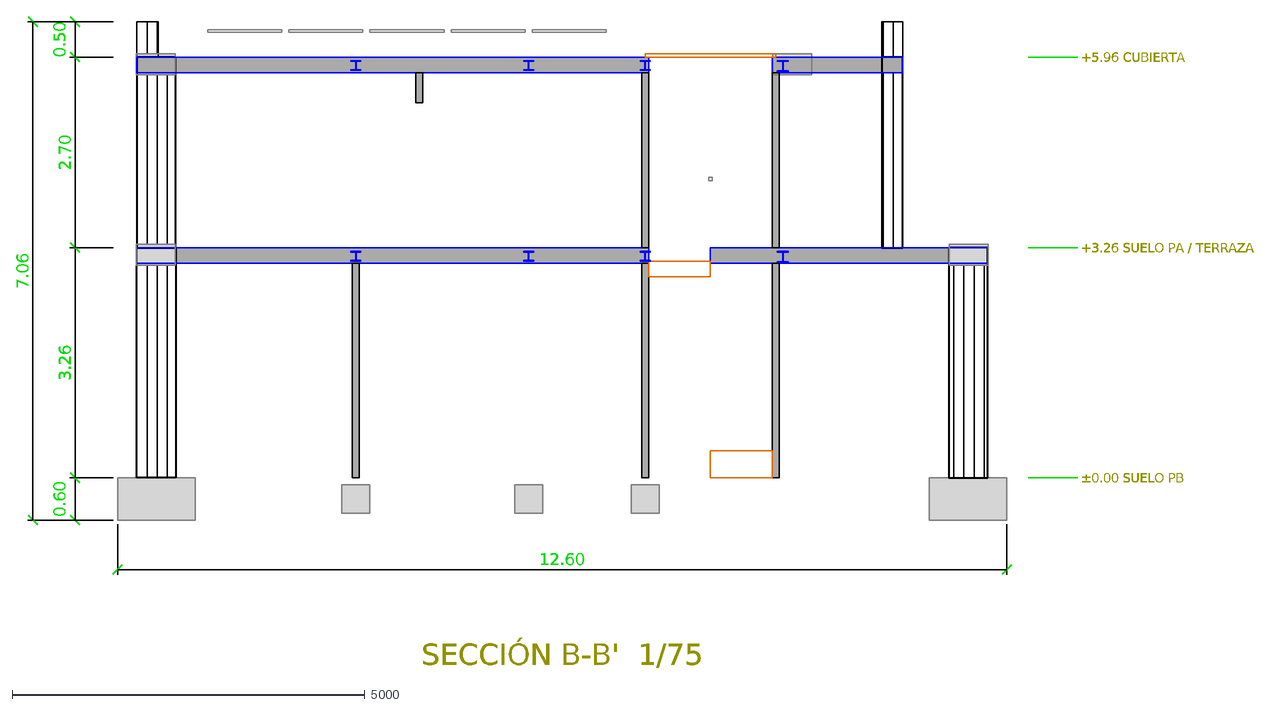
[picture p73: CAD file, 2026-10-13]
cortijo/seccion_B_v8.dxf
0.60
3.26
2.70
0.50
7.06
12.60
±0.00 SUELO PB
+3.26 SUELO PA / TERRAZA
+5.96 CUBIERTA
SECCIÓN B-B' 1/75
