wspoolcover/toldos/cortijo/cimentacion_v7.dxf

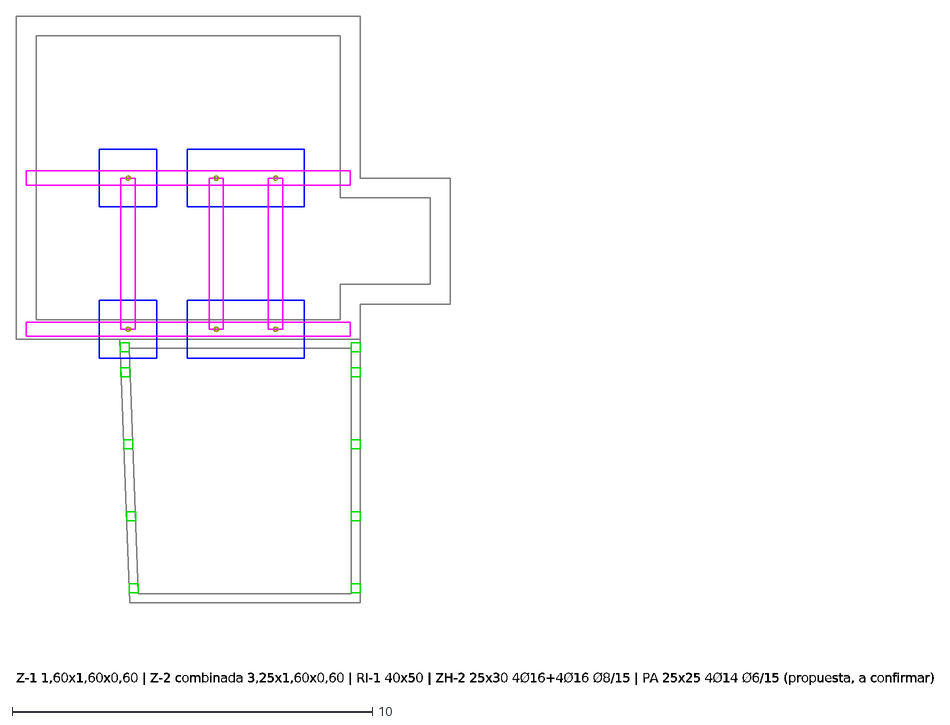
[picture p74: CAD file, 2026-10-13]
cortijo/cimentacion_v7.dxf
Z-1 1,60x1,60x0,60 | Z-2 combinada 3,25x1,60x0,60 | RI-1 40x50 | ZH-2 25x30 4Ø16+4Ø16 Ø8/15 | PA 25x25 4Ø14 Ø6/15 (propuesta, a confirmar)
