wspoolcover/toldos/cortijo/seccion_transversal_v2.dxf

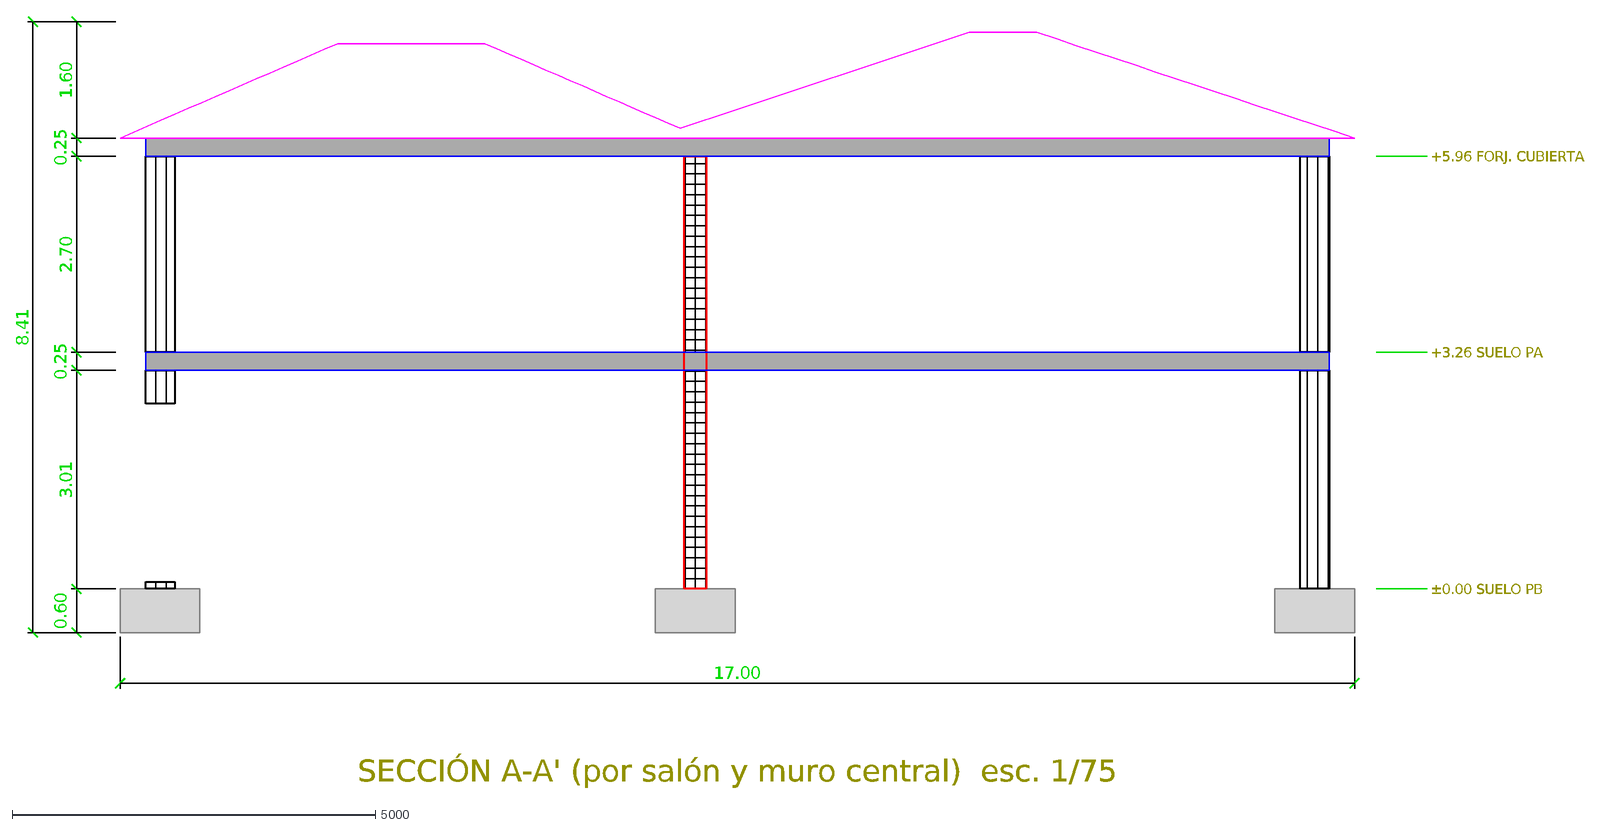
[picture p75: CAD file, 2026-09-29]
cortijo/seccion_transversal_v2.dxf
0.60
3.01
0.25
2.70
1.60
8.41
17.00
±0.00 SUELO PB
+3.26 SUELO PA
+5.96 FORJ. CUBIERTA
SECCIÓN A-A' (por salón y muro central) esc. 1/75
