wspoolcover/toldos/(list of files, cad)

Other CAD files:
cortijo/lamina_A1_v8_distribucion.dxf
casa3d/lamina_A1_v2.dxf
cortijo/lamina_A1_v8_estructura.dxf
casa3d/lamina_A1.dxf
casa3d/planta_baja.dxf
cortijo/casa.step
cortijo/casa_v2.step
cortijo/casa_v3.step
cortijo/casa_v4.step
cortijo/casa_v5.step
cortijo/casa_v6.step
cortijo/casa_v7.step
cortijo/estructura_cubierta_v3.dxf
cortijo/estructura_cubierta_v4.dxf
cortijo/estructura_cubierta_v5.dxf
cortijo/estructura_cubierta_v6.dxf
cortijo/estructura_cubierta_v7.dxf
cortijo/estructura_forjado_v3.dxf
cortijo/estructura_forjado_v4.dxf
cortijo/estructura_forjado_v5.dxf
cortijo/estructura_forjado_v6.dxf
cortijo/estructura_forjado_v7.dxf
cortijo/lamina_A1_v3_distribucion.dxf
cortijo/lamina_A1_v3_estructura.dxf
cortijo/lamina_A1_v4_distribucion.dxf
cortijo/lamina_A1_v4_estructura.dxf
cortijo/lamina_A1_v5_distribucion.dxf
cortijo/lamina_A1_v5_estructura.dxf
cortijo/lamina_A1_v6_distribucion.dxf
cortijo/lamina_A1_v6_estructura.dxf
cortijo/lamina_A1_v7_distribucion.dxf
cortijo/lamina_A1_v7_estructura.dxf
cortijo/planta_alta.dxf
cortijo/planta_alta_v2.dxf
cortijo/planta_alta_v4.dxf
cortijo/planta_alta_v5.dxf
cortijo/planta_alta_v6.dxf
cortijo/planta_alta_v7.dxf
cortijo/planta_baja_v3.dxf
cortijo/planta_baja_v4.dxf
cortijo/planta_baja_v5.dxf
cortijo/planta_baja_v6.dxf
cortijo/planta_baja_v7.dxf
cortijo/seccion_A_v3.dxf
cortijo/seccion_A_v4.dxf
cortijo/seccion_A_v5.dxf
cortijo/seccion_A_v6.dxf
cortijo/seccion_A_v7.dxf
cortijo/seccion_B_v3.dxf
cortijo/seccion_B_v4.dxf
cortijo/seccion_B_v5.dxf
cortijo/seccion_B_v6.dxf
cortijo/seccion_B_v7.dxf
