wspoolcover/toldos/cortijo/pdf/planos/cimentacion_v7.pdf

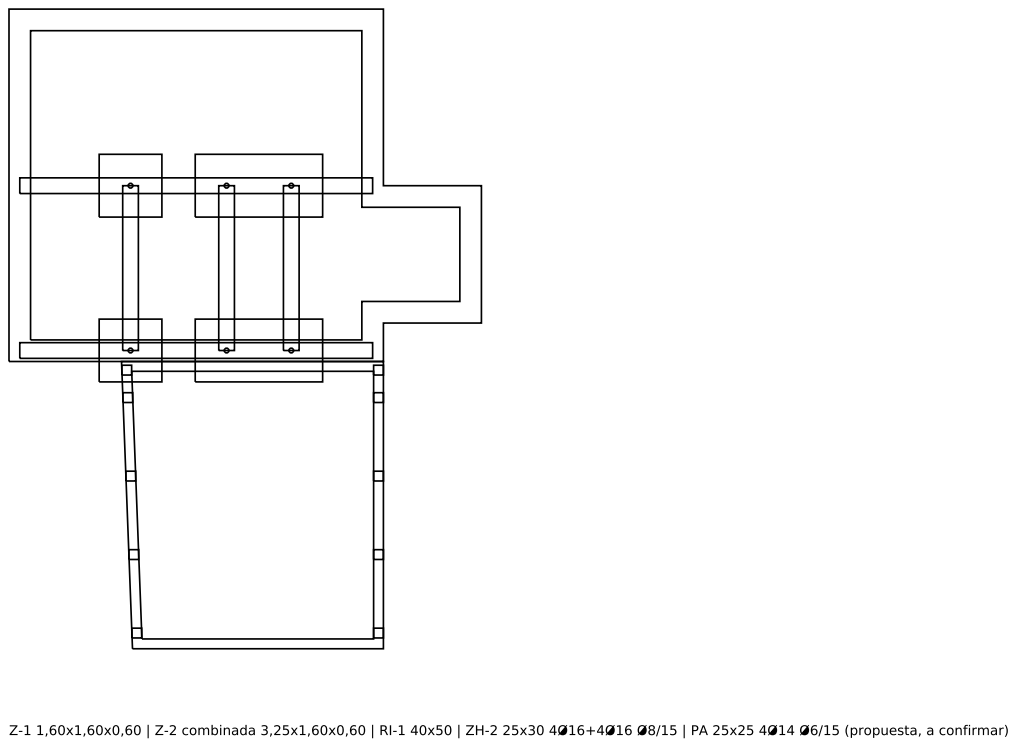
[picture p76: page 1]
