wspoolcover/toldos/cortijo/pdf/planos/estructura_cubierta_v8.pdf

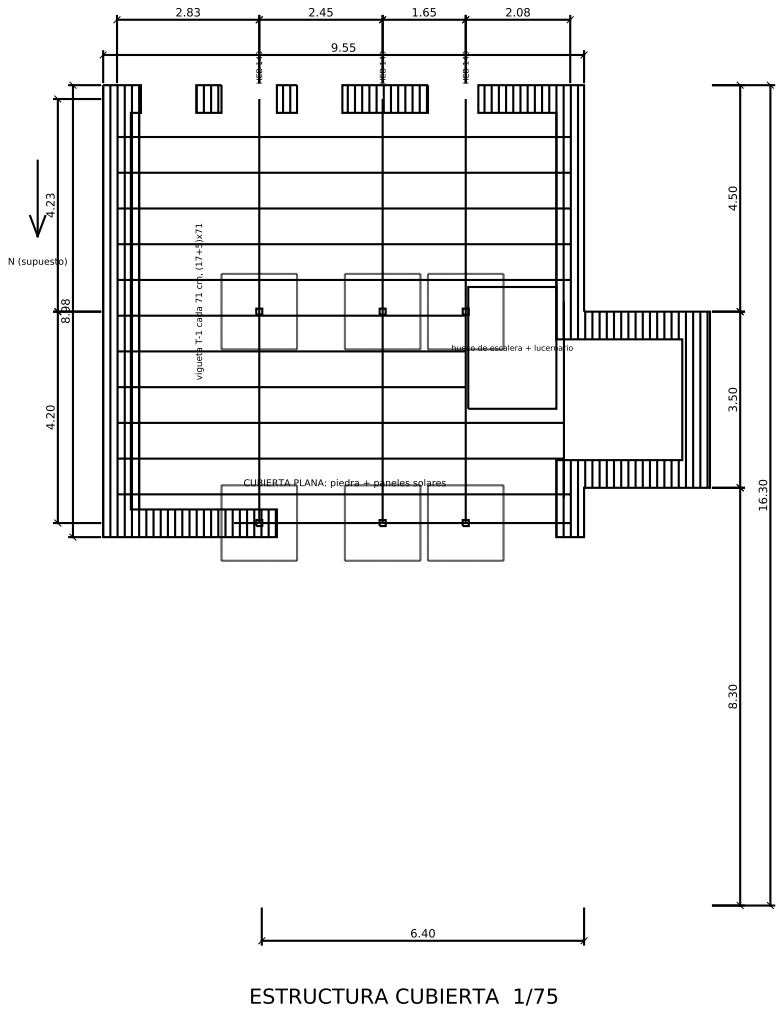
[picture p77: page 1]
