wspoolcover/toldos/cortijo/pdf/planos/estructura_forjado_v8.pdf

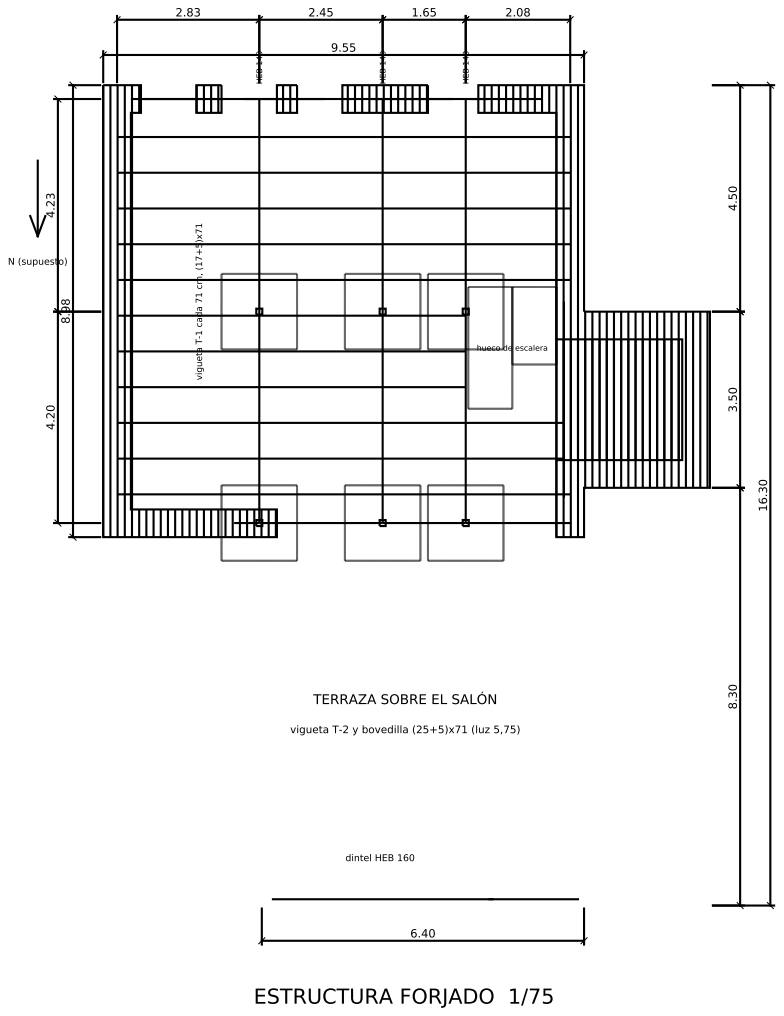
[picture p78: page 1]
