wspoolcover/toldos/cortijo/pdf/planos/lamina_A1_v8_distribucion.pdf

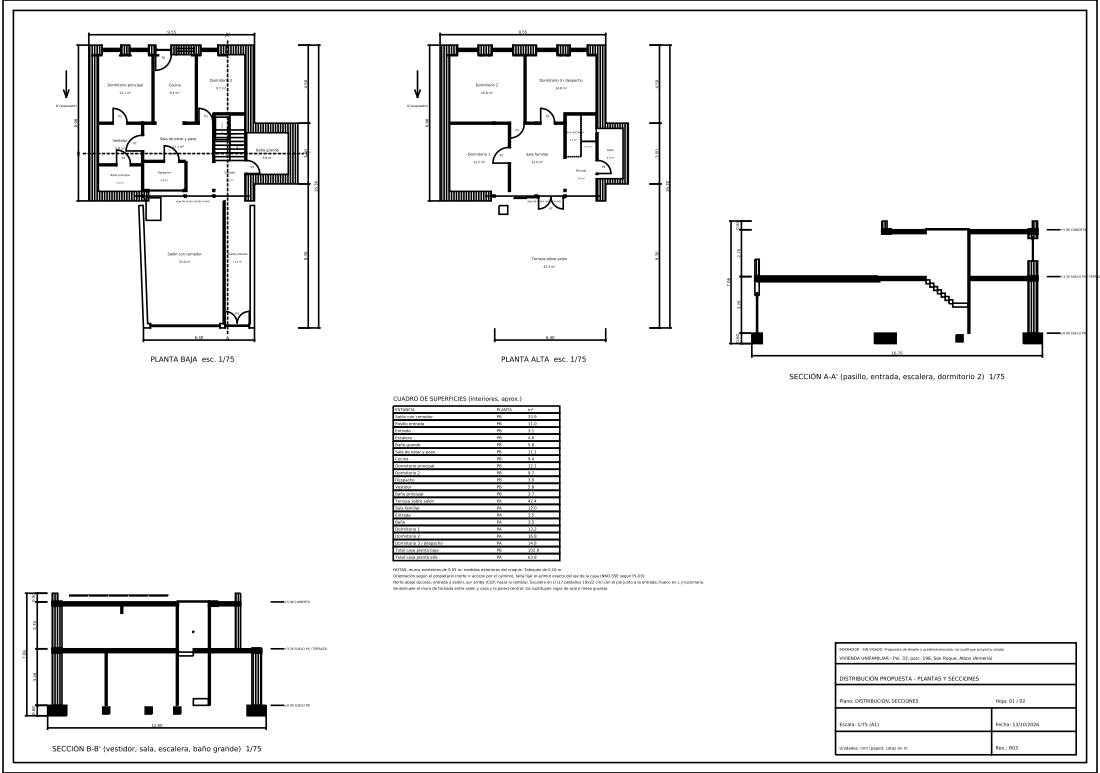
[picture p79: page 1]
