wspoolcover/toldos/cortijo/pdf/planos/lamina_A1_v8_estructura.pdf

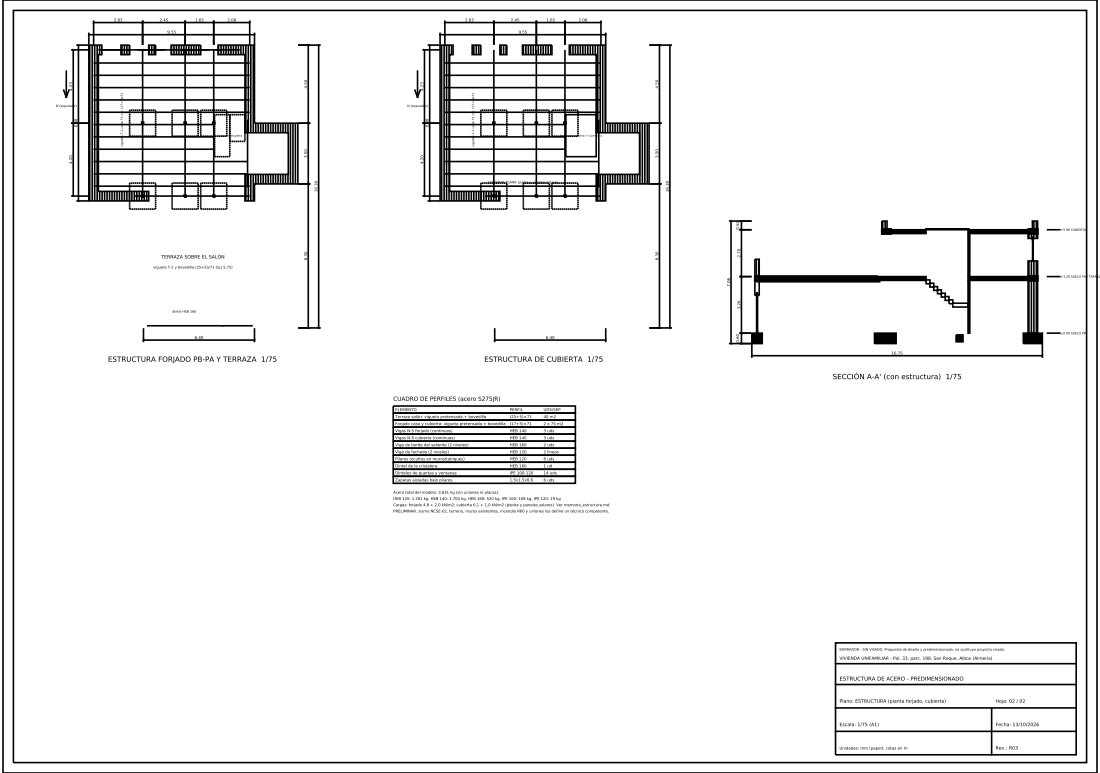
[picture p80: page 1]
