wspoolcover/toldos/cortijo/pdf/planos/planta_alta_v8.pdf

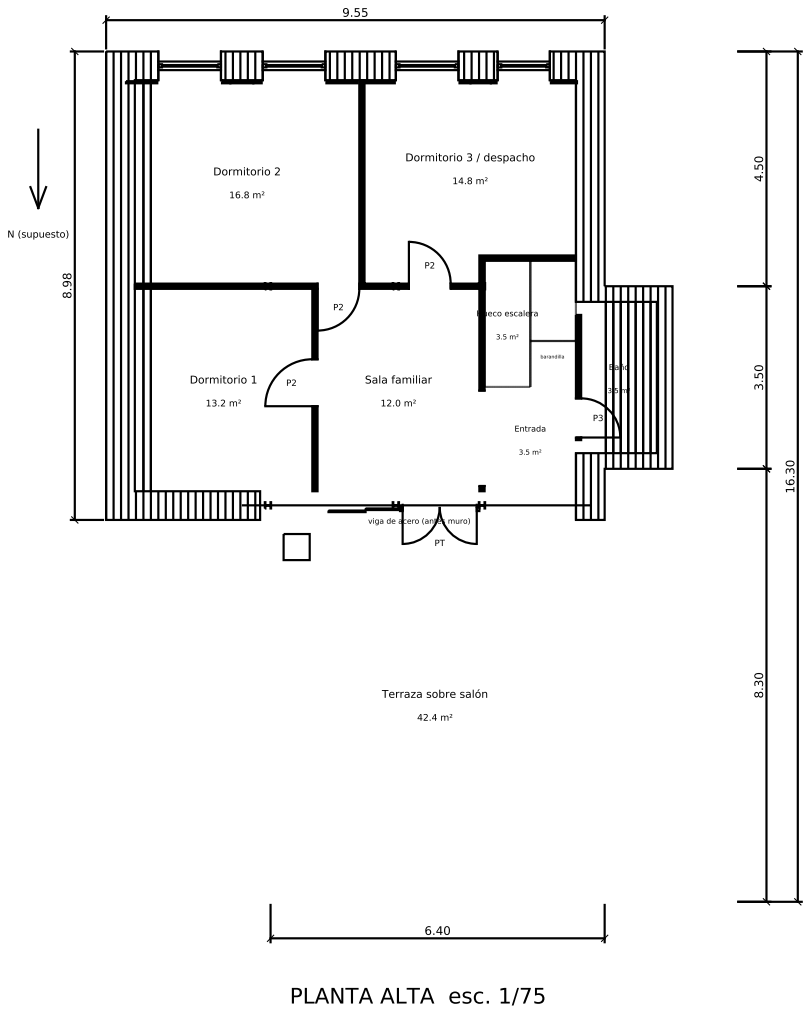
[picture p81: page 1]
