wspoolcover/toldos/cortijo/pdf/planos/planta_baja_v8.pdf

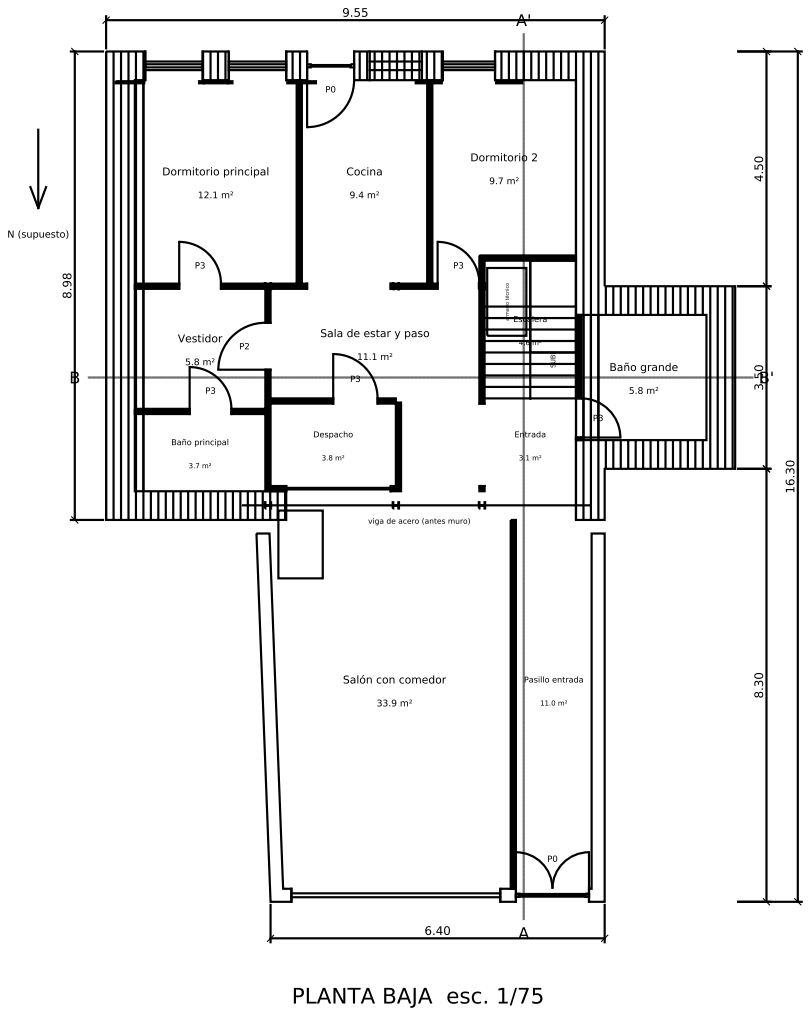
[picture p82: page 1]
