wspoolcover/toldos/cortijo/pdf/planos/seccion_A_v8.pdf

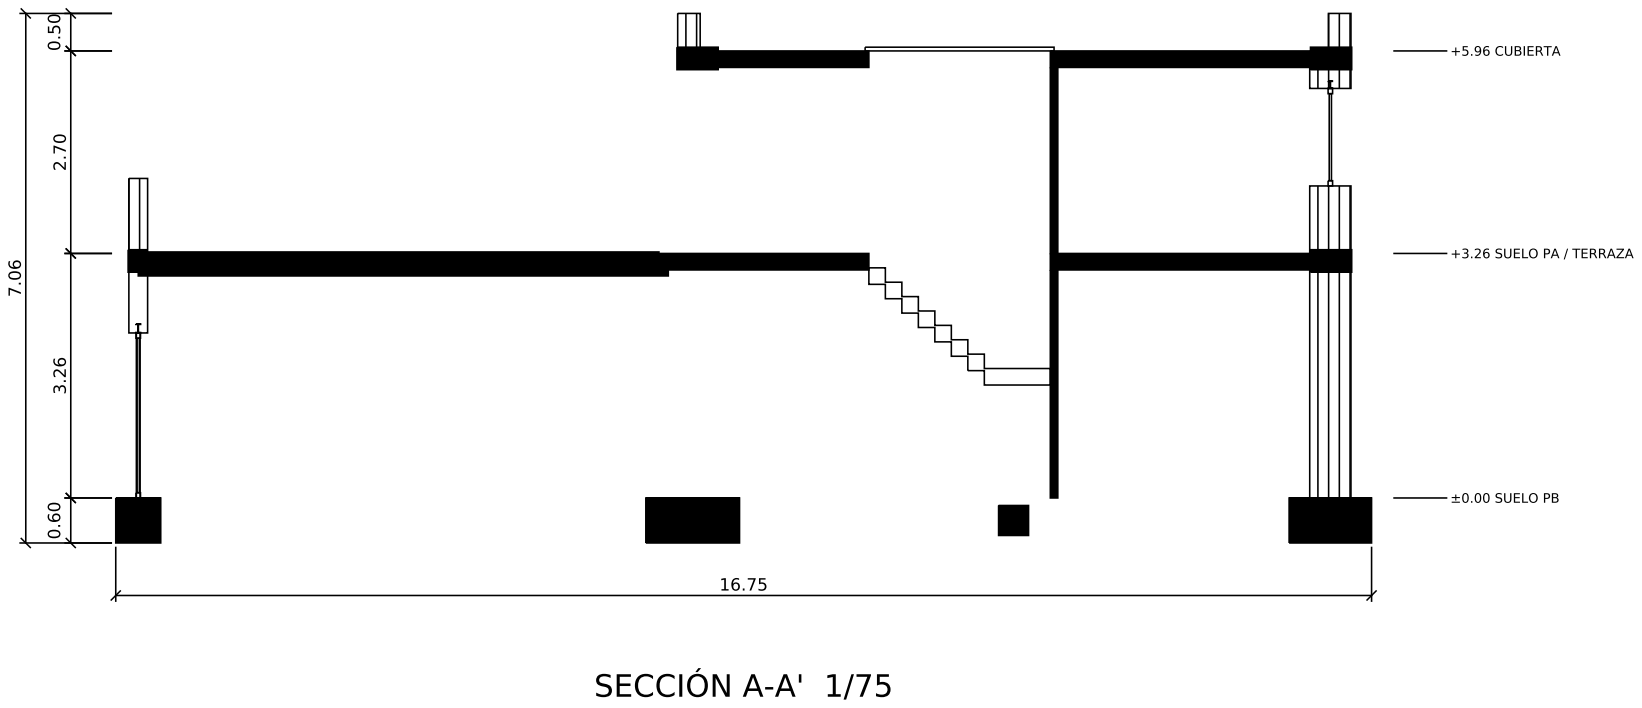
[picture p83: page 1]
