wspoolcover/toldos/cortijo/pdf/planos/seccion_B_v8.pdf

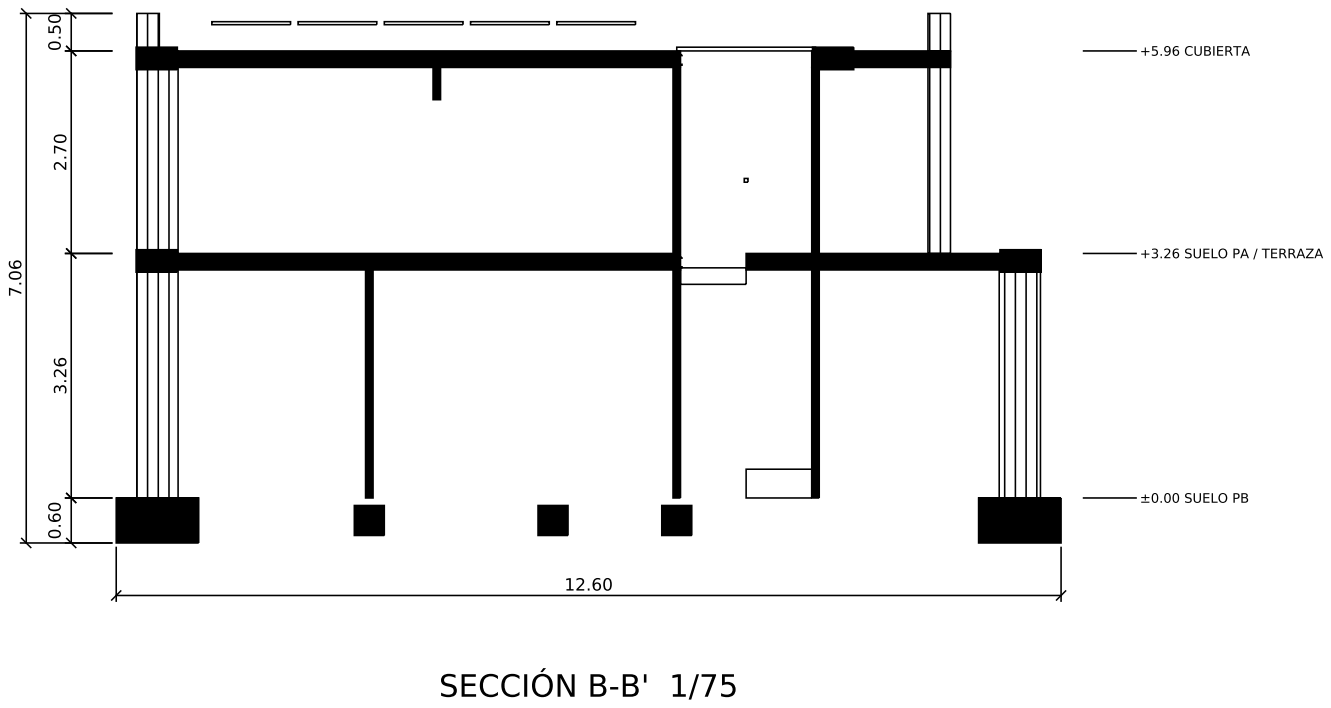
[picture p84: page 1]
