wspoolcover/toldos/(commit log)

2026-09-28 Añadir modelo 3D paramétrico de la vivienda (CadQuery, STEP y GLB)
    Muro central continuo desde cimentación hasta cubierta.
    Claude-Session: https://claude.ai/code/session_01GrFzVPJDRJqirwnmNdffa5
    [casa.step]
2026-09-28 Añadir plantas y secciones DXF generadas desde el modelo 3D
    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
    [casa.step, planta_alta.dxf, planta_baja.dxf, seccion_longitudinal_muro_central.dxf, seccion_transversal.dxf]
2026-09-28 Añadir cotas, carpintería y lámina A1 con cajetín a los DXF
    Puertas y ventanas parametrizadas en casa.py; plantas y secciones acotadas.
    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
    [casa.step, lamina_A1.dxf, planta_alta.dxf, planta_baja.dxf, seccion_longitudinal_muro_central.dxf, seccion_transversal.dxf]
2026-09-28 Añadir rayado de muros, forjados y cimentación a plantas y secciones DXF
    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
    [casa.step, lamina_A1.dxf, planta_alta.dxf, planta_baja.dxf, seccion_longitudinal_muro_central.dxf, seccion_transversal.dxf]
2026-09-29 Añadir envolvente v2 sobre el croquis a mano: modelo 3D, planos DXF y lámina 1/75
    Salón con cristalera doble de 6,40 m, puerta y murete de pasillo; muro central continuo.
    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
    [casa.step, casa_v2.step, lamina_A1_v2.dxf, planta_alta_v2.dxf, planta_baja_v2.dxf, seccion_longitudinal_v2.dxf, seccion_transversal_v2.dxf]
2026-09-29 Añadir distribución propuesta y estructura de acero predimensionada (modelo 3D, planos DXF, láminas y memoria)
    Muros existentes de 0,55 m, escalera en U con lucernario, forjados con viguetas IPE y vigas HEB, cubierta plana con piedra y paneles solares.
    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
    [casa.step, casa_v3.step, estructura_cubierta_v3.dxf, estructura_forjado_v3.dxf, lamina_A1_v3_distribucion.dxf, lamina_A1_v3_estructura.dxf, planta_alta_v3.dxf, planta_baja_v3.dxf]
2026-09-29 Sustituir el muro de fachada por viga de acero y quitar la pared central de carga
    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
    [casa.step, casa_v3.step, estructura_cubierta_v3.dxf, estructura_forjado_v3.dxf, lamina_A1_v3_distribucion.dxf, lamina_A1_v3_estructura.dxf, planta_alta_v3.dxf, planta_baja_v3.dxf]
2026-09-29 Añadir dos opciones de distribución en planta (A y B) con entrada por pasillo con murete, escalera y baño juntos, sin pasillos largos
    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
2026-09-29 Rediseñar distribución: suite con paso de vestidor y baño, saliente de planta alta a la mitad y dos opciones (oficina abajo o arriba)
    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
2026-09-29 Mover la oficina al ala oeste o al norte y rehacer la suite en dos variantes
    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
2026-09-29 Opción 2: oficina acristalada con cristalera de suelo a techo al sur y tabiques de vidrio
    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
2026-09-29 Salón con comedor dentro, chimenea en el muro oeste y cristalera frontal junto a la puerta; oficina normal
    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
2026-09-29 Nueva distribución: suite con acceso por el vestidor, cocina con puerta al fondo, salón con sofá en U, pantalla y chimenea en el rincón
    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
2026-09-29 Orientar la distribución: norte hacia abajo (calle y salón), sur arriba
    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
2026-09-29 Pasar la distribución al modelo 3D: suite por el vestidor, cocina al fondo, salón con chimenea y cristalera, escalera nueva
    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
    [casa.step, casa_v3.step, estructura_cubierta_v3.dxf, estructura_forjado_v3.dxf, lamina_A1_v3_distribucion.dxf, lamina_A1_v3_estructura.dxf, planta_alta_v3.dxf, planta_baja_v3.dxf]
2026-09-29 Optimizar y completar la estructura: vigas continuas, viguetas cada 1,2 m, viga de borde del saliente, dinteles, planos de vigas y notas de ahorro
    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
    [casa.step, casa_v3.step, estructura_cubierta_v3.dxf, estructura_forjado_v3.dxf, lamina_A1_v3_distribucion.dxf, lamina_A1_v3_estructura.dxf, planta_alta_v3.dxf, planta_baja_v3.dxf]
2026-09-29 Terraza del salón en vigueta pretensada y bovedilla, zunchos de hormigón, riostras y comprobación sísmica orientativa
    Acero del modelo: 4.977 kg (−25 % sobre el primer diseño).
    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
    [casa.step, casa_v3.step, estructura_cubierta_v3.dxf, estructura_forjado_v3.dxf, lamina_A1_v3_distribucion.dxf, lamina_A1_v3_estructura.dxf, planta_alta_v3.dxf, planta_baja_v3.dxf]
2026-09-29 Forjados de la casa y la cubierta en vigueta pretensada y bovedilla; acero 3.615 kg (−46 % sobre el primer diseño)
    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
    [casa.step, casa_v3.step, estructura_cubierta_v3.dxf, estructura_forjado_v3.dxf, lamina_A1_v3_distribucion.dxf, lamina_A1_v3_estructura.dxf, planta_alta_v3.dxf, planta_baja_v3.dxf]
2026-09-29 Muros de ladrillo de 25 cm y cimentación de 60 cm en el salón: modelo, planos, cimentación comprobada y sismo actualizados
    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
    [casa.step, casa_v3.step, estructura_cubierta_v3.dxf, estructura_forjado_v3.dxf, lamina_A1_v3_distribucion.dxf, lamina_A1_v3_estructura.dxf, planta_alta_v3.dxf, planta_baja_v3.dxf]
2026-09-30 Añadir dossier PDF para obra: cimentación, secciones, estructura de acero, despiece, zunchos y orden de obra
    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
2026-09-30 Suite: dormitorio reducido, rincón de lectura y despacho pequeño
    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
2026-10-12 Proyecto cortijo: carpeta, modelo v4 (suite compacta, despacho), DXF v4 y documentos de instalaciones, envolvente, cimentación y ahorro
    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
2026-10-12 Distribución opción 2: suite, dormitorio 2 y despacho en el salón; modelo y DXF v5
    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
2026-10-12 Despacho junto al vestidor, chimenea en el salón, escalera de 17 contrahuellas; modelo y DXF v6
    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
2026-10-12 Revisión de optimización: pilares fuera de huecos, luces reales, cocina en U, informe de opciones
    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
2026-10-12 v7: dormitorios de arriba parejos, armarios empotrados, planos de instalaciones, cubierta solar, presupuesto y ahorro
    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
2026-10-12 Script de render con Blender (materiales procedurales)
    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
2026-10-12 v7: muros del salón como pieza propia (ladrillo visto en el render); ajustes de exposición
    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
2026-10-12 Estilo cortijo: carpintería de madera, vidrios, puertas y solado de barro en el modelo; materiales encalado y piedra marés en el render
    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
2026-10-12 Corredera de 1,60 de la sala familiar a la terraza; sofá reubicado
    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
2026-10-12 Carpintería separada por planta; exposición propia para la vista interior
    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
2026-10-12 Medianeras este/oeste sin ventanas, paso libre a la terraza (parapeto y pilar), terreno 130 kPa de PL-11, acometidas por el sur y fosa al norte
    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
2026-10-12 Render: vistas exteriores restauradas; sin dinteles flotantes en la planta abierta
    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
2026-10-12 Renders v7 con paso abierto a la terraza
    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
2026-10-12 Decisión: carpintería de PVC (acabado madera, cristalera y contraventanas)
    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
2026-10-12 Mediciones de carpintería y hierro y Excel de pedido a proveedores con hoja de ahorro
    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
2026-10-12 Corrige recuento de puertas
    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
2026-10-12 Plano de cimentación y zunchos (propuesta generosa) con DXF, alzado del muro lateral y detalles
    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
2026-10-12 Fotos del estado real: tapial, CGP trifásica, zanjas y apeos; ajustes de aislamiento, electricidad y cimentación
    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
2026-10-12 Orientación según el arquitecto: sur a la calle, norte terreno propio; aerotermia en cubierta
    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
2026-10-12 Visor y renders con la orientación del arquitecto (sur a la calle, aerotermia en cubierta)
    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
2026-10-13 Terreno según fotos y catastro; paquete de entrega v7
    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
2026-10-13 Segunda tanda de fotos del terreno: arcilla agrietada, muros de hormigón, línea aérea
    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
2026-10-13 Orientación confirmada: acceso y agua al norte, CGP al sur hacia la rambla; instalaciones y visor corregidos
    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
2026-10-13 Datos de la finca y ubicación (registro y UTM del arquitecto)
    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
2026-10-13 v8: escalera reubicada, cocina abierta a la sala y puertas libres
    - La escalera pasa a tener el pie en y=9,65 (huella 22 cm, meseta 88 cm, tramo de vuelta en losa con paso libre debajo): ya no tapa la cocina ni el baño grande.
    - Cocina al centro (9,4 m²) abierta a la sala de estar por un paso libre de 1,60 m; dormitorio 2 al este; entradas de las dos plantas mayores; hueco superior en L.
    - verificar_circulacion.py: comprueba sobre el GLB que se llega de cada estancia a las demás con 0,70 m (falla con v7, pasa con v8).
    - Corregidos fallos de mobiliario que tapaban puertas (inodoro de la suite, armario del vestidor, sofá y armario de arriba, puertas sobre pilar y tabique).
    - 16 paneles sol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
2026-10-14 Propuestas de planta baja (A, B, C), PDF de todo el proyecto y muebles libres
    - docs/15_propuestas_planta_baja.md y modelos_pb.py: tres modelos con cocina más amplia y salida de aluminio, puerta del vestidor, muros y puertas de seguridad y asientos en las ventanas del sur (con las fuentes consultadas).
    - generar_pdf.py: dossier completo en PDF, un PDF por documento y los planos DXF en PDF vectorial (carpeta pdf/).
    - descargar_muebles.py: 38 piezas libres (CC0, Poly Haven) para los renders; muebles_disponibles.png.
    - docs/00_resumen.md y docs/99_pendientes.md.
    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
2026-10-14 Ideas de obra de referencia: viga sobre pilarete de bloque, placas alveolares y apoyo de la placa superior
    - docs/16_ideas_de_obra_referencia.md: qué se ve en las capturas de una constructora, qué aprovechar (dintel HEB sobre pilarete de bloque relleno, zuncho de bloque en U, placas alveolares para el salón, puntales, cargaderos), qué no copiar en los dormitorios de seguridad y cómo apoya la placa superior.
    - detalles_apoyo.py: esquemas de apoyo de la placa sobre zuncho, sobre viga HEB y de viga sobre pilarete.
    - Dossier y PDFs actualizados.
    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
2026-10-14 Vigas de hormigón con bloque en U: tabla de usos y esquemas
    - docs/16: sección 6 con qué elementos se pueden hacer con bloque en U (zunchos, dinteles hasta 2 m, huecos sala-cocina) y cuáles no (cristalera de 4,40 m, vigas N-S, riostras).
    - viga_bloque_u.png: sección de la viga y dintel sobre un hueco con puntales.
    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
2026-10-14 Opción C2: cocina central con el despacho girado de la puerta del vestidor a la chimenea
    - modelos_pb.py: modelo C2 (despacho de 1,80 x 2,65 m a lo largo de la pared del vestidor, cristal hacia el salón y la chimenea, sala de estar de 10,1 m²).
    - pdf_opcion_c.py: PDF de dos páginas de la opción (pdf/Opcion_C_cocina_central.pdf).
    - docs/15 y 99 actualizados; dossier y PDFs regenerados.
    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
2026-10-14 Versión económica y rápida de la opción C2, y todo el proyecto en un solo PDF
    - economica.py y docs/17_version_economica.md: tabla de partidas (completa frente a económica), ahorro estimado 30-53 mil euros sin recortar cimentación, estructura, aislamiento ni seguridad, paquete de seguridad, plazos, fases y qué queda preparado.
    - version_economica_costes.png y modelo_C2E_planta_baja.png (una despensa-lavadero, salida de PVC y rejas).
    - generar_pdf.py: un solo PDF (pdf/Cortijo_Albox_Proyecto_completo.pdf, 53 páginas) con la opción C2, la versión económica y todo lo anterior.
    Claude-Session: https://claude.ai/code/session_01G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
2026-10-15 Opción D: suite a la izquierda, cocina en medio y dormitorio pequeño con armario bajo la escalera
    - modelos_pb.py: opción D (cocina de 9,4 m², dormitorio 2 de 9,5 m² con puerta de seguridad y asiento en la ventana, armario incorporado de unos 2,0 m² bajo la meseta y el tramo de vuelta de la escalera, armario técnico en el rincón junto a la entrada, despacho girado).
    - pdf_opcion_d.py: PDF de 3 páginas de la opción (pdf/Opcion_D_suite_cocina_dormitorio.pdf).
    - docs/15 y README actualizados; PDF único del proyecto regenerado (54 páginas).
    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
2026-10-15 Opción D: PDF de dos páginas y PDF único regenerado
    - La portada del PDF de la opción D lleva el plano en la primera página.
    - Proyecto completo en un solo PDF regenerado con la opción D.
    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
2026-10-28 Fosa séptica y pozo filtrante: documento 18, esquemas y tabla de diámetros del pozo de 5 m
    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
2026-11-04 Pedido de hierro de zunchos, riostras y suelo: barras, cercos, mallazo y calculadora del muro exterior
    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
2026-11-04 Comprobación de la cimentación y Pedido 1 de hierro (zapatas y riostras) con lista de cortes
    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
2026-11-04 Zanja perimetral 40x40 y anillos de atado en el pedido de cimentación; comparación con el proyecto original del arquitecto
    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
2026-11-04 Proyecto visado del arquitecto (PL-04 a PL-11): comparación, recubrimientos, hormigones y solapes aplicados al pedido de cimentación
    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
2026-11-04 Adaptar el proyecto visado a la casa que se construye: cambios por lámina, cuadro de superficies y aviso de muros caídos
    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
2026-11-04 Estado de obra: han caído muro norte, muro central, forjado de planta alta y tejado; quedan en pie los muros este y sur
    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
2026-11-04 Foto interior de obra: muros que se ven en pie, pendientes de identificar
    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
2026-11-04 Orden de ejecución de la cimentación: bataches alternos de la zanja perimetral y apeo de los muros en pie
    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
